HateFindingNames/MotherBoard/README.md

# What the hell is this?
A brief write up of my project assignment for university :woman_shrugging:
