HateFindingNames/MotherBoard/Footage/AwesomeBoard Transmission CAD/readme.md

# Honor where honor is due :bowing_woman:
Solidworks model for Caliber II Trucks by [Myles](https://grabcad.com/library/caliber-trucks-1)

Solidworks model for Orangatang Kegel Wheels by [Danny Andreev](https://grabcad.com/library/orangatang-kegel-80mm-80a-orange-longboard-wheel-1)
