HateFindingNames/MotherBoard/chapters/5_electronics.tex

% LTeX: language=de-DE
\chapter{Elektronik}
\nomenclature[A]{Gegen-EMK}{Gegenwirkende elektromotorische Kraft}%
\nomenclature[A]{AWG}{American Wire Gauge}%
\nomenclature[G]{\(\omega_\text{e}\)}{Elektrische Drehzahl\nomunit{\per\minute}}%
	\nomenclature[G]{\(\omega\)}{Momentane mechanische Drehzahl\nomunit{\per\minute}}%
	Die verwendeten ESC sind in der Lage, die gegenwirkende elektromotorische Kraft (Gegen-EMK) --~eine während des Betriebes in den Wicklungen des Motors induzierte und seiner Drehrichtung entgegenwirkenden Spannung --~zu Messen und zur Positionsbestimmung des Rotors zu nutzen.
	Gegenüber eines trapezoidalen Phasenstromes können die Motorwicklungen so sinusoidal bestromt werden, was wiederum geringere elektrische Verluste und ein gleichmäßigeres Drehmomentprofil während eines Umlaufes und damit einen sanfteren und geräuschärmeren Motorlauf verspricht.
	Prinzipbedingt steigt die Amplitude der rEMK mit der Drehzahl des Motors.
	Konsequenterweise wird so die Messung und damit die Positionsbestimmung im niedrigen Drehzahlbereich erschwert während sie im Stillstand unmöglich wird.
	Um ein exaktes Feedback der Rotorposition an die Steuerelektronik unabhängig der rEMK zu ermöglichen, verfügen die ausgewählten Motoren über integrierte Hall-Effekt-Sensoren.
	Im höheren Drehzahlbereich verschwinden ihre Vorteile zwar zunehmend, liefern jedoch die Möglichkeit eines äußerst sanften Anlaufes aus dem Stillstand heraus.\par\medskip
	%
	\begin{wrapfigure}{r}{.5\textwidth}
		\centering
		
		\caption[Hall-Sensoren Steckverbinder]{Links ein 3x2-Pin Molex Micro-Fit 3.0 Steckverbinder, rechts ein 6-Pin JST-PH \qty{2}{\milli\metre} zur Verbindung mit dem ESC.}
		\label{fig:hall sensor connectors}
	\end{wrapfigure}
	Die ab Werk mit JST-PH \qty{2}{\milli\metre} Steckverbindern ausgestatteten Sensorenleitungen wurden im Sinne einer Staub- und Spritzwassergeschützen Durchführung in das GFK-Gehäuse über eine Kabelbrücke mit den ESC verbunden.
	Die Kabelbrücke wurde aus 30AWG\footnote{\hspace{1mm}Entspricht etwa \qty{0,25}{\milli\metre\squared}.} flexibler Silikonleitung mit einem 6-Pin JST-PH Steckverbinder ESC-seitig und einem 3x2 Molex Micro-Fit 3.0 Steckverbinder motorseitig gefertigt (vgl. \cref{fig:hall sensor connectors}).
	Für den motorseitigen Anschluss wurde eine entsprechende Öffnung in das Gehäuse geschnitten und der Steckverbinder mit Epoxidharz dauerhaft und dicht verbunden.
	Die Anordnung der Sensoren spielt an dieser Stelle eine untergeordnete Rolle, da sie vor Inbetriebnahme softwareseitig konfiguriert werden können.
	Es wird lediglich darauf geachtet, dass die Anordnung beider Motoren identisch bleibt.
	Zur Durchführung der Phasenleitungen werden je Motor drei Löcher in das Gehäuse gebohrt und mit Gummi-Durchführungen versehen.\par\medskip
	%
	Die Leistungsendstufe ist als Doppel-H-Brücke implementiert und in \cref{fig:power mosfets} gezeigt\footnote{\hspace{1mm}Als Gate-Treiber ist ein \textit{DRV8302} von \textit{Texas Instruments} verbaut. Im Datenblatt unter ``STARTUP AND SHUTDOWN SEQUENCE CONTROL'' ist zu lesen, dass alle Gate-Verbindungen Low gehalten werden bis \texttt{EN\_GATE} High ist und \(\geq \qty{10}{\milli\second}\) vergangen sind~\cite{drv8302.datasheet}. Die Low-seitigen Pull-Down Widerstände R30,36,46 dienen vermutlich einem sichergestellt hochohmigen Zustand der Low-Side-FETs im Einschaltmoment als zusätzliche Sicherheitsschicht um Kurzschluss von \texttt{V\_SUPPLY} gegen Ground zu verhindern}.
	Um den Rotor um \qty{360}{\degree} dividiert durch die Anzahl der magnetischen Pole des Rotors \(n_\text{p}\)\nomenclature[L]{\(n_\text{p}\)}{Anzahl der magnetischen Rotorpole\nomunit{1}} zu drehen, muss ein voller Kommutationszyklus durchgeführt werden, was im Folgenden einer elektrischen Umdrehung entsprechen soll.
	Die Anzahl elektrischer Umdrehungen je Minute bei gegebener mechanischer Drehzahl des Rotors sei gegeben durch:
	\begin{align}
		\omega_\text{e} = \omega \, n_\text{p}
		\label{eq:ERPM and RPM}
	\end{align}
	%
	Die Maximalgeschwindigkeit skaliert somit direkt proportional mit \(\omega_\text{e}\) und kann in~\unit{\kilo\metre\per\hour} geschrieben werden als
	\begin{align}
		v_\text{max} = \omega_\text{e} \, \frac{2\pi \, r}{n_\text{p} \, \zeta} \cdot 0,06
		\label{eq:max speed by ERPM}
	\end{align}
	Mit Unterstützung der Konfigurationssoftware der ESC obere Grenzwerte für \(\omega_\text{e}\) zu hinterlegen ist es möglich unmittelbar Werte für die Maximalgeschwindigkeit zu definieren (vgl. \cref{fig:ESC erpm setting}).
