HateFindingNames/MotherBoard/chapters/3_theory.tex

% LTeX: language=de-DE
\chapter{Theorie}\label{sec:theory}
\nocite{Meschede.2015}\nocite{Demtroder.2018}
% ===============================================
% Nomenclatures
% ===============================================
\nomenclature[G]{\(\theta\)}{Hangneigungswinkel\nomunit{rad}}%
\nomenclature[L]{\(F_\text{Hang}\)}{Hangabtriebskraft\nomunit{\newton}}%
\nomenclature[L]{\(G\)}{Gefälle\nomunit{\percent}}%
\nomenclature[G]{\(\mu_\text{Roll}\)}{Rollreibungskoeffizient\nomunit{\metre}}%
\nomenclature[L]{\(F_\text{Ström}\)}{Strömungswiderstand\nomunit{\newton}}%
\nomenclature[G]{\(\rho\)}{Gasdichte\nomunit{\kilo\gram\per\cubic\metre}}%
\nomenclature[L]{\(A\)}{Fläche\nomunit{\square\metre}}%
\nomenclature[L]{\(c_\text{Luft}\)}{Strömungswiderstandkoeffizient\nomunit{1}}%
\nomenclature[L]{\(v\)}{Laterale Geschwindigkeit\nomunit{\metre\per\second}}%
\nomenclature[L]{\(M_\text{Hang}\)}{Drehmoment entlang eines Hanges\nomunit{\newtonmetre}}%
\nomenclature[L]{\(K_\text{V}\)}{Drehzahlkonstante\nomunit{\per\minute\per\volt}}%
\nomenclature[G]{\(\omega_\text{max}\)}{Maximale mechanische Drehzahl\nomunit{\per\minute}}%
\nomenclature[G]{\(\zeta\)}{Untersetzungsverhältnis\nomunit{1}}%
\nomenclature[L]{\(N_\text{Rolle}\)}{Zähneanzahl getriebeseitig\nomunit{1}}%
\nomenclature[L]{\(N_\text{Motor}\)}{Zähneanzahl antriebseitig\nomunit{1}}%
\nomenclature[L]{\(v_\text{max}\)}{Maximalgeschwindigkeit\nomunit{\kilo\metre\per\hour}}%
\nomenclature[L]{\(U_\text{Bat}\)}{Batteriespannung\nomunit{\volt}}%
\nomenclature[L]{\(r_\text{Rolle}\)}{Radius der Rollen\nomunit{\metre}}%
\nomenclature[L]{\(K_\text{T}\)}{Drehmomentkonstante\nomunit{\newtonmetre\per\ampere}}%
\nomenclature[L]{\(M\)}{Drehmoment\nomunit{\newtonmetre}}%
\nomenclature[L]{\(I_\text{Motor}\)}{Phasenstrom\nomunit{\ampere}}%
%
	Die mechanische Gesamtleistung, die vom System auf den Boden übertragen werden muss, ist die Summe unterschiedlicher Einzelfaktoren.
	Neben der erforderlichen Leistung, um die träge Masse von Maschine und Pilot aus dem Stand auf eine gewünschte Geschwindigkeit zu beschleunigen, müssen zusätzliche Reserven zur Verfügung stehen, um mechanische Verluste wie Rollwiderstand zum Untergrund, bei höheren Geschwindigkeiten zunehmend aerodynamische Effekte oder Hangabtriebskräfte während des Befahrens von Steigungen überwinden zu können.\par\medskip
	%
	Die Hangabtriebskraft mit dem Neigungswinkel \(\theta\) ist durch
	\begin{equation}
		F_\text{Hang} = m \, g \, \sin\!\left(\theta\right)%
		\label{eq:downhill force}
	\end{equation}%
	
	gegeben und wird mit der Umrechnung der im Straßenverkehr üblichen Angaben in~\unit{\percent} zu~\unit{\radian} durch \(\arctan\!\left(\frac{G}{\qty{100}{\percent}}\right)\) zu
	\begin{equation}
		F_\text{Hang} = m \, g \, \sin\!\left(\arctan\!\left(\frac{G}{\qty{100}{\percent}}\right)\right).%
		\label{eq:downhill force incline to radian}
	\end{equation}
	\begin{figure}[h]
		\centering
		\includesvg[width=.6\textwidth, inkscapelatex=true]{Calc/torque_incline}
		\caption[Skizze aller wirkenden Kräfte bei einer Fahrt Hangaufwärts]{Skizze aller wirkenden Kräfte bei einer Fahrt Hangaufwärts.}%
		\label{fig:sketch torque incline}
	\end{figure}

	Der Rollwiderstand wird beschrieben durch:
	\begin{equation}
		F_\text{Roll} = m \, g \, c_\text{Roll}
		\label{eq:rolling resistance}
	\end{equation}%
	
	mit dem dimensionslosen Rollwiderstandskoeffizienten \(c_\text{Roll}\) der wiederum das Verhältnis aus Rollreibungskoeffizienten \(\mu_\text{Roll}\) und dem Radius der Rollen nach \(\frac{\mu_\text{Roll}}{r}\) beschreibt.\par\medskip
	%
	Die durch Reibung bei Durchgang eines Körpers durch ein fluides Medium (hier Luft) verursachte, der Bewegung entgegen gerichtete Kraft errechnet sich aus:
	\begin{align}
		F_\text{Ström} = \frac{1}{2} \, c_\text{Ström} \, \rho \, A \, v^2
		\label{eq:air drag}
	\end{align}%

	Nun lässt sich mit bekanntem Radius der Rolle und unter Berücksichtigung von \crefrange{eq:downhill force incline to radian}{eq:air drag} für das rückwirkende Drehmoment schreiben:
	\begin{align}
		M_\text{Hang}	&= \left(F_\text{Hang} + F_\text{Roll} + F_\text{Ström}\right) r \nonumber \\
						&= \left[ m \, g \left( \sin\!\left(\arctan\!\left(\frac{G}{\qty{100}{\percent}}\right)\right) + c_\text{Roll} \right) + \frac{1}{2} \, c_\text{Ström} \, \rho \, A \, v^2 \right] r%
		\label{eq:incline plus roll plus drag torque}
	\end{align}%
	\section{Elektromotorische Zusammenhänge}
		In technischen Dokumentationen zu BLDC-Motoren findet sich häufig die Angabe der Drehzahlkonstante \(K_\text{V}\), die über die Anzahl der Umdrehungen des Rotors je Minute und Volt Phasenspannung Auskunft gibt.
		Die theoretische Maximaldrehzahl des Rotors ergibt sich hiermit zu:
		\begin{align}
			\omega_\text{max} = K_\text{V} \, U_\text{Bat}
			\label{eq:max rpm}
		\end{align}%
		Die mechanische Untersetzung sei das Verhältnis aus der Anzahl der Zähne der zweier gekoppelter Zahnriemenscheiben wie in \cref{eq:reduction}.
		\begin{align}
			\zeta = \frac{N_\text{Rolle}}{N_\text{Motor}}
			\label{eq:reduction}
		\end{align}%
		Mit bekanntem Umfang der Rollen und Berücksichtigung der Untersetzung lässt sich nun die theoretische Maximalgeschwindigkeit unter Vernachlässigung von elektrischen und thermischen Verlusten schreiben als
		\begin{align}
			v_\text{max} = K_\text{V} \, U_\text{Bat} \, 2\pi \, r_\text{Rolle} \, \frac{0,06}{\zeta}
			\label{eq:max speed km h}
		\end{align}%
		wobei der Faktor~\num{0,06} in  die Einheit~\unit{\kilo\metre\per\hour} überführt.
		%
		Fundamental sind Drehzahlkonstante \(K_\text{V}\) und Drehmomentkonstante \(K_\text{T}\) gleich und lassen sich über folgenden Zusammenhang ineinander überführen~\cites{mevey2009sensorless}{DalY.Ohm.2000}{AN885.BLDC.fundamentals}:
		\begin{align}
			K_\text{T}	&= \frac{60}{2\pi} \, \frac{3}{2} \, \frac{1}{\sqrt{3}} \, \frac{1}{K_\text{V}} \nonumber \\
				&\approx 8,27 \, \frac{1}{K_\text{V}}
			\label{eq:kv to kt}
		\end{align}%
		Der Faktor \(\frac{3}{2}\) korrigiert für den Fall einen sinusoidalen Spannungsverlaufs der Kommutation\footnote{\hspace{1mm}Faktor 2 bei trapezoidalem Spannungsverlauf und --~interessant genug --~damit ein höheres Drehmoment.}~\cites{mevey2009sensorless}{DalY.Ohm.2000}, die Spannung zwischen einer Phase und dem~(nicht nach außen geführten) Neutralpunkt ist im Falle eines 3-Phasen Motors um den Kehrwert des Verkettungsfaktors \(\frac{1}{\sqrt{3}}\) kleiner.
		Letztlich wird mit \(\frac{60}{2\pi}\) in die Einheit~\unit{\newtonmetre\per\ampere} überführt.\par\medskip
		%
		Das vom System erzeugte, verlustfreie Drehmoment errechnet sich aus obigem zu:
		\begin{align}
			M	&= K_\text{T} \, I_\text{Motor} \, \zeta
			\label{eq:frictionless torque}
		\end{align}
