HateFindingNames/MotherBoard/pre-page-layout.tex

%A4: 210x297 (BxH)
% \setlength{\voffset}{-2.532 cm}
% \setlength{\hoffset}{-1.57 cm}
\setlength{\voffset}{-2.5 cm}
\setlength{\hoffset}{-2 cm}
% \setlength{\topmargin}{2.0 cm} \setlength{\topskip}{0.1 cm}
\setlength{\topmargin}{1.5 cm}
\setlength{\topskip}{0.1 cm}
\setlength{\evensidemargin}{1.5 cm}
\setlength{\oddsidemargin}{1.5 cm}
%  \setlength{\textwidth}{16.5 cm}
\setlength{\textwidth}{16.0 cm}
\setlength{\footskip}{40pt}
\setlength{\textheight}{24.7cm}
% \setlength{\textheight}{23.5 cm}
\setcounter{page}{1}
\setlength{\parindent}{0.5cm}
\setlength{\headsep}{20pt}
%------------------ Kopf- und Fusszeilen
\setkomafont{pageheadfoot}{\footnotesize\sffamily}
% \renewcommand{\footnote}[1]{\footnote{\quad#1}}
\counterwithout{footnote}{chapter}
%------------------------------------------------------------------------
% Linien in der Kopf- und Fußzeile
%\renewcommand{\headrulewidth}{0.0pt}   %Linie in der Kopfzeile mit 0.0pt keine Linie
%%\renewcommand{\footrulewidth}{0.0pt}   %Linie in der Fußzeile mit 0.0 pt keine Linie
%\renewcommand{\headrulewidth}{0.2pt}   %Linie in der Kopfzeile mit 0.0pt keine Linie
%\renewcommand{\footrulewidth}{0.2pt}   %Linie in der Fußzeile mit 0.0 pt keine Linie
%------------------------------------------------------------------------
%\renewcommand{\normalfont}{\sffamily} %für die Überschriften
%\renewcommand{\chaptermark}[1]{\markboth{\chaptername\ \thechapter #1}{}}
%\renewcommand{\sectionmark}[1]{\markright{\thesection\ #1}}
% \rfoot{\leftmark\\\rightmark}

%Definitionen für Kopfzeile
% bei documentclass {report} hat der Eintrag für die [gerade Seite] keine Wirkung
%-------------------------------------------------------------
%%
