HateFindingNames/MotherBoard/__MAIN_FILE.tex

\documentclass[paper=a4,11pt,titlepage,twoside=true,headings=normal,numbers=noenddot,captions=tableabove,listof=totoc,index=totoc,bibliography=totoc, ngerman]{scrreprt}
%-----------------------------------------------------------------
\usepackage{etoolbox}
\newbool{deutsch}
\booltrue{deutsch}	% comment out to switch document to english
%-----------------------------------------------------------------
\input{pre-packages}
\input{pre-variables}
\input{pre-page-layout}
\input{pre-header-footer-2010}
\input{pre-header-footer-text-report}
\input{pre-nomenclature-layout}
% \input{pre-other-layouts}
\DeclareNameAlias{author}{family-given}
\DeclareNameAlias{editor}{family-given}
\DeclareNameAlias{translator}{family-given}
\addbibresource{literature.bib}
%------DEBUGGING--------------------------------------------------
% \usepackage[showframe]{geometry} % comment out for live version
% \usepackage{layout}
% \usepackage{showframe}
% \usepackage[export]{adjustbox} % adds aside others the <frame> option to \includegraphics[]{}. this makes there borders visible and helps debugging/aligning
%-----------------------------------------------------------------
\begin{document}
%-----------------------------------------------------------------
\input{chapters/0_top}
\clearpage\pagenumbering{Roman}
\tableofcontents
\listoffigures
\listoftables
\printnomenclature[5cm]
%-----------------------------------------------------------------
\clearpage\pagenumbering{arabic}
\include{chapters/1_intro}
\include{chapters/2_conception}
\include{chapters/3_theory}
\include{chapters/4_mechanics}
\include{chapters/5_electronics}
\include{chapters/6_eval}
\include{chapters/7_conclusion}
%-----------------------------------------------------------------
\newpage
\include{chapters/appendix}
\printbibliography%
%=================================================================
\end{document}
