HateFindingNames/MotherBoard/PA.pdf

## Konzeption und Realisierung eines Antriebssystems für ein elektrisches Longboard

## łMotherBoardž

Projektarbeit

Autor

## Dennis Hunter

Hochschule RheinMain
Fachbereich Ingenieurwissenschaften Studienbereich Angewandte Physik & Medizintechnik

### 11. Oktober 2022

## Inhaltsverzeichnis

Abbildungsverzeichnis | II
Tabellenverzeichnis | III
Nomenklatur | IV
1 Einleitung | 1
2 Konzeption | 2
3 Theorie | 8
4 Mechanik | 10
5 Elektronik | 19
6 Evaluation | 21
7 Zusammenfassung | 24
A Anhang | 25
Literatur | 28

## Abbildungsverzeichnis

2.1 Grundlegender Aufbau eines Longboards | | 2
2.2 Explosionsansicht eines der Trucks | | 3
2.3 Montage der Rollen an der Achse des Hanger | | 4
2.4 Der verbaute Lithium-Ionen Zellverband | | 5
2.5 Eingesetzte ESC | | 6
3.1 Skizze aller wirkenden Kräfte bei einer Fahrt Hangaufwärts | | 8
4.1 Gegenüberstellung von Innenläufer und Außenläufer | | 10
4.2 Relevante Dimensionen des Motors TorqueBoards 6355 190KV | | 11
4.3 Quotient aus Strömungs- und Rollwiderstand als Funktion der Geschwindigkeit . . . . | 12
4.4 Am Hang wirkende Momente und Maximalgeschwindigkeit als Funktion von ζ . . . . | 13
4.5 Rück- und Schnittansicht der Kegel des Herstellers Orangatang | | 13
4.6 Zeichnung der modellierten Zahnriemenscheibe | | 14
4.7 Vergleich der Passform einer gekauften mit einer 3D-gedruckten Zahnriemenscheibe . | 14
4.8 Zeichnung des Gegenstücks der Zahnriemenscheibe | | 15
4.9 Mittelpunktabstand zwischen antriebs- und getriebeseitigen Zahnriemenscheiben . . . | 16
4.10 Zange zur Montage der Motorhalterung am Hanger | | 16
4.11 Verbindungsarm zwischen Motor und Hangerzange | | 17
4.12 Zeichnung des Gesamtaufbaus | | 17
4.13 Fertiger Aufbau des Antriebssystems | | 18
5.1 Hall-Sensoren Steckverbinder | | 19
6.1 Aufgetragene Logging-Informationen einer Testfahrt | | 21
6.2 Vergleich der gedruckten Zahn- und Konterscheiben vor und nach mehreren Testfahrten 22
A.1 Schaltplan der Leistungsendstufe des ESC | | 25
A.2 Testparameter, wie sie in der Kongurationssoftware der ESC eingetragen wurden . . . | 26
A.3 In-Software begrenzte elektrische Drehzahl | | 27

## Tabellenverzeichnis

2.1 Zellspezikationen Samsung INR18650-30Q | | 5
4.1 Motorspezikationen TorqueBoards 6355 190KV | | 11
4.2 Tabelle der verwendeten Werte zur Abschätzung des Strömungs- und Rollwiderstandes | 12
6.1 Kostenaufstellung der Einzelteile | | 23

## Nomenklatur

Abkürzungen
ABS | Acrylnitrilbutadienstyrol
AWG | American Wire Gauge
BLDC | Brushless Direct Current
BS | Board Side
ePKW | Elektrische Personenkraftwagen
ESC | Elektronischer Speed Controller
FDM | Fused Deposition Modeling
Gegen-EMK | Gegenwirkende elektromotorische Kraft
HTD | High Torque Drive
PEKV | Persönliche elektrische Kleinstvehikel
PEV | Persönliche elektrische Vehikel
RS | Road Side

Griechische Zeichen
µRoll | Rollreibungskoezient | [m]
ω | Momentane mechanische Drehzahl | - min−1
ωe | Elektrische Drehzahl | - min−1
ωmax | Maximale mechanische Drehzahl | - min−1
ρ | Gasdichte | - kg m−3
θ | Hangneigungswinkel | [rad]
ζ | Untersetzungsverhältnis | [1]

Lateinische Zeichen
A | Fläche | - m²
cLuft | Strömungswiderstandkoezient | [1]
FHang | Hangabtriebskraft | [N]
FStröm | Strömungswiderstand | [N]
G | Gefälle | [%]
IMotor | Phasenstrom | [A]
KT | Drehmomentkonstante | - Nm A−1
KV | Drehzahlkonstante | - min−1 V−1
M | Drehmoment | [Nm]

Hochschule RheinMain

MHang | Drehmoment entlang eines Hanges | [Nm]
NMotor | Zähneanzahl antriebseitig | [1]
np | Anzahl der magnetischen Rotorpole | [1]
NRolle | Zähneanzahl getriebeseitig | [1]
rRolle | Radius der Rollen | [m]
s | Zurückgelegte Strecke | [m]
UBat | Batteriespannung | [V]
v | Laterale Geschwindigkeit | - m s−1
vmax | Maximalgeschwindigkeit | - km h−1
Studienbereich Angewandte Physik & Medizintechnik | V von 29

## 1 Einleitung

Weltweit ndet derzeit auf politischer wie gesellschaftlicher Ebene ein Umdenken im Transportwesen statt – sei es der Transport von Gütern, Fahrgästen oder im Individualverkehr. Angefeuert durch den unmittelbaren monetären Druck durch steigende Treibstopreise, die immer deutlicher werdenden Folgen fortdauernder CO2-Emissionen aber auch Lebensqualität beeinussende Faktoren wie Staus und abnehmende Luftqualität in urbanen Gebieten treibt eine wachsende Zahl Menschen aus Auto heraus auf alternative Transportmöglichkeiten. Neben der klassischen Möglichkeit des Fahrrades kam mit erheblichen Verbesserungen und der deutlich breiteren Verfügbarkeit der Lithiumbatterie-Technologie ein Wandel des gesellschaftlichen Lebens einher, wie es vergleichbar zuletzt geschah, als das Smartphone die Bühne der Welt betrat - die Elektrizierung des Individualverkehrs. Nachdem einige Vorreiterstädte bereits früh mit baulichen Maßnahmen etwa durch Herabsetzen innerörtlicher Geschwindigkeitsbegrenzungen, Ausbau von Fahrradwegen oder Zuwachs öentlicher Verkehrsmittel reagierten, ziehen nun immer mehr Städte nach. Dieser wechselseitige Trend bildet sich auch in der politischen Stimmung ab mit einer der wichtigsten Novellen für das öentliche Verkehrsbild, die die “Verordnung über die Teilnahme von Elektrokleinstfahrzeugen am Straßenverkehr und zur Änderung weiterer straßenverkehrsrechtlicher Vorschriften” von 2019 mit sich zog [1]. Sie leutete den Advent breit verfügbarer persönlicher elektrischer Kleinstvehikel (PEKV) zur Überbrückung der “letzten Meile” ein.

Die Kategorie elektrizierter persönlicher Fahrzeuge lässt sich grob unterteilen in elektrische Personenkraftwagen (ePKW), persönliche elektrische Vehikel (PEV) und – wie oben bereits erwähnt – die persönlichen elektrischen Kleinstvehikel in der kleinsten Variante. Zwar dominiert die erste Gruppe gegenwärtige politische Bemühungen zum Thema, gerade im städtischen Raum bieten sie jedoch kaum bis kein Potenzial, Infarkte des Straßenverkehrs zu vermeiden. Die Ladeinfrastruktur ist noch nicht einheitlich und ächendeckend geregelt und allem voran sind sie preislich für breite Teile der Bevölkerung unattraktiv. Vielversprechender sind Vertreter der beiden letztgenannten Gruppen. Dem Statistischen Bundesamt zufolge besaßen zu Jahresanfang 2020 etwa jeder neunte deutsche Haushalt oder 11,4 % zumindest ein elektrisch angetriebenes Fahrrad. Während sie Anfang 2015 mit ≈ 4 % noch in etwa jedem 25. Haushalt aufzunden waren, kann hier eine Verbreitung um fast das Dreifache verzeichnet werden [2].

## 2 Konzeption

Um Konsistenz mit Literatur und Marktrecherchen sicherzustellen werden im Rahmen dieser Arbeit technische Begrie aus dem Skater-Jargon genutzt. Zu einigen Komponenten existieren keine denierte deutschsprachigen Begrie. Daher wird im Folgenden zunächst Fokus auf eine Begriskonvention gelegt und in diesem Rahmen funktionale Kernkomponenten eines Skate- bzw. Longboards¹
erläutert. Freie
Übersetzungen des Autors sind kursiv und benden sich in Klammer.

Das Antriebssystem soll in ein vorgegebenes, übergeordnetes System bestehend aus mechanischen und elektronischen Komponenten eingebettet werden. Sowohl das übergeordnete System, als auch die Einsatzumgebung denieren konstruktive Einschränkungen, die in einem weiteren Unterkapitel herausgearbeitet werden sollen.

Zuletzt werden vor dem Hintergrund zuvor festgelegter Rahmenbedingungen und unterstützt durch Markt- und Literaturrecherche Designziele deniert und erste Designideen konkretisiert.

### 2.1 Funktionale Komponenten eines Longboards

Historisch ergaben sich esoterische lautende Namenskonventionen für Teilkomponenten von Skate- und Longboards. Während sie im einfachsten Fall unabhängig des Sprachraumes mit ihren jeweiligen englischen Begrien zu nden sind, weichen Bezeichnungen bisweilen stark von in der Industrie verbreiteten Bezeichnungen ab. Um jener Namenskonvention zu folgen, sollen hier zunächst die Teilkomponenten kurz beschrieben werden.

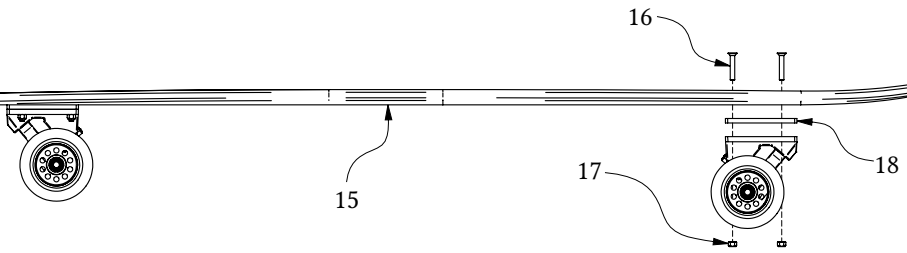
[picture p1: figure]

Abbildung 2.1: Grundlegender Aufbau eines Longboards. 15 Deck (dt. Bre), 16 Truck Bolt (meist Senkschrauben mit Innensechskant), 17 Truck Bolt Nut (dt. Sechskantmuer mit Klemmteil), 18 Riser Pad (dt. Unterlage).

Abbildung 2.1 zeigt den grundlegenden Aufbau eines Longboards. Erkennbar sind hier vordergründig das Deck (dt. Brett) (15), welches die fahrende Person trägt und hierbei einen Großteil der wirkenden Kräfte aufnehmen muss. Je nach Fahrstil werden weichere oder härtere Materialien gewünscht um etwa

1 Baulich zwar leicht zu unterscheiden, jedoch aus den gleichen Kernkomponenten und -funktionalitäten aufgebaut.

Unebenheiten des Untergrundes auszugleichen oder die Ausführung von Tricks² positiv zu beeinussen.

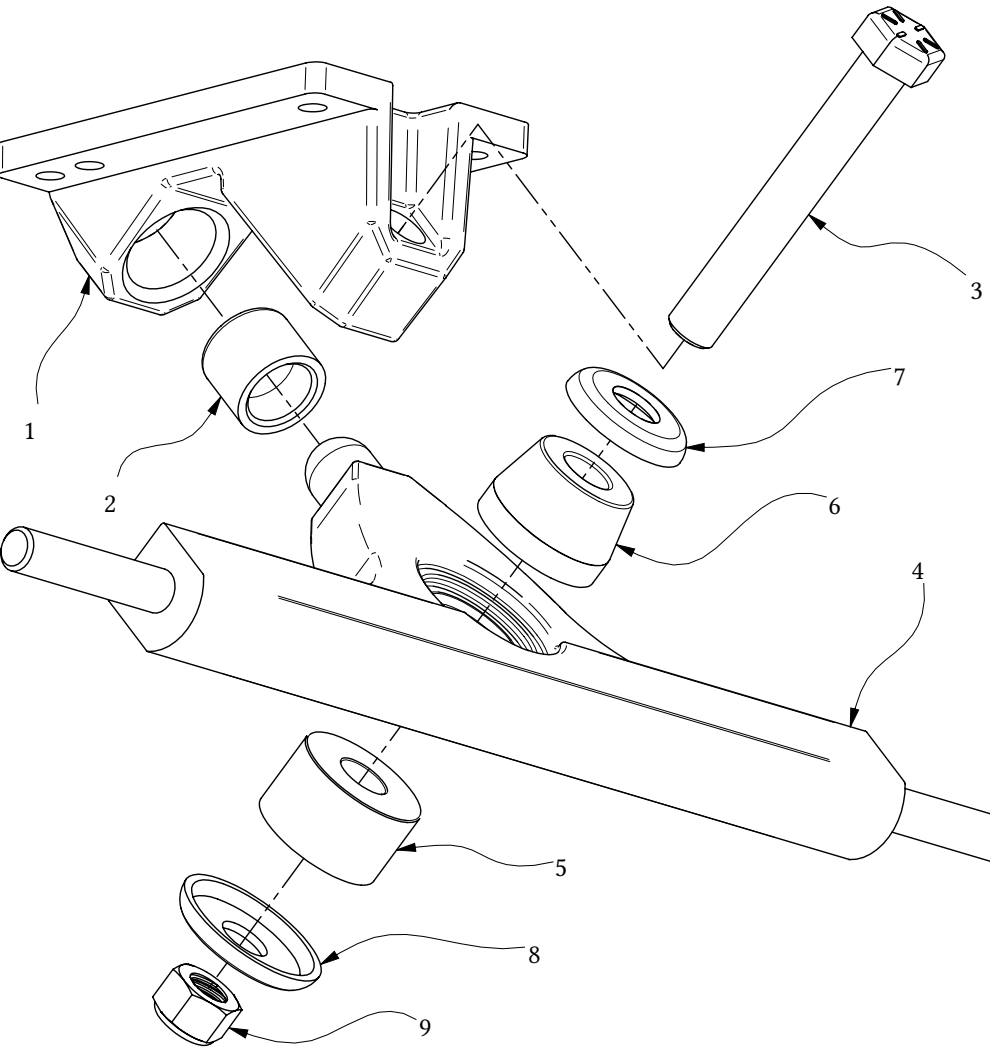
[picture p2: figure]

Abbildung 2.2: Aufbau eines der Trucks als Explosionsansicht exemplarisch an einem Caliber II. Sichtbar sind hier: 1 Baseplate (dt. Basisplae), 2 Pivot Cup (dt. Drehpunktbecher), 3 Kingpin (o eigens angefertigte Außensechskantschraube), 4 Hanger (dt. Bügel), 5 RS Bushing (dt. straßenseitiger Lenkgummi), 6 BS Bushing (dt. breseitiger Lenkgummi), 7 BS Washer (dt. breseitige Unterlegscheibe), 8 RS Washer (dt. straßenseitige unterlegscheibe), 9 Kingpin Nut (dt. Sechskantmuer mit Klemmteil).

Meist kommt hier Schichtholz mit oder ohne eingearbeiteten Glas-, Aramid- oder Kohlefasergewebes zum Einsatz, es sind bisweilen aber auch exotischere Materialien wie Aluminium oder ABS³ vertreten. In Abb. 2.1 benden sich links und rechts, zentral entlang der Längsachse des Decks angeordnet die Trucks genannten Baugruppen zusammen mit jeweils zwei Rollen. Eine mechanisch belastbare Verbindung zum Deck wird durch Truck Bolts (meist Senkschrauben mit Innensechskant) (16) und Truck Bolt Nuts (Sechskantmutter mit Klemmteil) (17) hergestellt. Gegenüber den mit deutlich kleineren Rollen ausgestatteten Skateboards ist es im Longboarding üblich zwischen Deck und Truck Riser Pads (dt. Unterlagen) (18) einzusetzen. Hierbei handelt es sich um aus exiblem Material verschiedener Härtegrade gefertigte Puerplatten mit Doppelfunktion: Einerseits unterstützen sie die Entkopplung der Füße von

2 Über die rein laterale Fortbewegung hinausgehende, meist kunstvoll ausgeführte Bewegungen des Boards mit und unter den Füßen.
3 Acrylnitrilbutadienstyrol.
Studienbereich Angewandte Physik & Medizintechnik | 3 von 29

Vibration und verhindern andererseits sogenannte Wheel Bites - ein Kontakt des Decks mit den Rollen während eines Lenkmanövers mit meist fataler Konsequenz.
Der Aufbau der Trucks selbst wird in Abb. 2.2 exemplarisch am Typ Caliber II gezeigt. Der Hanger (dt. Bügel) (4) bildet hier das zentrale Bauteil und muss den Großteil der wirkenden Kräfte aufnehmen. Er wird drehbar und gleitend in der Baseplate (dt. Basisplatte) (1) gelagert. Direkter Kontakt zwischen Hanger und Baseplate hätte erhöhten Abrieb und reduziertes Gleitverhalten zur Konsequenz wozu hier ein meist aus POM⁴ gefertigter Pivot Cup (2) eingesetzt wird. In Position gehalten wird der Hanger mittels Kingpin (oft eigens angefertigte Außensechskantschraube) (3) und Kingpin Nut (dt. Sechskantmutter mit Klemmteil) (9). Das Rückstellmoment nach Ende eines Lenkmanövers wird durch zwei Bushings – vergleichsweise dicke Gummiringe – erzeugt, die mit der Kingpin-Achse koaxial beidseitig mit dem Hanger in mechanischem Kontakt stehen. Deckseitig bendet sich der BS Bushing (dt. brettseitiger Lenkgummi) (6), straßenseitig angeordnet der RS Bushing (dt. straßenseitiger Lenkgummi) (5). Die Präxe stehen für Board Side bzw. Road Side und spiegeln ihre jeweiligen Positionen innerhalb der Baugruppe wider. Unterschieden wird hier, da sich verschiedene Geometrien und Härtegrade der Bushings abhängig ihrer Position merklich auf das Fahrgefühl und Lenkvermögen auswirken können⁵ .
Um die Lasten ächig auf die Oberäche der Bushings zu verteilen, werden RS und BS Washer (dt. straßen- und brettseitige Unterlegscheiben) (7,8), üblicherweise tellerförmige Scheiben, auf der dem Hanger abgewandten Seite platziert.

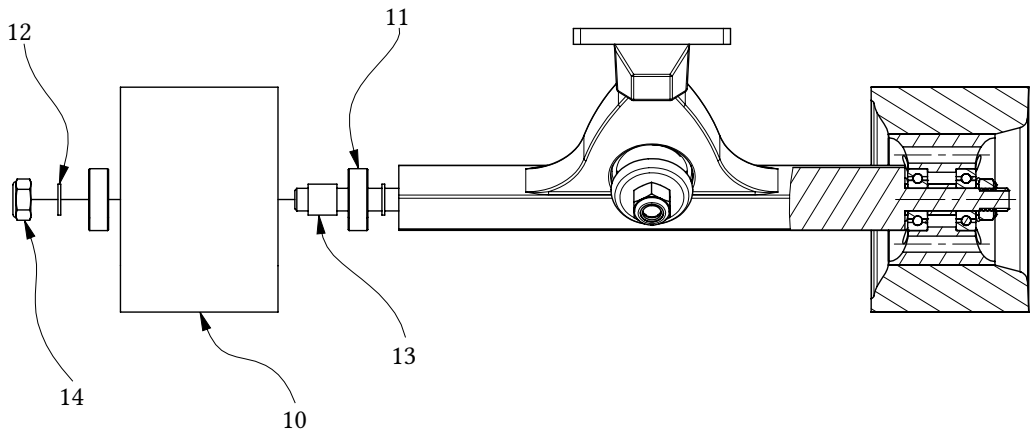
[picture p3: figure]

Abbildung 2.3: Montage der Rollen an der Achse des Hangers. Links in explodierter und rechts in Schniansicht. Zu sehen sind: 10 Rolle, 11 Kugellager, 12 Speedring (dt. Distanzring), 13 Spacer (dt. Abstandhalter), 14 Achsmuer.

Je nach gewünschter Laufruhe und in Abwägung zwischen Traktion und Rollwiderstand werden Rollen verschiedener Größen und Materialien drehbar auf den Hanger-Achsen gelagert. Mit Blick auf Abb. 2.3 wird konzentrisch in den Kern der Rolle (10) – vergleichbar mit einer Felge, die das weichere Mantelmaterial trägt – beidseitig jeweils ein Radialrillenkugellager (11) platziert. Hier hat sich historisch über quasi-sämtliche Rollenbauerten hinweg das 608-Kugellager durchgesetzt. Um potenziell den Lagern gegenüber destruktive axiale Kräfte in Kurven oder durch das Anzugsmoment der Achsmutter (14) zu minimieren, wird, ebenfalls in den Kern der Rolle und zwischen die beiden Lager, der Spacer (dt. Abstandhalter) (13) angeordnet. Er besteht aus hartem Metall, hat einen Innendurchmesser gleich des nominellen Durchmessers der Hanger-Achse, eine Wandstärke von ≈ 1 mm und eine Länge, die gerade so gewählt ist, dass er an beiden Flanken mit den Innenringen der Lager in Kontakt steht, wenn sie beide vollständig im Kern eingelassen sind. Ein schleireies Laufen der Lager wird durch Speedrings (dt. Distanzring) (12) sichergestellt. Ihre Dimensionen entsprechen denen des Spacers, allerdings mit einer deutlich geringeren Länge von nur 1 mm. Letztlich werden alle Komponenten mit einer Achsmutter auf

4
Polyoxymethylen.
5 Durch Drehen der Kingpin Nut und damit einer Änderung der Vorspannung der Bushings kann hier auch im Feld relativ unkompliziert nachjustiert werden
4 von 29 | Studienbereich Angewandte Physik & Medizintechnik

der Hanger-Achse xiert.

### 2.2 Konstruktive Rahmenbedingungen

Das Antriebssystem soll in ein bestehendes System aus Batterie, Batteriemanagement, Motorcontrollern und Deck integriert und an die Einsatzbedingungen angepasst werden. Hieraus ergeben sich bei der Planung zu berücksichtigende konstruktive Rahmenbedingungen.

### 2.2.1 Bestehendes System

Die Batterie besteht aus 40 Lithium-Ionen Zellen in 10S4P-Konguration vom Typ Samsung INR18650-30Q mit einer nominellen Zellspannung von 3,6 V, einer Mindestzellentladekapazität von 2950 mAh und einem maximalen Entladestrom von 15 A (vgl. Tabelle 2.1 [3]). 10S4P meint hier jeweils vier Zellen

Tabelle 2.1: Zellspezifikationen Samsung INR18650-30Q [3].

Charakteristik | Spezikationen
Minimale Entladekapazität | 2950 mAh
Nominelle Zellspannung | 3,6 V
Standard Ladebedingungen | CC/CV, 1,5 A, (4,20 ± 0,05) V
Maximale Ladebedingungen | CC/CV, 4 A, (4,20 ± 0,05) V
Maximaler Dauerentladestrom | 15 A bei 25 ◦C
Minimale Zellspannung | 2,5 V
Gewicht | 48 g
Betriebstemperatur | Laden: 0 ◦C bis 50 ◦C, Entladen: −20 ◦C bis 75 ◦C

parallel geschaltet mit 10 jener Sub-Zellen elektrisch in Serie (vgl. hierzu Abb. 2.4). So ergibt sich eine nominelle Spannung der Batterie von 36 V, eine Kapazität von 11,8 Ah und eine gespeicherte Energie von ≈ 425 Wh bei einem maximalen Dauerentladestrom von 60 A.

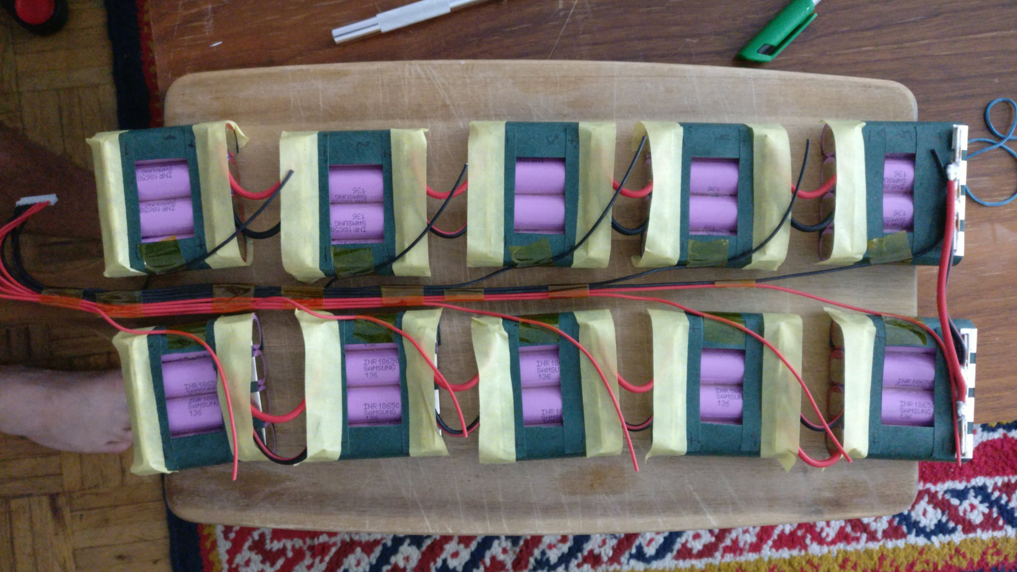
[picture p4: figure]

Abbildung 2.4: Der verbaute Lithium-Ionen Zellverband. Zu erkennen sind die 10 Sub-Zellen bestehend aus jeweils vier Einzelzellen.

Das Drehmoment soll durch Elektromotoren erzeugt werden, die von zwei elektronischen Speed

Studienbereich Angewandte Physik & Medizintechnik | 5 von 29

Controllern (ESC) des Typs FSESC 4.12⁶
angesteuert werden. ESC sind elektronische Komponenten vornehmlich zur elektronischen Kommutation von bürstenlosen Gleichstrommotoren (Brushless Direct Current, BLDC). Als solche schränken sie die Auswahl der Motortypen zwar nicht exklusiv auf BLDCs

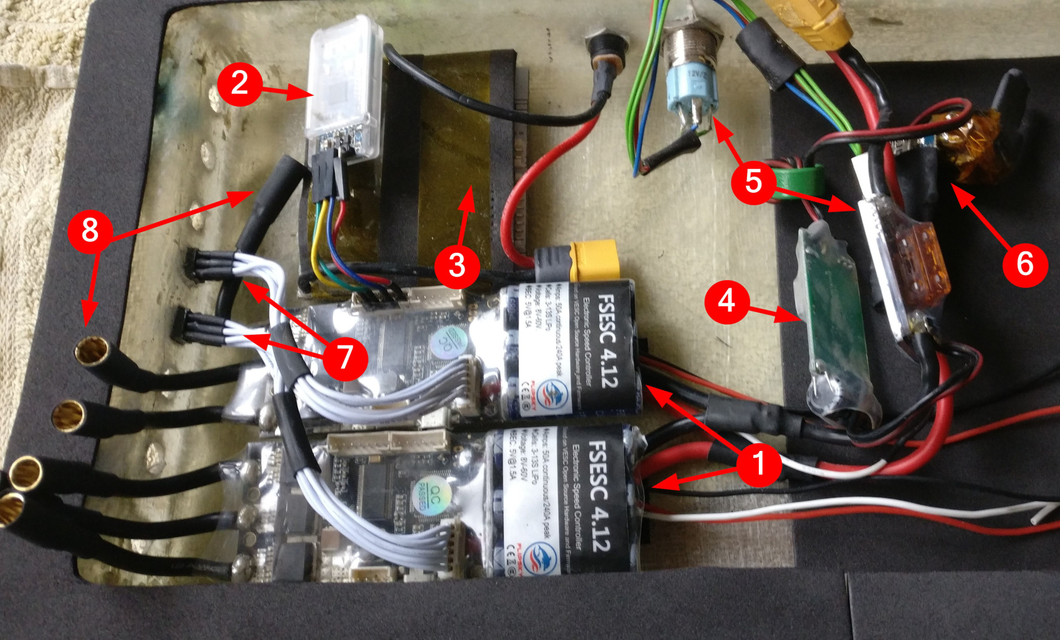
[picture p5: figure]

Abbildung 2.5: (1) die eingesetzten ESC vom Typ FSESC 4.12, (2) ein HC-06 Bluetooth Modul, (3) passives Baeriemanagementsystem zur Regelung des Ladestromes, (4) 5 V Spannungsregler, (5) elektronischer Ein-Aus-Schalter mit zwei parallel geschalteten 80 A Sicherungen, (6) Arduino Nano mit NRF24 Transceiver, (7) Steckverbinder der Hall-Eekt-Sensoren, (8) Phasenanschlüsse der Motoren.

ein – Gleichstrommotoren mit Schleifkontakt sind auch denkbar – allerdings bieten sie in Kombination mit BLDCs einen deutlich höheren Funktionsumfang. Darüber hinaus sind BLDC gegenüber Gleichstrommotoren mit Schleifkontakten ezienter, bieten eine höhere Leistungsdichte, sind bauartbedingt unempndlich gegenüber Nässe und quasi-wartungsfrei⁷

### 2.2.2 Einsatzumgebung und -bedingungen

Das Gewicht des Fahrers wird inklusive Kleidung und transportiertem Gepäck mit 90 kg angenommen. Zuzüglich ≈ 5 kg durch Deck, Batterie und Elektronik und pessimistisch geschätzte weitere 5 kg durch die beiden Trucks zusammen mit dem Antriebssystem ergibt sich ein geschätztes, vom Antriebssystem zu beschleunigendes Gesamtgewicht von ≈ 100 kg.
Weiter soll die fertige Maschine auf in urbanen Gebieten üblichen Untergründen betrieben werden können. Es wird also mit leichten bis moderaten Steigungen und in Form des Bodenbelages mit Asphalt und Kopfsteinpaster gerechnet.

Mit Abwesenheit einer Lenkstange und einer “bauartbedingten” Höchstgeschwindigkeit von “nicht weniger als 6 km h−1
” ist die Maschine nach geltender Verordnung zulassungspichtig, jedoch nicht zulassungsfähig [1]. Damit soll die Maschine vorrangig als Sportgerät für milde bis sonnige Wetterlagen geeignet sein. Extrembedingungen wie Starkregen, Schnee oder Eisglätte nden hier keine weitere Beachtung.

6 Die wiederum industriell gefertigte 1:1 Nachbauten des populären Open-Source ESC “VESC” von Benjamin Vedder sind [4, 5, 6].
7
Je nach Art der Lagerung. Dies betrit jedoch ausschließlich die mechanischen Komponenten der Motoren.
6 von 29 | Studienbereich Angewandte Physik & Medizintechnik

### 2.3 Designziele

Mit in Abschnitt 2.2 genannten Einschränkungen können einige Soll-Forderungen formuliert werden. So muss das System. . .

- . . .in der Lage sein, mindestens das angenommene Gesamtgewicht von 100 kg moderate Steigungen hinauf befördern zu können. Als Designrichtlinie wird hier ein Gefälle von 5 % festgelegt.
- . . . entlang ebenen Asphaltes auf mindestens 25 km h−1 beschleunigen können⁸
. In Kombination mit obiger Forderung wird hier auf das Festlegen eines Zeitintervalls, innerhalb dessen die Endgeschwindigkeit erreicht werden soll, verzichtet.
- . . . einfach zu Warten sein.

Neben den harten Zielen ist wünschenswert, dass das System. . .

- . . .möglichst aus selbst herstellbaren Komponenten besteht.
- . . . kostengünstig ist. Als Richtwert soll hier 300 EUR angelegt werden.
- . . . die von der Batterie zur Verfügung gestellte Energie von 425 Wh bezogen auf die erreichbare Reichweite möglichst ezient nutzt.

8 Womit die Maschine nach derzeitiger deutscher Gesetzeslage nicht mehr als Elektrokleinstfahrzeug kategorisiert werden kann [1].

Studienbereich Angewandte Physik & Medizintechnik | 7 von 29

## 3 Theorie

Die mechanische Gesamtleistung, die vom System auf den Boden übertragen werden muss, ist die Summe unterschiedlicher Einzelfaktoren. Neben der erforderlichen Leistung, um die träge Masse von Maschine und Pilot aus dem Stand auf eine gewünschte Geschwindigkeit zu beschleunigen, müssen zusätzliche Reserven zur Verfügung stehen, um mechanische Verluste wie Rollwiderstand zum Untergrund, bei höheren Geschwindigkeiten zunehmend aerodynamische Eekte oder Hangabtriebskräfte während des Befahrens von Steigungen überwinden zu können.
Die Hangabtriebskraft mit dem Neigungswinkel θ ist durch
FHang = m g sin(θ) | (3.1)

gegeben und wird mit der Umrechnung der im Straßenverkehr üblichen Angaben in % zu rad durch arctan
G

100 %
zu

FHang = m g sin

arctan

G
100 % . | (3.2)

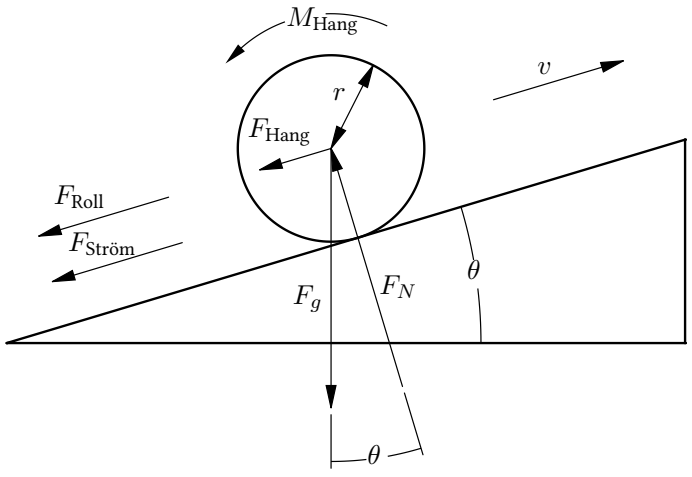
[picture p6: figure]
FHang; MHang; FStröm; FRoll

Abbildung 3.1: Skizze aller wirkenden Kräe bei einer Fahrt Hangaufwärts.

Der Rollwiderstand wird beschrieben durch:

FRoll = m g cRoll | (3.3)

mit dem dimensionslosen Rollwiderstandskoezienten cRoll der wiederum das Verhältnis aus Rollreibungskoezienten µRoll und dem Radius der Rollen nach µRoll
r

beschreibt.
Die durch Reibung bei Durchgang eines Körpers durch ein uides Medium (hier Luft) verursachte, der Bewegung entgegen gerichtete Kraft errechnet sich aus:

FStröm =

1
2
cStröm ρ A v² | (3.4)

Nun lässt sich mit bekanntem Radius der Rolle und unter Berücksichtigung von Gl. 3.2 bis 3.4 für das rückwirkende Drehmoment schreiben:

MHang =

FHang + FRoll + FStröm
r

=

m g

sin

arctan

G
100 % + cRoll
+

1
2

cStröm ρ A v²

r | (3.5)

### 3.1 Elektromotorische Zusammenhänge

In technischen Dokumentationen zu BLDC-Motoren ndet sich häug die Angabe der Drehzahlkonstante KV, die über die Anzahl der Umdrehungen des Rotors je Minute und Volt Phasenspannung Auskunft gibt. Die theoretische Maximaldrehzahl des Rotors ergibt sich hiermit zu:

ωmax = KV UBat | (3.6)

Die mechanische Untersetzung sei das Verhältnis aus der Anzahl der Zähne der zweier gekoppelter Zahnriemenscheiben wie in Gl. 3.7.

ζ =

NRolle NMotor | (3.7)

Mit bekanntem Umfang der Rollen und Berücksichtigung der Untersetzung lässt sich nun die theoretische Maximalgeschwindigkeit unter Vernachlässigung von elektrischen und thermischen Verlusten schreiben als

vmax = KV UBat 2π rRolle

0, 06
ζ
| (3.8)

wobei der Faktor 0,06 in die Einheit km h−1 überführt. Fundamental sind Drehzahlkonstante KV und Drehmomentkonstante KT gleich und lassen sich über folgenden Zusammenhang ineinander überführen [9, 10, 11]:

KT =

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
≈ 8, 27

1 KV | (3.9)

Der Faktor 3
2
korrigiert für den Fall einen sinusoidalen Spannungsverlaufs der Kommutation⁹ | [9, 10],
die Spannung zwischen einer Phase und dem (nicht nach außen geführten) Neutralpunkt ist im Falle eines 3-Phasen Motors um den Kehrwert des Verkettungsfaktors √

1
3

kleiner. Letztlich wird mit 60
2π
| in die
Einheit Nm A−1 überführt.

Das vom System erzeugte, verlustfreie Drehmoment errechnet sich aus obigem zu:

M = KT IMotor ζ | (3.10)

9
Faktor 2 bei trapezoidalem Spannungsverlauf und – interessant genug – damit ein höheres Drehmoment.
Studienbereich Angewandte Physik & Medizintechnik | 9 von 29

## 4 Mechanik

Wie in Abschnitt 2.2 besprochen, beschränkt sich die Auswahl möglicher Antriebselemente praktischerweise auf BLDC-Motoren, die wiederum auf dem Markt als Innen- und Außenläufer erhältlich sind. In ersteren sind die Statorwicklungen an der Außenseite angeordnet, zweitere ordnen sie an der Innenseite an. Das grundlegende Funktionsprinzip bleibt so zwar unverändert, durch den vergrößerten

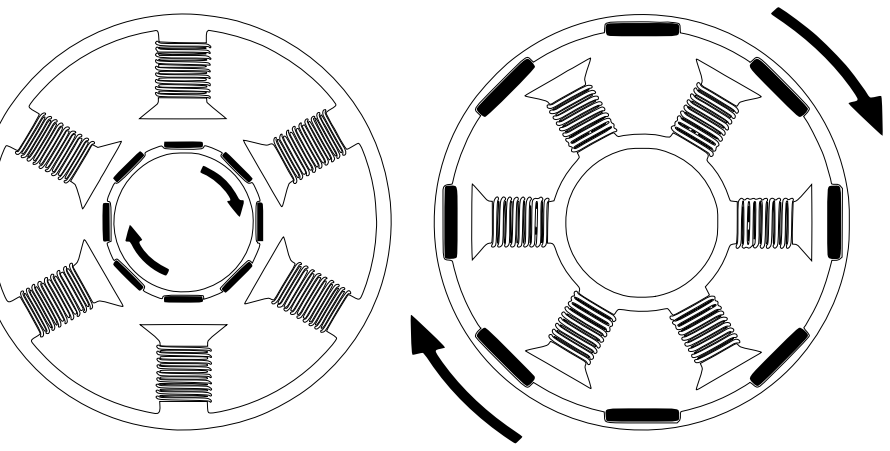
[picture p7: figure]

Abbildung 4.1: Schematische Gegenüberstellung von BLDC-Motoren als Innenläufer (links) bzw. Außenläufer (rechts) ausgeführt [12].

Radius des Angrispunktes der magnetischen Kopplung kann im Falle der Außenläufer bei gleicher Baugröße und gleichem Phasenstrom allerdings ein höheres Drehmoment erzeugt werden. Sind größere Drehzahlen gefordert, so ist die Bauweise des Innenläufers durch den reduzierten Durchmesser des Rotors vorteilhaft. Da hohe Drehzahlen gegenüber einem zu erzeugenden Drehmoment für das zu konstruierende Antriebssystem von untergeordneter Priorität sind und sich oberhalb eines Schwellwertes sogar kontraproduktiv auswirken können, fällt hier die Wahl auf das Außenläuferprinzip.

Auch während Lenkmanövern muss eine Übertragung des Drehmomentes auf die Rollen der Trucks sichergestellt sein. Praktikabel und mit einfachen Mitteln denkbar sind hier eine koaxiale Positionierung des Motors zur angetriebenen Rolle. Der Motor kann hier gegenüber der Rolle weiter im Zentrum des Hangers platziert werden, setzt jedoch eine Hohlwelle mit ausreichend Raum für den Hanger bzw. die Hangerachse zwingend voraus.
Eine weitere Option bildet die Positionierung des Motors in der Rolle selbst. Beschichtet mit einem geeigneten Material kann der Rotor so unmittelbar den Kontakt zum Boden herstellen. Vorteile dieser Variante sind sowohl eine gute Marktverfügbarkeit, als auch eine deutliche Reduktion mechanischer Komplexität des Antriebssystems. Nachteilig sind hier im Vergleich deutlich höhere Preise, weniger Auswahl und schlechte bis unmögliche Wartungsmöglichkeiten.
Letztlich kann die Motorachse parallel zur Rollenachse positioniert werden. So ist zwar die Kraftübertragung von Welle zu Rolle aufwändiger herzustellen, es werden aber die geringsten Anforderungen an die Motoren bezüglich ihrer Bauform gestellt, wodurch sie besonders günstig und in großer Vielfalt am Markt verfügbar sind. Im Sinne der Wartbarkeit und des Potenzials der Kostenezienz wird sich auf diese Variante festgelegt.

Um Zuverlässigkeit des Systems auch an warmen Sommertagen sicherzustellen, ist es notwendig, thermisches Versagen der Motoren aufgrund von resistiven Verlusten innerhalb der Motorwicklungen und physikalischer Nähe zum erhitzten Asphalt in Betracht zu ziehen. Mit Blick auf vergleichsweise marginale Kostensteigerungen von Motoren größerer Bauform wird von einer aktiven Motorkühlung und ihrer einhergehenden Erhöhung der Komplexität des Gesamtsystems abgesehen. Als praktikabel hat sich der Motor mit Handelsnamen TorqueBoards und der Typenbezeichnung 6355 190KV gezeigt. Elektrische Parameter sind in Tabelle 4.1 gelistet. Die äußeren Dimensionen können Abb. 4.2 entnommen werden¹⁰

Tabelle 4.1: Motorspezifikationen TorqueBoards 6355 190KV.

Charakteristik | Spezikationen
Maximale Leistung | 2500 kW
Maximaler Phasenstrom | 80 A
Maximale Spannung | 43,2 V
KV | 190 min−1 V−1

Wenn sie auf der Kurvenaußenseite liegt, kann es zu Traktionsverlust der antreibenden Rolle während eines Lenkmanövers kommen. Dem zu entgegnen wird der Antrieb beider Rollen eines Hangers vorgesehen. Dies hat den zusätzlichen Vorteil, dass die mechanische Last auf zwei Getriebesysteme und die elektrische Last auf zwei Motoren verteilt wird.

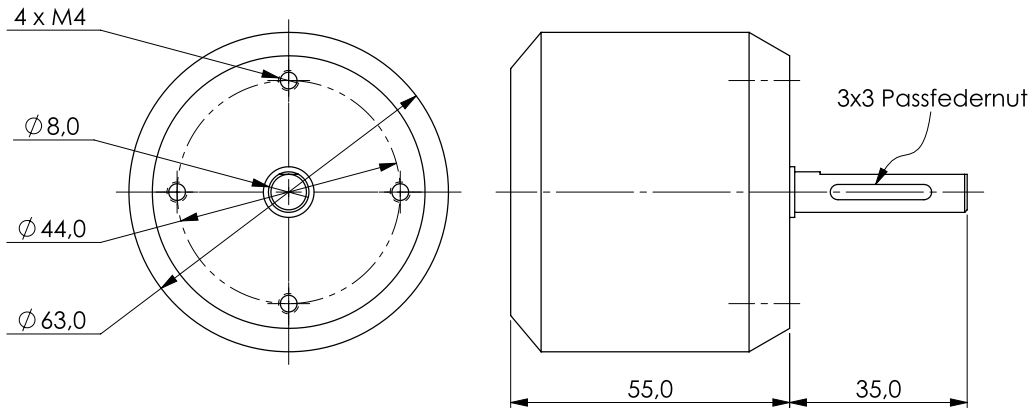
[picture p8: figure]

Abbildung 4.2: Relevante Dimensionen des Motors TorqueBoards 6355 190KV.

### 4.1 Transmission

Im Kontext dieser Arbeit sind zwei Situationen von Interesse: Fahrt auf acher Strecke mit geringer Anforderung an Drehmoment, jedoch erhöhtem Interesse an der Maximalgeschwindigkeit und Fahrt hangaufwärts mit reduzierter Geschwindigkeit und entsprechend höheren Anforderungen an das abrufbare Drehmoment. Aufgrund des quadratischen Zusammenhangs des Strömungswiderstands mit der Geschwindigkeit nach Gl. 3.4 ist der FStröm zuzuordnende Anteil im zweiten Fall zu vernachlässigen. Um abzuschätzen, bei welcher Geschwindigkeit der Strömungswiderstand gegenüber dem Rollwiderstand an Relevanz gewinnt, ist in Abb. 4.3 das Verhältnis beider Kräfte über der Geschwindigkeit in km h−1
aufgetragen. Der Kurvenverlauf folgt der Gleichung

FStröm

FRoll

=

cStröm ρ A

2m g cRoll

v

2
(4.1)

mit verwendeten Werten wie aus Tabelle 4.2 zu entnehmen [13, 14, 15].

10 Eigene Zeichnung mangels technischer Zeichnungen seitens des Herstellers. Alle Dimensionen wurden der Produktbeschreibung entnommen oder, wo fehlend, messtechnisch ergänzt.

Studienbereich Angewandte Physik & Medizintechnik | 11 von 29

Ab einer Geschwindigkeit von etwa 42 km h−1 beginnt der Strömungswiderstand zu dominieren und es wird die Annahme getroen, dass bei 10 km h−1

, was etwa doppelter Schrittgeschwindigkeit¹¹ entspricht, der Beitrag des Strömungswiderstandes nahezu verschwindet.

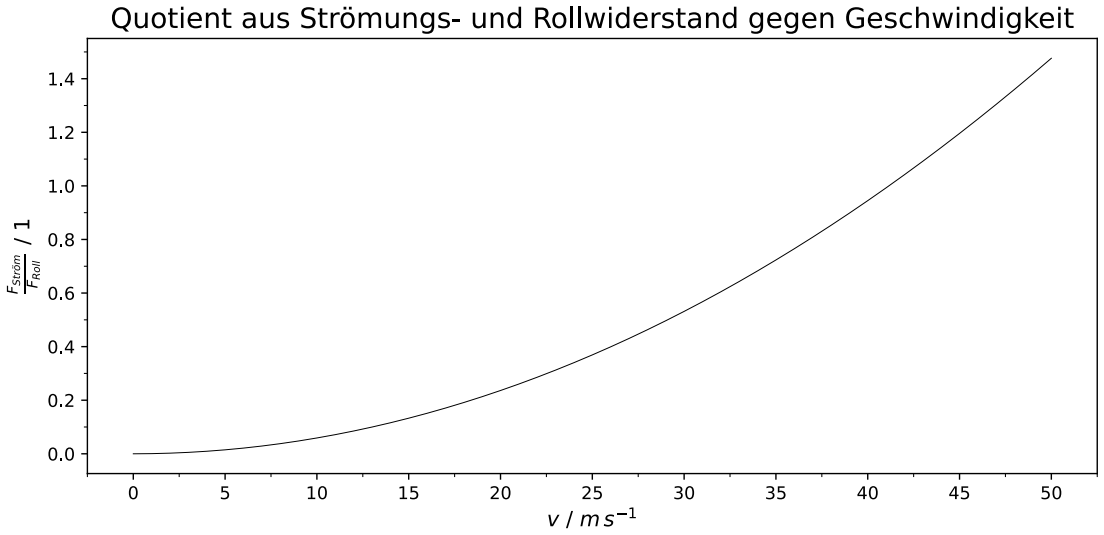
[picture p9: figure]

Abbildung 4.3: otient aus Strömungs- und Rollwiderstand als Funktion der Geschwindigkeit. Ab einer Geschwindigkeit von etwa 42 km h⁻¹
dominiert der Strömungswiderstand. Bei niedrigen Geschwindigkeiten ist er gegenüber dem Rollwiderstand zu vernachlässigen.

Der Grad einer gegebenenfalls notwendigen Untersetzung wird durch Bilden des Quotienten aus Gl. 3.10 und Gl. 3.5 und anschließendem Auftragen als Funktion von ζ gefunden – erwünscht ist hier ein Wert ≫ 1, mindestens aber = 1.

M

MHang

=

8,27 · IMotor ζ

KV

h

m g

sin

arctan
G

100 + cRoll
+

1/2 cStröm ρ A v²

i
r

(4.2)

Daneben soll auch die erwartete Maximalgeschwindigkeit nach Gl. 3.8 abgeschätzt werden. Einsetzen der bekannten Parameter und Randbedingungen aus Abschnitt 2.2 in Gl. 3.8 und Gl. 4.2 im Intervall 1 ≤ ζ ≤ 3 ist in Abb. 4.4 dargestellt. Zu sehen ist, dass mindestens ζ ≈ 2,2 erreicht werden muss um die Vorgaben erfüllen zu können. Im Sinne einer Reserve wird arbiträr ζ = 2,4 gewählt.

Tabelle 4.2: Tabelle der verwendeten Werte zur Abschätzung des Strömungs- und Rollwiderstandes [13, 15, 14].

Größe | Wert
Aa | 0,293 m²
g | 9,81 m s−2
cRoll | 0,022
cStröm
a | 0,872
m | 100 kg
ρ
b | 1,293 kg m−3

a Arithmetisches Mittel aus Tabelle 1 in [14]. b Unter Normalbedingungen [13].

Um das Drehmoment von der Motorwelle auf die Rolle zu übertragen, wird ein Riemensystem mit High Torque Drive-Prol (HTD) in Zahnteilung 5M (5 mm Abstand zwischen zwei Zähnen entlang der

11 “Schrittgeschwindigkeit” ist kein wohl denierter Begri. Onlinerecherchen lieferten Werte im Bereich 5 km h⁻¹ bis

### 7 km h⁻¹

12 von 29 | Studienbereich Angewandte Physik & Medizintechnik

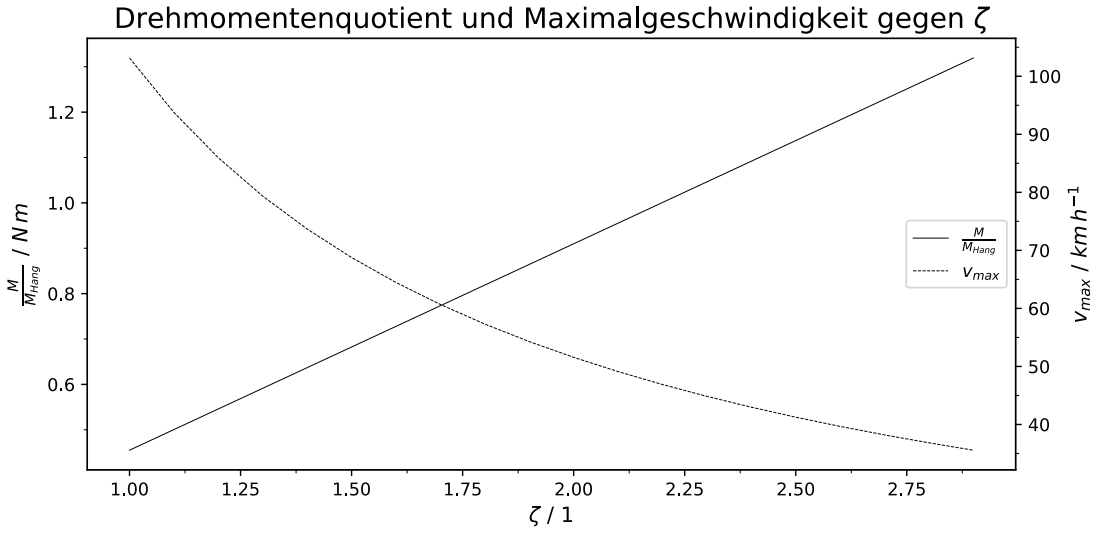
[picture p10: figure]

Abbildung 4.4: Am Hang wirkende Momente und Maximalgeschwindigkeit als Funktion von ζ.

neutralen Faser) gewählt. Sein vergleichsweise breites Zahnungsprol bietet einen guten Kompromiss aus Flexibilität, Kraftübertrag und Ezienz [16]. Darüber hinaus sind entsprechende Riemen und Zahnriemenscheiben günstig und gut erhältlich.
Da im Falle des HTD 5M Zahnungsprols gilt, dass zu jedem Zeitpunkt zumindest sechs Zähne greifen müssen [17] und mit obigen Überlegungen die antriebsseitige Zahnriemenscheibe kleiner gegenüber der getriebeseitigen sein muss, ergibt sich eine antriebsseitige Mindestzahnung, die wiederum Einuss auf den Außendurchmesser des getriebeseitigen Zahnrades hat. Dieser darf den Durchmesser der Rolle abzüglich des zusätzlichen Auftrags des Riemens von 1,7 mm [16] nicht übersteigen, um im Betrieb Bodenkontakt des Riemens zu vermeiden. Während käuich Zahnungen von 12T – im Folgenden verwendete Notation “numerische Anzahl der Zähne” gefolgt von großem T verwendet – an aufwärts gelistet sind, bot sich aus Kostengründen und Sicherstellen der wie oben beschrieben Mindestanzahl zu jeder Zeit greifender Zähne die 15T-Variante an. Mit ζ = 2,4 ergibt sich so eine Zahnung von 36T für die Getriebeseite mit einem theoretischen Maximaldrehmoment an den Rollen von 3,13 Nm.

Position der Zahnscheibe

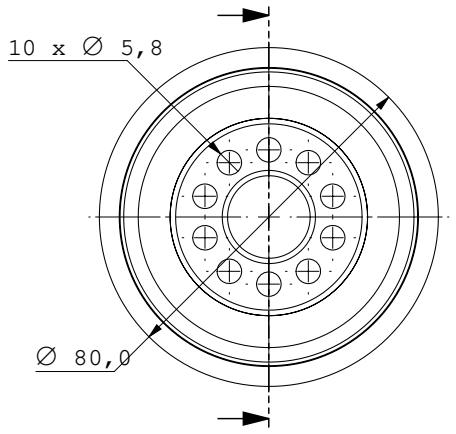
[picture p11: figure]

Abbildung 4.5: Rück- und Schniansicht der Kegel des Herstellers Orangatang. Die Zahnriemenscheibe wird rückseitig auf der Rolle montiert.

Auf der getriebenen Seite muss die Zahnriemenscheibe kraftschlüssig mit der Rolle verbunden werden. So ist es wünschenswert, dass sich bereits durch die Bauart der Rollen eine einfache Installation

Studienbereich Angewandte Physik & Medizintechnik | 13 von 29

anbietet. Verwendet werden hier 80 mm Kegel des Herstellers Orangatang. Sie besitzen einen Kern aus hartem Kunststo mit 10 radial um ihre Hauptachse angeordneten Bohrungen von 5,8 mm Durchmesser (vgl. Abb. 4.5).
Unter Zuhilfenahme einer Fühlerlehre, ermitteln der Maße und mehreren Iterationen im FDM-Verfahren 3D-gedruckter Modelle konnten die inneren Prole der Rollen in ausreichender Genauigkeit so in ein CAD-Modell übertragen werden, dass daraus eine Passung für die getriebeseitige Zahnriemen-

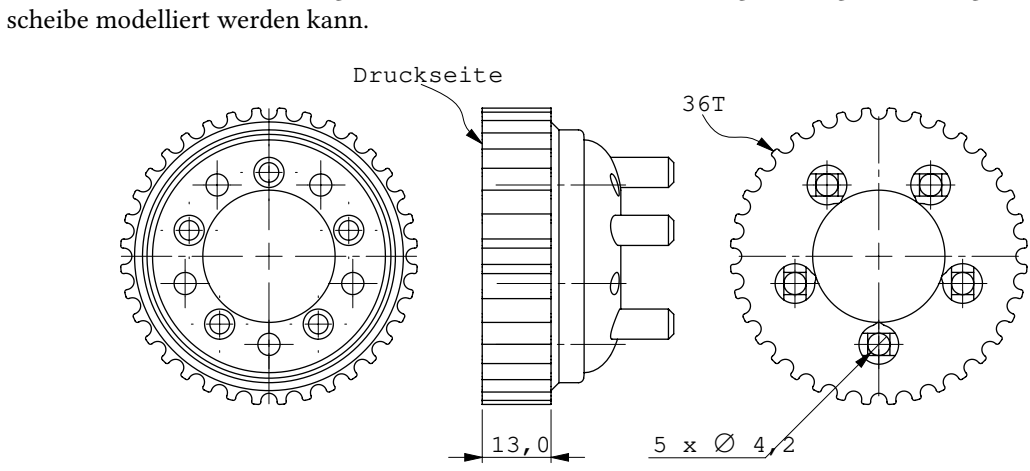
[picture p12: figure]
scheibe modelliert werden kann.; Druckseite

Abbildung 4.6: Zeichnung der modellierten Zahnriemenscheibe. Zu erkennen sind alternierend fünf Bohrungen um jeweils M4 Schrauben aufnehmen zu können und fünf Führungsstie für eine vereinfachte Montage.

Das HTD 5M Zahnungsprol wurde aus einem OpenSCAD-Script [18] entnommen, um es unter Abgleich von Herstellerangaben [16, 19] im verwendeten CAD-Programm¹² nachzubilden. Das Produkt ist die in Abb. 4.6 gezeigte 36T Zahnriemenscheibe zum Einsatz in der dem Hanger zugewandten Flanke der Rollen. Korrespondierend mit den vorhandenen Bohrungen der Rollen umgibt das zentrale Loch fünf Bohrungen mit Senkung um DIN 912 M4 Schrauben aufnehmen zu können. Die in den Zwischenräumen angeordneten Stifte dienen nicht der Kraftübertragung, sondern lediglich einer geführten Montage. Wie in Abb. 4.7 zu sehen, ist die Passform des Zahnungsprols im direkten Vergleich zu einem Kaufteil (hier in 44T) hinreichend genau. Das Herstellungsverfahren lässt zwar eine noch etwas höhere Präzision zu, da aber im Betrieb ohnehin von abrasiven Eekten entlang der Zahnung ausgegangen werden kann, wurde im Sinne einer zügigeren Fertigung darauf verzichtet.

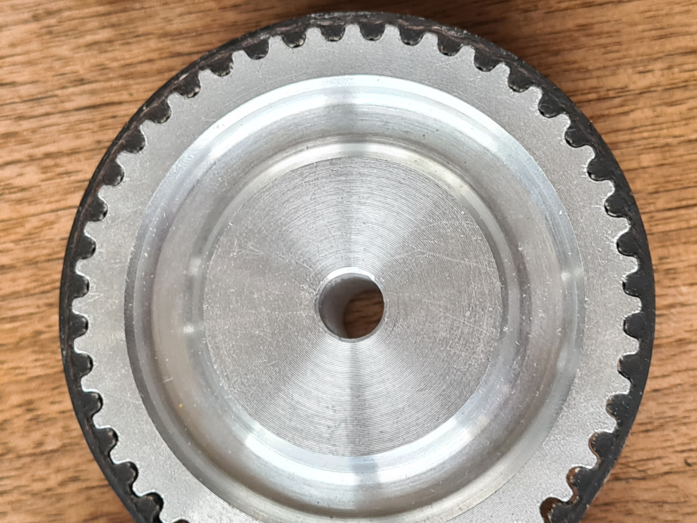
[picture p13: figure]
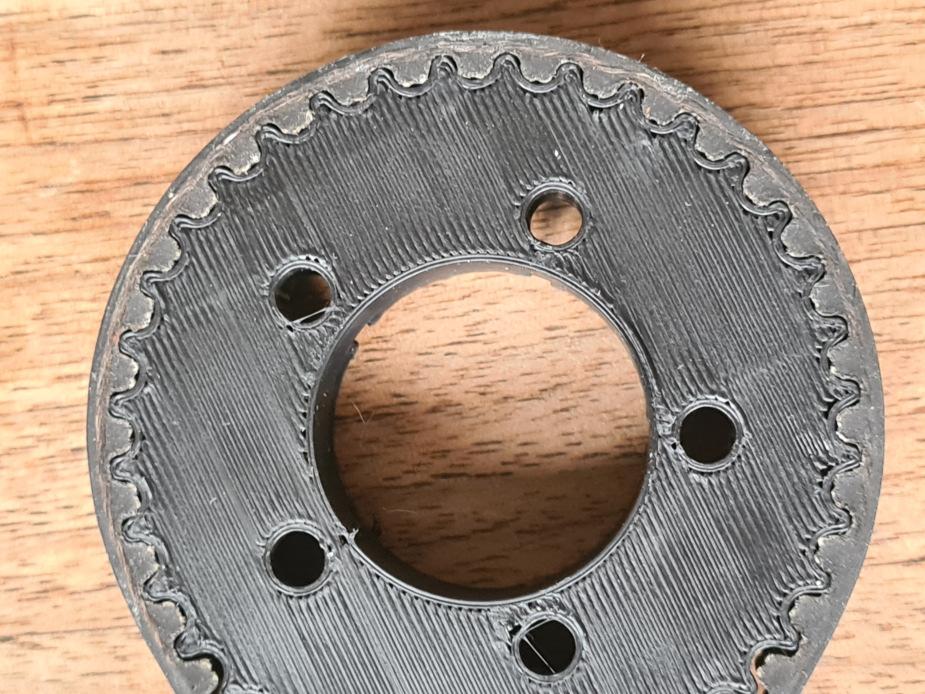
[picture p14: figure]

(a) CNC-gefrästes HTD-5M-Profil auf Riemen. | (b) 3D-gedrucktes HTD-5M-Profil auf Riemen.

Abbildung 4.7: Vergleich der Passform einer gekauen Zahnriemenscheibe in (44T) aus Aluminium und des 3D-gedruckten Modells (36T) mit einem Riemen.

12 Hier SolidWorks.

14 von 29 | Studienbereich Angewandte Physik & Medizintechnik

Da die Schrauben mit Muttern gekontert werden sollen und die der Zahnriemenscheibe gegenüberliegende Flanke der Rollen ebenfalls ein konkaves Prol aufweist, wurde ein komplementäres Gegenstück – zu sehen in Abb. 4.8 – im oben beschriebenen Prozess modelliert. Wie auch die Zahnriemenscheibe

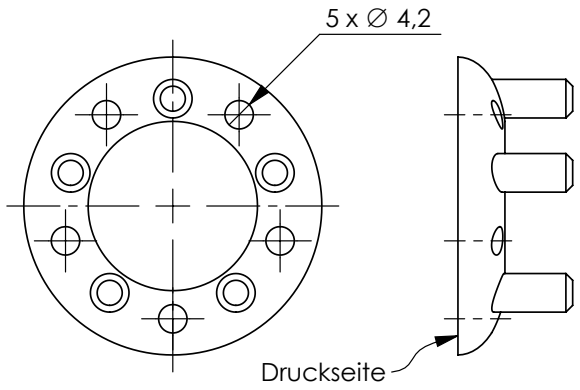
[picture p15: figure]
Druckseite

Abbildung 4.8: Zeichnung des Gegenstücks der Zahnriemenscheibe um eine ebene Fläche für die Muern zur Verfügung zu stellen.

enthält die Konterscheibe fünf Bohrungen und fünf Führungsstifte und soll ebenfalls möglichst exakt dem inneren Prol der Rollen anliegen.
Aus Kostengründen und einfachem Zugang zu den Betriebsmitteln wurde entschieden, die funktionalen Versionen der getriebeseitigen Zahn- und Konterscheibe ebenfalls im 3D-Druck-Verfahren aus ABS selbst herzustellen. Es ist zwar zu erwarten, dass die Zahnriemenscheiben gegenüber aus Aluminium gefrästen Komponenten bezüglich Verschleiß und Festigkeit deutlich unterliegen, durch das gewählte Fertigungsverfahren lassen sich allerdings schnell, unkompliziert und günstig Ersatzteile herstellen. Darüber hinaus ist an dieser Stelle nicht mit einem plötzlichen Totalversagen der Materialintegrität und in Folge potenziell fataler Konsequenz zu rechnen.

Zur Auswahl des Riemens ist schließlich neben der Breite die Länge und damit die Anzahl der Zähne zu beachten. Ein vergrößerter Mittelpunktabstand beider Zahnriemenscheiben erhöht grundsätzlich die Anzahl greifender Zähne, allerdings fällt dieser Eekt mit zunehmendem Abstand schnell ab. Es wurde ein Abstand so gewählt, dass zu jeder Zeit ein Zahn mehr als gefordert greift. Mit Zahnungen von 36T für die Antriebsseite, 15T getriebeseitig und dieser Vorgabe wurde eine Riemenzahnung von 55T gewählt. Die Riemenbreite wurde mit 12 mm arbiträr auf das breiteste käuich erhältliche Maß festgelegt, dass noch konstruktiv umsetzbar ist. Abbildung 4.9 zeigt schematisch das System beider Zahnriemenscheiben und Riemen.

Studienbereich Angewandte Physik & Medizintechnik | 15 von 29

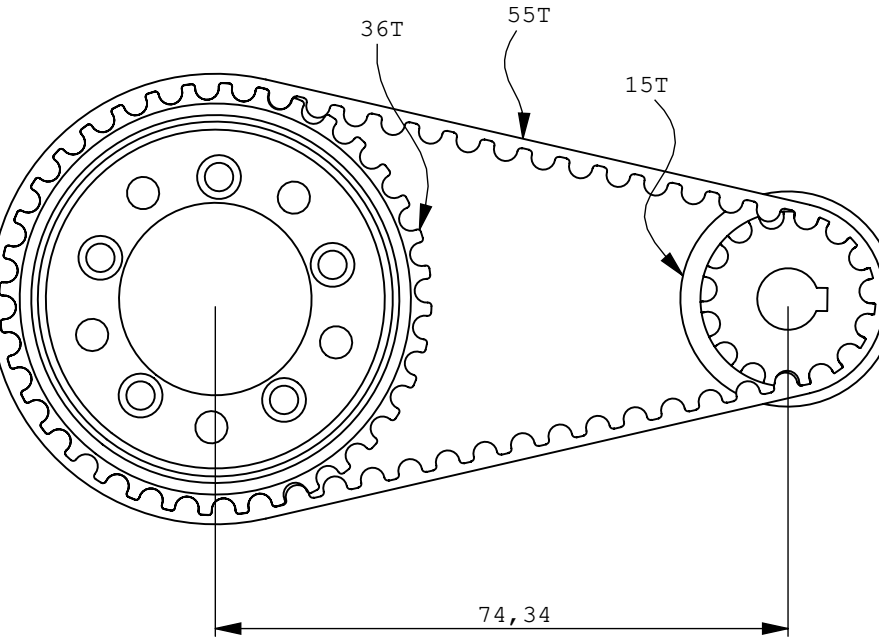
[picture p16: figure]

Abbildung 4.9: Mielpunktabstand zwischen antriebs- und getriebeseitigen Zahnriemenscheiben bei einem Zahnriemen mit 55 Zähnen.

### 4.2 Motorbefestigung

Die Verbindung zwischen Motor und Hanger wird in zwei Teilen hergestellt: eine Zange, die formschlüssig Verdrehen um die Hangerachse und durch Verspannen reibschlüssig Verschieben entlang der Hangerachse verhindert und ein Arm, der die Verbindung zwischen Zange und Motor herstellt. Kostenfreie Verfügbarkeit des Materials lässt die Werkstoauswahl beider Komponenten auf Walzbleche der Aluminiumlegierung AlMgSi0,5 (EN AW 6060) fallen. Die Fertigung ndet im CNC-Fräsverfahren mit einem Werkzeugdurchmesser von 3 mm statt.

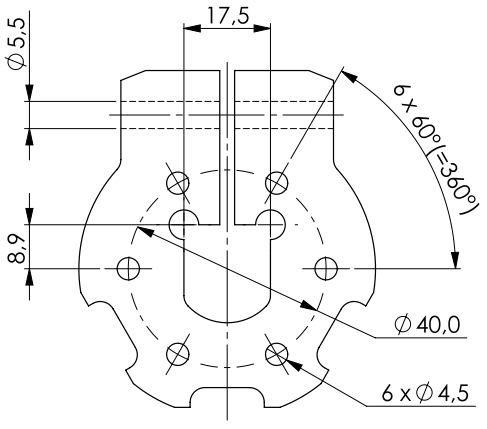
[picture p17: figure]

Abbildung 4.10: Zange zur Montage der Motorhalterung am Hanger.

Abbildung 4.10 zeigt eine Zeichnung der Zange mit allen relevanten Dimensionen. Erkennbar ist mittig eine Aussparung in Form des Prols des Caliber II Hangers mit Nut, um durch eine M5 Schraube an den beiden achen Flanken des Hanger angespannt werden zu können. Um hier die Kontaktäche zu maximieren wurde als Halbzeug ein Blech größtmöglich zur Verfügung stehender Materialstärke gewählt. Kreisförmig um die Rollachse des Hangers benden sich sechs M4-Durchgangsbohrungen, um ach anliegend den Motorarm anbringen zu können. Sollte die Einspannung des Hangers in der Zange

16 von 29 | Studienbereich Angewandte Physik & Medizintechnik

ein Driften entlang der bzw. Kippen gegen die Hangerachse nicht zuverlässig verhindern können, so sollen später an den drei Aussparungen entlang des äußeren Bogens Querverbindungen zwischen zwei

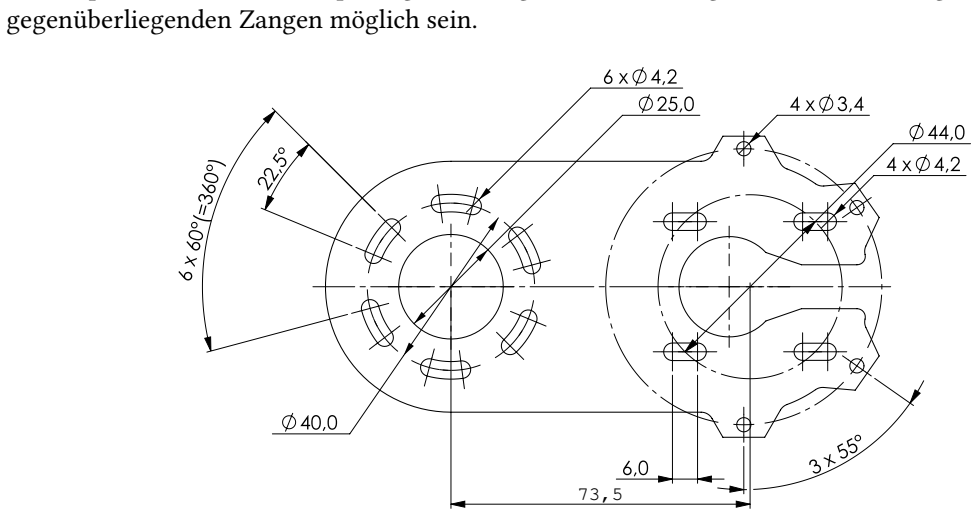
[picture p18: figure]
gegenüberliegenden Zangen möglich sein.

Abbildung 4.11: Verbindungsarm zwischen Motor und Hangerzange. Wichtigste Merkmale: links radial um die Rollachse angeordnete Langlöcher zur Feinjustage des Montagewinkels. Rechts entlang der Längsachse des Armes ausgerichtete Langlöcher zur Justage der Riemenspannung.

Ebenfalls aus AlMgSi0,5 und mit einer Materialstärke von 4 mm stellt der Arm als komplementäre Komponente, ach an die Zange angeschraubt, eine steife Verbindung zwischen Hanger und Motor her. In Abb. 4.11 links benden sich radial um die Rollachse angeordnet sechs Langlöcher zur Montage an der Zange. Da der gesamte Aufbau sich unterhalb des Decks benden wird, ist es wichtig bezüglich der Motoren ein Optimum zwischen Bodenabstand und Distanz zum Deck zu nden. Um auch nach Zusammenbau die Abstände nachjustieren zu können, kann der Anstellwinkel des Armes innerhalb

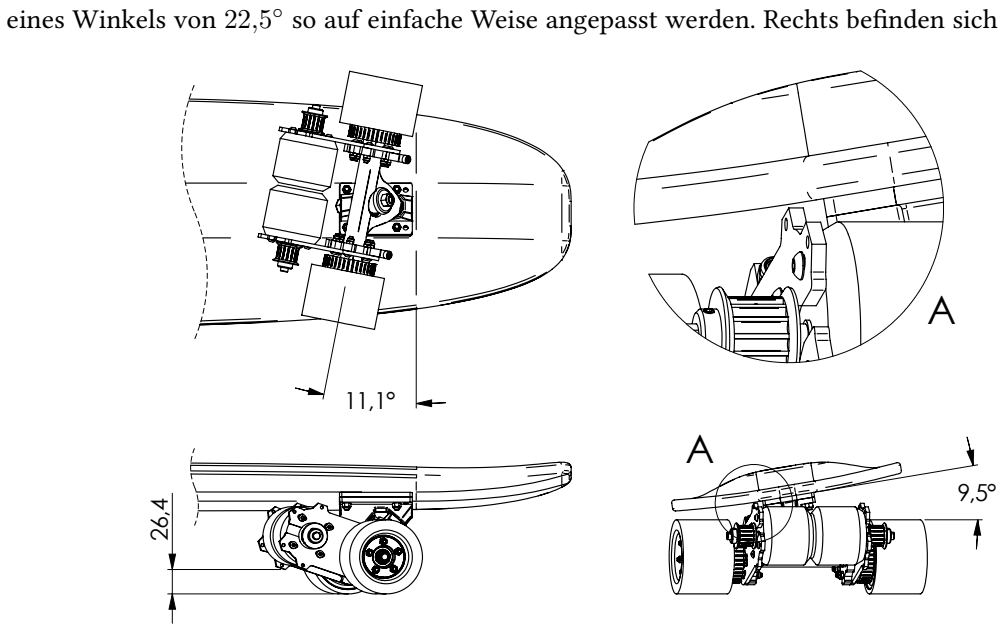
[picture p19: figure]
eines Winkels von 22,5 ◦

so auf einfache Weise angepasst werden. Rechts benden sich vier weitere

Abbildung 4.12: Zeichnung des Gesamtaufbaus montiert als Hinterachse.

Langlöcher von 6 mm Länge zur Befestigung des Motors. Hier dienen die Langlöcher der Möglichkeit nach Zusammenbau durch Variation des Abstandes von Roll- zu Motorachse die Riemenspannung nachjustieren zu können. Nach Abb. 4.9 ist mit der in Abschnitt 4.1 beschriebenen Konguration ein theoretischer Mittelpunktabstand von ≈ 74,34 mm zu erwarten. Der Mittelpunktabstand der Hanger-

Studienbereich Angewandte Physik & Medizintechnik | 17 von 29

achse und des Kreismittelpunktes der Langlöcher zur Motorbefestigung wurde mit 73,5 mm so gewählt, dass bei einer Länge der Langlöcher von 6 mm sowohl Ein- und Ausbau des Riemens, als auch adäquate Riemenspannung sichergestellt ist.
Vier Bohrungen durch die äußeren Erhebungen um die Motorachse herum sollen es später ermöglichen bei Bedarf einen Riemenschutz anbringen zu können. Die Erhebungen selbst sollen den Zweck eines Puermaterial im Falle eines Bodenkontaktes erfüllen.

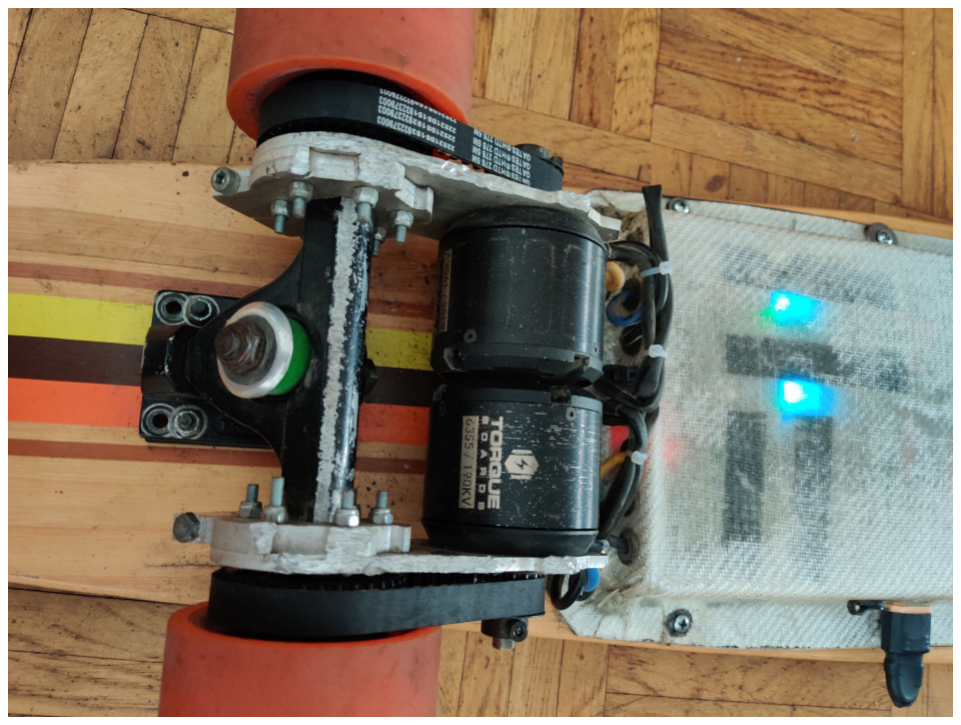
[picture p20: figure]

Abbildung 4.13: Fertiger Aufbau des Antriebssystems nach etwa 100 km Testfahrt durch urbanes Terrain.

Abbildung 4.12 zeigt eine Zeichnung des Gesamtaufbaus des Systems mit zwei Motoren, den Unterbaugruppen der Motorhalterungen, den Rollen und den Truck montiert an der Heckseite des Decks in eingelenkter Position. Zum Vergleich in Abb. 4.13 der reale Aufbau.

18 von 29 | Studienbereich Angewandte Physik & Medizintechnik

## 5 Elektronik

Die verwendeten ESC sind in der Lage, die gegenwirkende elektromotorische Kraft (Gegen-EMK) – eine während des Betriebes in den Wicklungen des Motors induzierte und seiner Drehrichtung entgegenwirkenden Spannung – zu Messen und zur Positionsbestimmung des Rotors zu nutzen. Gegenüber eines trapezoidalen Phasenstromes können die Motorwicklungen so sinusoidal bestromt werden, was wiederum geringere elektrische Verluste und ein gleichmäßigeres Drehmomentprol während eines Umlaufes und damit einen sanfteren und geräuschärmeren Motorlauf verspricht. Prinzipbedingt steigt die Amplitude der rEMK mit der Drehzahl des Motors. Konsequenterweise wird so die Messung und damit die Positionsbestimmung im niedrigen Drehzahlbereich erschwert während sie im Stillstand unmöglich wird. Um ein exaktes Feedback der Rotorposition an die Steuerelektronik unabhängig der rEMK zu ermöglichen, verfügen die ausgewählten Motoren über integrierte Hall-Eekt-Sensoren. Im höheren Drehzahlbereich verschwinden ihre Vorteile zwar zunehmend, liefern jedoch die Möglichkeit eines äußerst sanften Anlaufes aus dem Stillstand heraus.

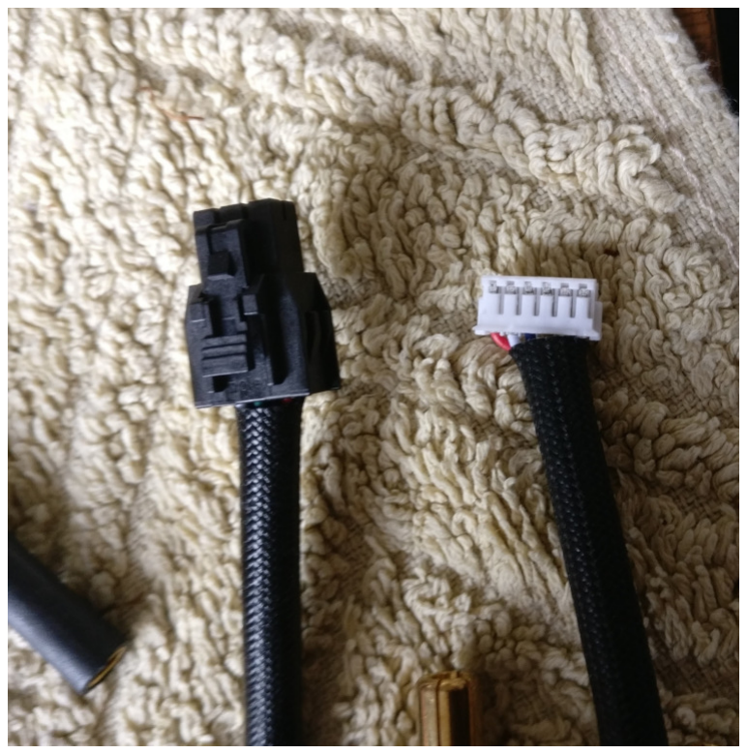
[picture p21: figure]

Abbildung 5.1: Links ein 3x2-Pin Molex Micro-Fit 3.0 Steckverbinder, rechts ein 6-Pin JST-PH 2 mm zur Verbindung mit dem ESC.

Die ab Werk mit JST-PH 2 mm Steckverbindern ausgestatteten Sensorenleitungen wurden im Sinne einer Staub- und Spritzwassergeschützen Durchführung in das GFK-Gehäuse über eine Kabelbrücke mit den ESC verbunden. Die Kabelbrücke wurde aus 30AWG¹³ exibler Silikonleitung mit einem 6-Pin JST-PH Steckverbinder ESCseitig und einem 3x2 Molex Micro-Fit 3.0 Steckverbinder motorseitig gefertigt (vgl. Abb. 5.1). Für den motorseitigen Anschluss wurde eine entsprechende Önung in das Gehäuse geschnitten und der Steckverbinder mit Epoxidharz dauerhaft und dicht verbunden. Die Anordnung der Sensoren spielt an dieser Stelle eine untergeordnete Rolle, da sie vor Inbetriebnahme softwareseitig konguriert werden können. Es wird lediglich darauf geachtet, dass die Anordnung beider Motoren identisch bleibt. Zur Durchführung der Phasenleitungen werden je Motor drei Löcher in das Gehäuse
gebohrt und mit Gummi-Durchführungen versehen.

Die Leistungsendstufe ist als Doppel-H-Brücke implementiert und in Abb. A.1 gezeigt¹⁴. Um den Rotor um 360◦ dividiert durch die Anzahl der magnetischen Pole des Rotors np zu drehen, muss ein voller Kommutationszyklus durchgeführt werden, was im Folgenden einer elektrischen Umdrehung entsprechen soll. Die Anzahl elektrischer Umdrehungen je Minute bei gegebener mechanischer Drehzahl des Rotors sei gegeben durch:

ωe = ω np | (5.1)

### 13 Entspricht etwa 0,25 mm²

14 Als Gate-Treiber ist ein DRV8302 von Texas Instruments verbaut. Im Datenblatt unter “STARTUP AND SHUTDOWN SEQUENCE CONTROL” ist zu lesen, dass alle Gate-Verbindungen Low gehalten werden bis EN_GATE High ist und ≥ 10 ms vergangen sind [20]. Die Low-seitigen Pull-Down Widerstände R30,36,46 dienen vermutlich einem sichergestellt hochohmigen Zustand der Low-Side-FETs im Einschaltmoment als zusätzliche Sicherheitsschicht um Kurzschluss von V_SUPPLY gegen Ground zu verhindern

Die Maximalgeschwindigkeit skaliert somit direkt proportional mit ωe und kann in km h−1 geschrieben werden als

vmax = ωe

2π r
np ζ
- 0, 06 | (5.2)

Mit Unterstützung der Kongurationssoftware der ESC obere Grenzwerte für ωe zu hinterlegen ist es möglich unmittelbar Werte für die Maximalgeschwindigkeit zu denieren (vgl. Abb. A.3).

20 von 29 | Studienbereich Angewandte Physik & Medizintechnik

## 6 Evaluation

Im Folgenden sollen die mechanische Integrität und Performanz des Systems in Hinblick auf die in Abschnitt 2.2 formulierten Rahmenbedingungen diskutiert werden. Im Vorfeld wurden mehrere Testfahrten auf urbanem Untergrund und entlang verschiedener Steigungen durchgeführt. Insgesamt wurde die verbaute Batterie hierbei dreimal von 42 V (voll geladen) herunter auf 31 V entladen. Zurückgelegte Distanz und mittlere, sowie maximale Geschwindigkeit wurden mittels Navigationssoftware und GPS gemessen. Zusätzlich wurden Logginginformationen der ESC selbst zur Evaluation herangezogen. Die verwendeten Parameter für Tests auf der Werkbank und im Feld können Abb. A.2 und Abb. A.3 entnommen werden.

### 6.1 Performanz

Während mehrerer Testfahrten wurde das Drehmoment auf einer Strecke von etwa 250 m entlang eines Hanges mit einer maximalen Steigung von 7,5 % auf gepastertem Untergrund getestet. Während das System am Hang und aus dem Stand heraus nur schwer in der Lage ist zu beschleunigen, ist es ohne weiteres möglich, mit bereits moderater Anfangsgeschwindigkeit die Steigung zu überwinden. Die Geschwindigkeitstests wurden entlang einer frisch asphaltierten, ebenen Strecke durchgeführt. Ab

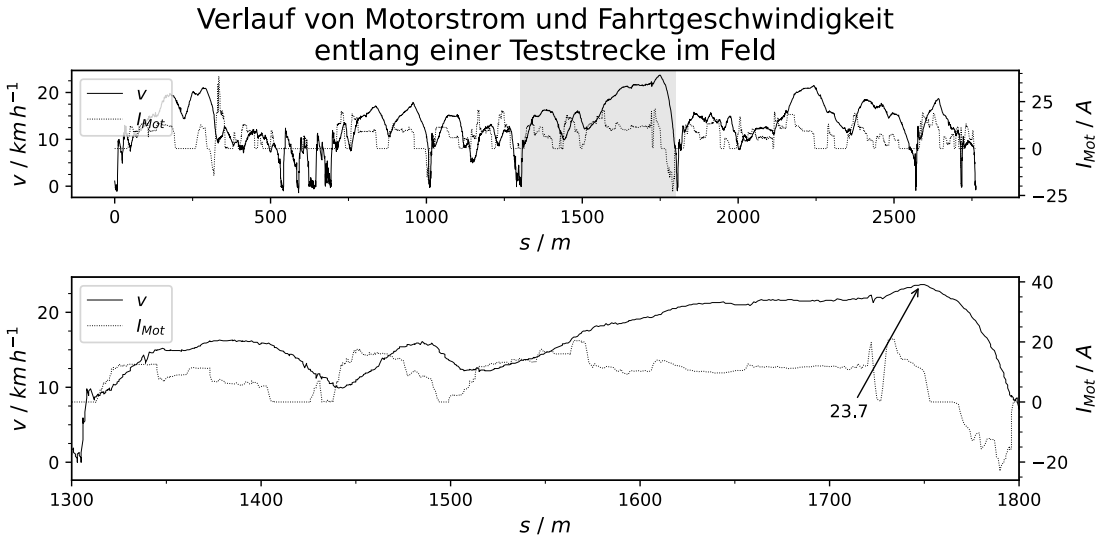
[picture p22: figure]

Abbildung 6.1: Aufgetragene Logging-Informationen einer Testfahrt von etwa 2,8 km. Oben: die gesamte Fahrt. Bei ≈ 350 m ist eine kurzzeitige Spitze des Motorstromes bedingt durch eine vergleichsweise steile Steigung über wenige Meter. Unten: Zoom auf den Bereich zwischen 1300 m bis 1800 m. Hier wurde auf gerader Strecke auf Maximalgeschwindigkeit beschleunigt mit einem Spitzenwert von 23,7 km h⁻¹

etwa 20 km h−1 wird das System zunehmend instabil und beginnt zu oszillieren – ein Eekt bekannt unter dem Begri der Speed Wobbles – was Tests bei höheren Geschwindigkeiten zunehmend gefährlich macht. Dem lässt sich zwar mit festerer Einspannung der Bushings begegnen, das würde allerdings zu einem vergrößerten Kurvenradius führen. Von Feldtests bei Geschwindigkeiten höher als 25 km h−1 ohne erweiterte Sicherheitsausrüstung wurde aus oben genannten Gründen abgesehen. Via Software wurde nach Gl. 5.2 die maximale Geschwindigkeit auf 25 km h−1 begrenzt (vgl. Abb. A.3).

### 6.2 Werkstoe

Die Montage der Zangen am Hanger bedarf ein hohes Maß an Geschicklichkeit, um die Flanken der Zangen möglichst koplanar an den Flanken der Rollen auszurichten und zeitgleich ein Anzugsmoment anzuwenden, dass ein Verkippen oder Verschieben der Zangen im Betrieb sicher verhindert. Nicht koplanar ausgerichtete Flanken würden zu einem seitlichen Drift der Riemen auf den Zahnriemenscheiben führen. Einmal montiert hielten die Motorhalterungen sämtlichen Belastungen des Normalbetriebes und nicht-intendierte Spitzenbelastungen bei Kollisionen mit gehobener Geschwindigkeit (vgl. Abb. 4.13) stand¹⁵

Die Zahnriemenscheiben zeigen, zu sehen in Abb. 6.2b, gut sichtbaren Abrieb entlang der Zahnung und es brachen sämtliche Führungsstifte was darauf hindeutet, dass auf sie unbeabsichtigt Moment übertragen wurde. Während es hierzu im Rahmen der Testfahrten keine weiteren Auälligkeiten bezüglich eines negativen Einusses auf die Funktionalität des Systems gab, bietet sich hier für zukünftige Revisionen Nachbesserungspotential. Die sonstige Integrität der Bauteile blieb vollständig erhalten, da weder das Prol selbst, noch die Bauteile als ganze Spuren von Materialermüdung wie Rissbildung oder gar Brüche zeigen.

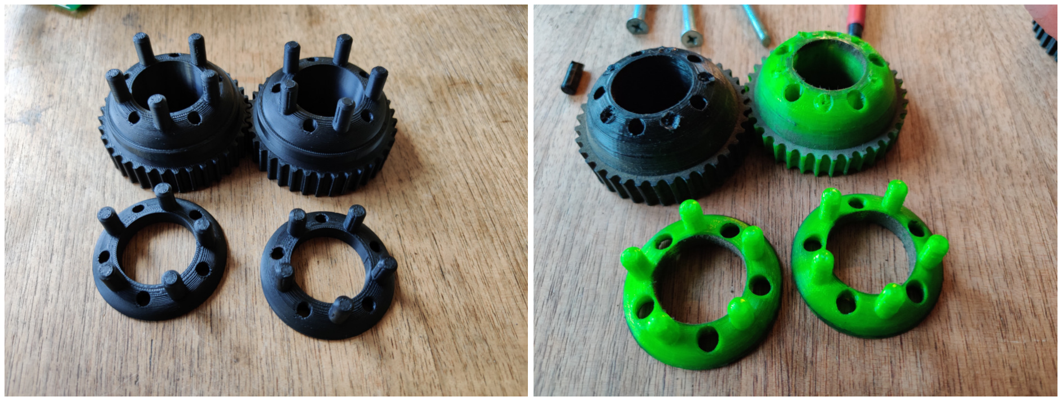
[picture p23: figure]

(a) Ungenutzte Druckteile. | (b) Zustand der Druckteile nach einigen Testfahrten.

Abbildung 6.2: (a) Die finale und zum Zeitpunkt des Verfassens dieses Dokumentes noch verbaute Version. (b) Der Zustand des ersten funktionalen Prototypes nach etwa 100 km Testfahrt. Neben zu erwartender Verschmutzung sei insbesondere auf das Fehlen der Führungsstie zu achten. Das Zahnprofil und die Komponenten als ganze weisen darüber hinaus jedoch keinerlei Anzeichen von Materialversagen auf.

### 6.3 Kosten

Eine Aufstellung der Einzelkosten ndet sich in Tabelle 6.1. Die mit “*” gekennzeichneten Posten konnten im Rahmen des Projektes eingespart werden und sind mit Schätzwerten angegeben. Herstellung ohne Einsparmöglichkeit betrüge demnach ≈ 458,78 EUR.
Das im Rahmen dieses Projektes hergestellte Antriebssystem lag mit 264,75 EUR gut unterhalb des fest gesetzten Preisrahmens von 300 EUR und mit rund 58 % deutlich unterhalb der geschätzten Kosten von 458,78 EUR. Dies konnte allerdings nur realisiert werden, indem bereits vorhandene Aluminiumhalbzeuge genutzt und von einfacher und allem voran kostenfreier Möglichkeit des FDM-Drucks und der CNC-Fräsbearbeitung Gebrauch gemacht wurde. Das Kostenniveau extern gefertigter Druckteile wäre zwar mit 23,03 EUR als vergleichsweise moderat zu beschreiben, um unterhalb der Preisobergrenze zu bleiben war die Ersparnis der Fertigungs- und Materialkosten der Motorhalterung von 170 EUR jedoch maßgeblich¹⁶

15 Die tatsächliche Geschwindigkeit konnte leider nicht festgestellt werden.
16 Kostenvoranschläge für Druck- und Frästeile wurden jeweils unter online www.pcbway.com eingeholt.
22 von 29 | Studienbereich Angewandte Physik & Medizintechnik

Tabelle 6.1: Kostenaufstellung der Einzelteile. Da nicht alle Teile gekau werden mussten, sind, wo zutreend, Schätzwerte angegeben und mit “*” gekennzeichnet.

Teil | Kosten
Druckteilea | *23,03 EUR
Nur Material | 0,86 EUR
Motorhalterungena | *170 EUR
Motoren | 177 EUR
Schrauben | *3 EUR
Steckverbinder | 2 EUR
Rollenb | 34,75 EUR
Zahnriemen | 29,40 EUR
Zahnriemenscheiben | 19,60 EUR
Gesamt | 264,75 EUR
| *458,78 EUR

a
Fertigungsangebot inklusive Material.
b
Preis für zwei Rollen.
Studienbereich Angewandte Physik & Medizintechnik | 23 von 29

## 7 Zusammenfassung

Die geforderte Maximalgeschwindigkeit konnte zwar im Leerlauf deutlich übertroen werden, im Rahmen von Feldtests unterlag sie jedoch mit einem Spitzenwert von 23,7 km h−1
leicht den geforderten

### 25 km h−1

. Da sie jedoch softwareseitig limitiert wurde und bei Erreichen der gemessenen Maximalgeschwindigkeit noch ausreichend Leistungsreserven zur Verfügung standen ist davon auszugehen, dass, mit geeignetem Personenschutz höhere Geschwindigkeiten ohne weiteres erzielt werden können.
Es ist zwar aus dem Stillstand heraus nicht möglich einen Hang hinauf zu beschleunigen, jedoch zeigte sich im Feld, dass bereits eine geringe Anfangsgeschwindigkeit etwa durch leichtes Anschieben ein Anfahren ermöglicht. So konnten Steigungen von bis zu 7,5 % noch gut befahren werden, womit die Anforderungen an das Drehmoment übertroen wurden.

Die Materialauswahl der mechanischen Komponenten kann für den Einsatzzweck als gut bezeichnet werden. Der bauartbedingte Spalt zwischen Motoransch und Rotor lässt Eindringen von feinem Staub und Schmutz in das Innere der Motoren und damit an die Wicklungen und in die Spalte zwischen Magnete und Anker zu. Um ein frühzeitiges Versagen der Motoren zu verhindern, ist für zukünftige Revisionen ein Schutz in Form eines Schildes oder Ähnlichem zu empfehlen. Da der Riemen und die gedruckten Zahnriemenscheiben keine Spuren von lokalen Schäden aufweisen erscheint ein Riemenschutz zwar nicht zwingend erforderlich, mithin lagert sich um die Motorachse allerdings eine nicht unerhebliche Menge Schmutz an. Hier bieten sich die im vorgestellten Design bereits vorgesehenen Bohrungen für eine Abdeckung gut an.

Mit einem durchaus unhandlichen Gewicht des Gesamtsystems von ≈ 17,5 kg ist anzuraten den Ladezustand im Blick zu halten. Händischer Transport über größere Strecken verbietet sich de facto und die hohe Masse erschwert manuelles Beschleunigen deutlich. Das Antriebssystem bietet lediglich bei den verwendeten Motoren – auf Kosten der Leistung – Einsparpotential bezüglich des Gewichtes. Abschließend ist zu sagen, dass das Projekt trotz mangelnder Montagefreundlichkeit ein Erfolg war und – es wird noch aktiv genutzt – ist.

## A Anhang

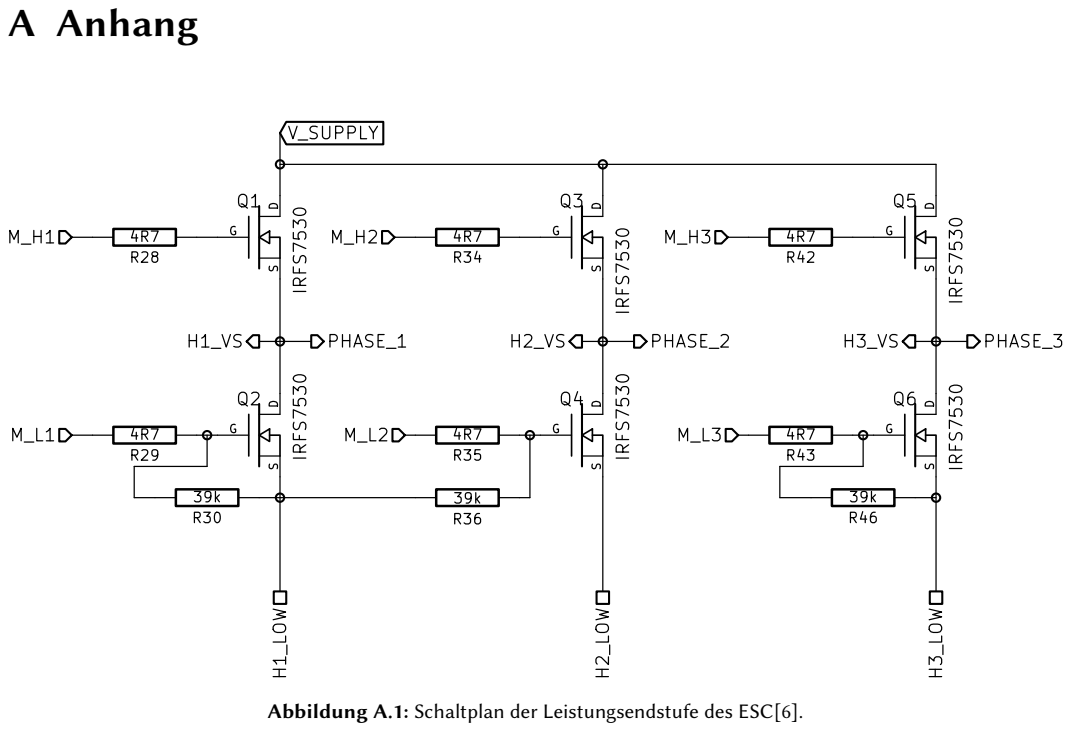
[picture p24: page 32]

Abbildung A.1: Schaltplan der Leistungsendstufe des ESC[6].

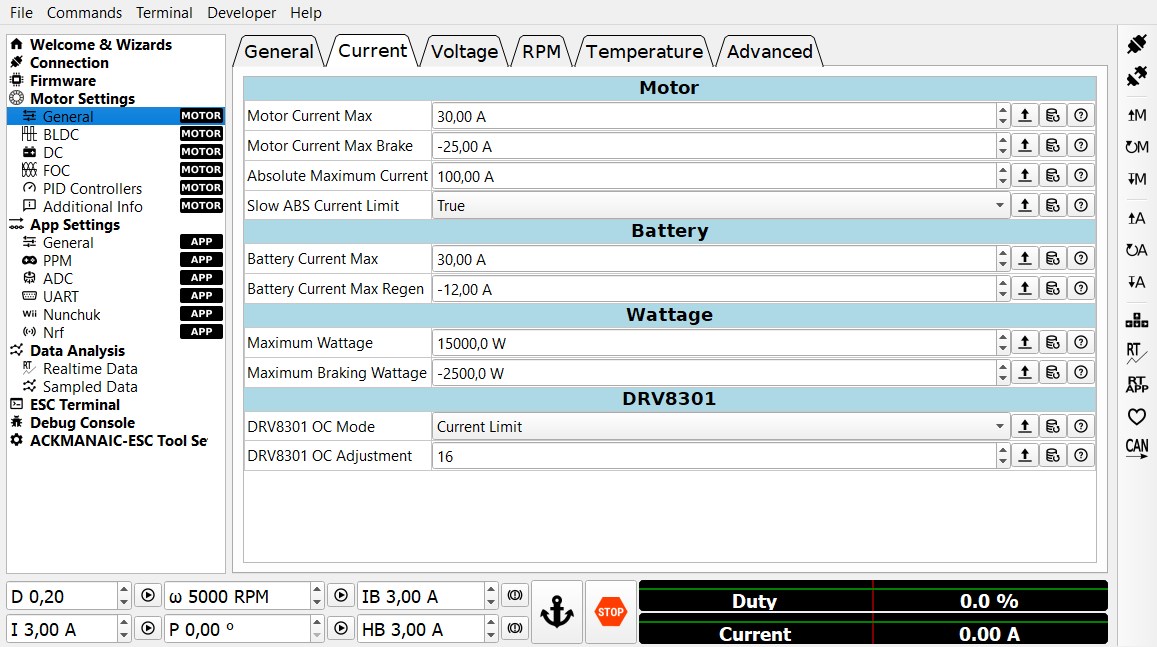
[picture p25: figure]

Abbildung A.2: Testparameter, wie sie in der Konfigurationssoware der ESC eingetragen wurden und gelten pro Motor. Einträge unter Wattage können ignoriert werden, da nicht verwendet.

26 von 29 | Studienbereich Angewandte Physik & Medizintechnik

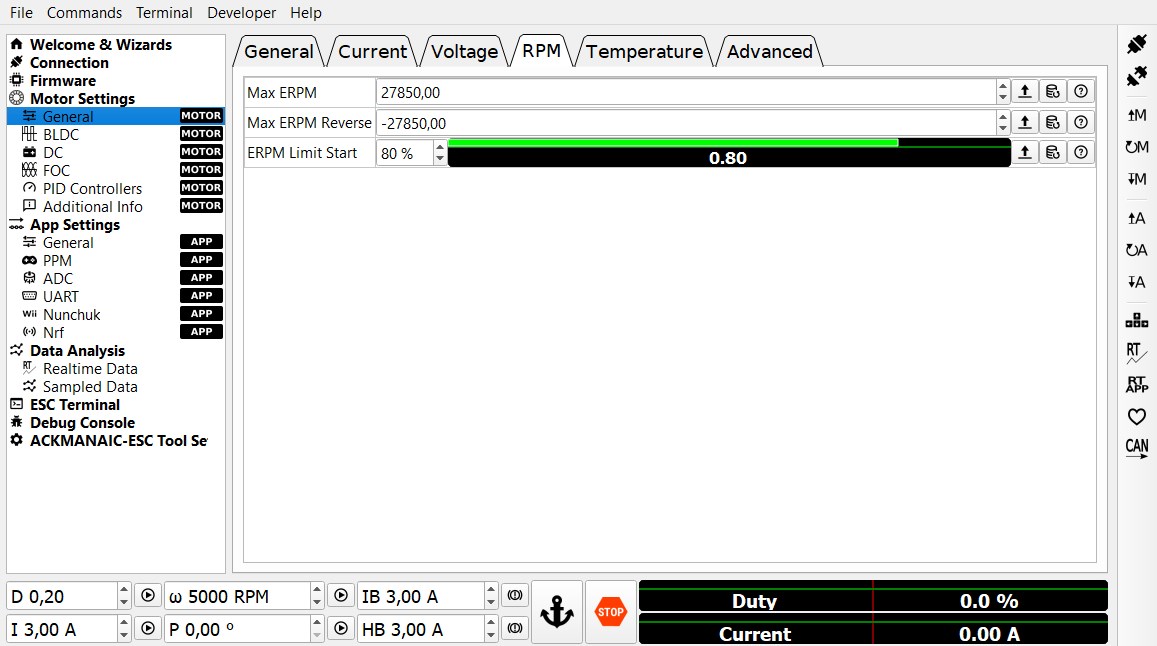
[picture p26: figure]

Abbildung A.3: In-Soware begrenzte elektrische Drehzahl. Hier mit einem Wert von 27 850 min⁻¹ .

Studienbereich Angewandte Physik & Medizintechnik | 27 von 29

## Literatur

[1] Bundesministerium für Verkehr und digitale Infrastruktur. „Bundesgesetzblatt.“ Verlag, B., Hrsg.
(14. 06. 2019), Adresse: http://www.bgbl.de/xaver/bgbl/start.xav?startbk=Bundesanzeiger_BGBl&jumpTo=bgbl119s0753.pdf (http://www.bgbl.de/xaver/bgbl/start.xav?startbk=Bundesanzeiger_BGBl&jumpTo=bgbl119s0753.pdf) (besucht am 17. 07. 2022).
[2] Statistisches Bundesamt. „Zahl der Haushalte mit E-Bikes hat sich seit 2015 fast verdreifacht, Pressemitteilung Nr. 375 vom 28. September 2020.“ (28. 09. 2020), Adresse: https://www.destatis.de/DE/Presse/Pressemitteilungen/2020/09/PD20_375_639.html (https://www.destatis.de/DE/Presse/Pressemitteilungen/2020/09/PD20_375_639.html) (besucht am 23. 07. 2022).
[3] Wan-Mook, L., Specication of Product, Lithium-ion rechargeable cell for power tools Model name : INR18650-30Q, hrsg. von Samsung SDI Co., Ltd., Energy Business Division, Version v1.0, 02. 02. 2022. Adresse: https://eu.nkon.nl/sk/k/30q-specs.pdf (besucht am 26. 07. 2022).
[4] Vedder, B. „VESC Project.“ (2022), Adresse: https://vesc-project.com/ (besucht am 29. 09. 2022).
[5] Vedder, B. „Benjamin’s robotics, VESC – Open Source ESC.“ (2015), Adresse: https://www.vedder.se (besucht am 29. 09. 2022).
[6] Vedder, B. „VESC – Open Source ESC.“ (13. 03. 2016), Adresse: https://github.com/vedderb/bldc-h ardware (https://github.com/vedderb/bldc-hardware) (besucht am 28. 07. 2022).
[7] Meschede, D., Hrsg., Gerthsen Physik, ger, 25. Auage, Springer-Lehrbuch, Meschede, Dieter (HerausgeberIn) Gerthsen, Christian (Sonstige Person, Familie und Körperschaft) Vogel, Helmut (Sonstige Person, Familie und Körperschaft), Berlin und Heidelberg: Springer Spektrum, 2015, 1047 S., isbn: 978-3-662-45977-5.
[8] Demtröder, W., Experimentalphysik 1, Mechanik und Wärme (Springer-Lehrbuch), ger, 8. Au. 2018. Berlin, Heidelberg: Springer Berlin Heidelberg, 2018, 468 S., Demtröder, Wolfgang (VerfasserIn), isbn: 978-3-662-54847-9. Adresse: http://nbn-resolving.org/urn:nbn:de:bsz:31-epflicht-1576335.
[9] Mevey, J. R., „Sensorless Field Oriented Control of Brushless Permanent Magnet Synchronous Motors,“ Magisterarb., Kansas State University, 2009. Adresse: https://krex.k-state.edu/dspace/bitstream/handle/2097/1507/JamesMevey2009.pdf (https://krex.k-state.edu/dspace/bitstream/handle/2097/1507/JamesMevey2009.pdf) (besucht am 12. 09. 2022).
[10] Ohm, D. Y., „Dynamic Model of PM Synchronous Motors,“ Drivetech Inc., Blacksburg, Virginia, Techn. Ber., 2000.
[11] Yedamal, P., „AN885, Brushless DC (BLDC) Motor Fundamentals,“ Microchip Technology Inc., Techn. Ber., 2003. Adresse: http://ww1.microchip.com/downloads/en/AppNotes/00885a.pdf (besucht am 12. 09. 2022).
[12] Joner, E. „How Brushless Motors Work and How to Test Them.“ Tyto Robotics Inc., Hrsg.
(19. 08. 2021), Adresse: https://www.tytorobotics.com/blogs/articles/how-brushless-motors-work (besucht am 28. 07. 2022).
[13] GESTIS-Stodatenbank, Deutsche Gesetzliche Unfallversicherung e.V. Adresse: https://gestis.dguv.de/data?name=080000#00336 (https://gestis.dguv.de/data?name=080000#00336) (besucht am 04. 09. 2022).
[14] van Ingen Schenau, G., „The inuence of air friction in speed skating,“ Journal of Biomechanics, Jg. 15, Nr. 6, S. 449–458, 1982, issn: 0021-9290. doi: https://doi.org/10.1016/0021-9290(82)90081-1. (https://doi.org/https://doi.org/10.1016/0021-9290(82)90081-1) Adresse: https://www.sciencedirect.com/science/article/pii/0021929082900811.
[15] Waterman, N. und Crease, A., „Skateboards — a triumph of materials technology,“ International Journal of Materials in Engineering Applications, Jg. 1, Nr. 1, S. 7–12, 1978, issn: 0141-5530. doi: https://doi.org/10.1016/0141-5530(78)90002-X. (https://doi.org/https://doi.org/10.1016/0141-5530(78)90002-X) Adresse: https://www.sciencedirect.com/science/article/pii/014155307890002X. (https://www.sciencedirect.com/science/article/pii/014155307890002X)

[16] Gates Corporation. „Gates Industrial Power Transmission, Produktkatalog.“ Version 2021. (), Adresse: https://www.gates.com/content/dam/gates/home/knowledge-center/resource-library/catalogs/industrial-power-transmission-catalogue-de-de.pdf (https://www.gates.com/content/dam/gates/home/knowledge-center/resource-library/catalogs/industrial-power-transmission-catalogue-de-de.pdf) (besucht am 11. 08. 2022).
[17] MAEDLER GmbH, Hrsg. „Catalogue 42.“ Version Edition no. 1. (2021), Adresse: https://smarthost.maedler.de/files/Katalog42_EN.zip (https://smarthost.maedler.de/files/Katalog42_EN.zip) (besucht am 14. 07. 2022).
[18] “droftarts”. „Parametric pulley - lots of tooth proles.“ (2012), Adresse: https://www.thingiverse.com/thing:16627 (https://www.thingiverse.com/thing:16627) (besucht am 02. 08. 2022).
[19] Gates Corporation. „POWERGRIP® GT®3 Drive Design manual.“ (2014), Adresse: https://www.gates.com/content/dam/gates/home/knowledge-center/resource-library/catalogs/powergripdrivedesignmanual_17195_2014.pdf (https://www.gates.com/content/dam/gates/home/knowledge-center/resource-library/catalogs/powergripdrivedesignmanual_17195_2014.pdf) (besucht am 16. 07. 2022).
[20] „DRV8302, Three Phase Gate Driver With Dual Current Shunt Ampliers and Buck Regulator – Hardware Controlled,“ Texas Instruments Inc., Techn. Ber., 2011. Adresse: https://raw.githubusercontent.com/vedderb/bldc-hardware/master/datasheets/drv8302.pdf (https://raw.githubusercontent.com/vedderb/bldc-hardware/master/datasheets/drv8302.pdf) (besucht am 28. 09. 2022).
Studienbereich Angewandte Physik & Medizintechnik | 29 von 29
