HateFindingNames/MotherBoard/pre-other-layouts.tex

%
%=====================Code Listing Layout Matlab=============================
\definecolor{codegreen}{RGB}{28,172,0} % color values Red, Green, Blue
\definecolor{codelilas}{RGB}{170,55,241}
\lstdefinestyle{matlab}{language=Matlab,%
    basicstyle=\footnotesize,%
    inputencoding=latin1,%
    breaklines=true,%
    stepnumber=2,% line numbering steps
    morekeywords={ones,height,width,datetime},% additional keywords to highlight
    keywordstyle=\color{blue},%
    frame=none,%
    identifierstyle=\color{black},%
    stringstyle=\color{codelilas},%
    commentstyle=\color{codegreen},%
    showstringspaces=false,%without this there will be a symbol in the places where there is a space
    numbers=left,%
    numberstyle={\tiny \color{black}},% size of the numbers
    numbersep=9pt,% this defines how far the numbers are from the text
}
\lstdefinestyle{python}{language=Python,%
    basicstyle=\footnotesize,%
    inputencoding=latin1,%
    breaklines=true,%
    stepnumber=2,% line numbering steps
    morekeywords={ones,height,width,datetime},% additional keywords to highlight
    keywordstyle=\color{blue},%
    frame=none,%
    identifierstyle=\color{black},%
    stringstyle=\color{codelilas},%
    commentstyle=\color{codegreen},%
    showstringspaces=false,%without this there will be a symbol in the places where there is a space
    numbers=left,%
    numberstyle={\tiny \color{black}},% size of the numbers
    numbersep=9pt,% this defines how far the numbers are from the text
}
%==============================================================================
