HateFindingNames/MotherBoard/chapters/0_top.tex

% Original author:
% Peter Wilson (herries.press@earthlink.net) with modifications by:
% Vel (vel@latextemplates.com)
%
% License:
% CC BY-NC-SA 3.0 (http://creativecommons.org/licenses/by-nc-sa/3.0/)
%
% Original found under:
% https://www.latextemplates.com/template/formal-book-title-page
\hypersetup{pageanchor=false}
\begin{titlepage}
	%------------------------------------------------
	%	Names
	%------------------------------------------------
	\ifbool{deutsch}{%
		\newcommand{\nameA}{\thefirstnameA\space\thelastnameA}
		\newcommand{\nameB}{\thefirstnameB\space\thelastnameB}
		\newcommand{\nameC}{\thefirstnameC\space\thelastnameC}
	}{%
		\newcommand{\nameA}{\thelastnameA,\space\thefirstnameA}
		\newcommand{\nameB}{\thelastnameB,\space\thefirstnameB}
		\newcommand{\nameC}{\thelastnameC,\space\thefirstnameC}
	}

	%------------------------------------------------
	%	General format
	%------------------------------------------------
	\centering
	\vspace*{\baselineskip} % White space at the top of the page
	{
		\scshape % Use small caps for all text on the title page

		%------------------------------------------------
		%	Title
		%------------------------------------------------
		\vspace*{\baselineskip} % White space at the top of the page
		\rule{\textwidth}{1.6pt}\vspace*{-\baselineskip}\vspace*{2pt} % Thick horizontal rule
		\rule{\textwidth}{0.4pt} % Thin horizontal rule
		\vspace{0.75\baselineskip} % Whitespace above the title

		{\huge \textbf{\subtitleA}}\par\vspace{0.4cm} % Title of Document
		{\huge \textbf{\subtitleB}}\par\vspace{0.4cm} % Titel des Dokuments

		\vspace{0.75\baselineskip} % Whitespace below the title
		\rule{\textwidth}{0.4pt}\vspace*{-\baselineskip}\vspace{3.2pt} % Thin horizontal rule
		\rule{\textwidth}{1.6pt} % Thick horizontal rule
		\vspace{2\baselineskip} % Whitespace after the title block

		%------------------------------------------------
		%	Subtitle
		%------------------------------------------------
		\textsc{\Large \titleLV}\vspace{0.5cm}%
		\vspace*{3\baselineskip} % Whitespace under the subtitle

		%------------------------------------------------
		%	Authors
		%------------------------------------------------
		\ifbool{deutsch}{%
			\underline{Autor}\par\vspace{0.5cm}
		}{%
			\underline{Author}\par\vspace{0.5cm}
		}
		\vspace{0.5\baselineskip} % Whitespace above the editors
		{\scshape\LARGE \nameA} % Editor list
		\vspace{0.5\baselineskip} % Whitespace below the editor list

		%------------------------------------------------
		%	Publisher
		%------------------------------------------------
		\ifbool{deutsch}{%
			Hochschule RheinMain \\ Fachbereich Ingenieurwissenschaften \\ Studienbereich Angewandte Physik \& Medizintechnik
		}{%
			Hochschule RheinMain \\ Department of Engineering \\ Applied Physics \& Medical Technology
		}
		\vfill % Whitespace between editor names and publisher logo

		\begin{center}
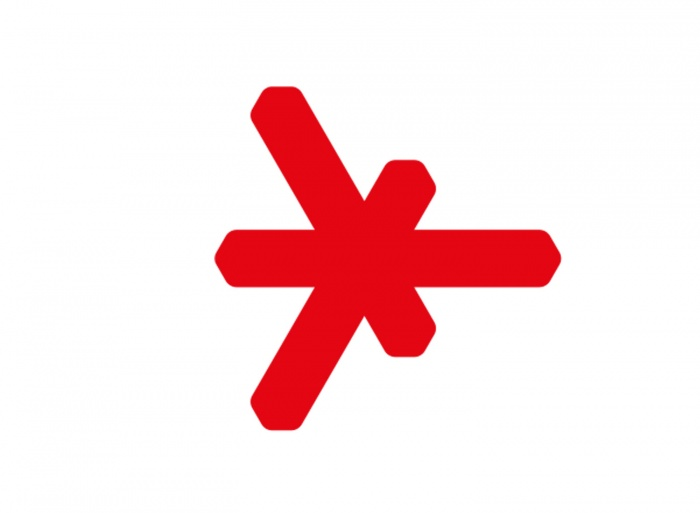
[picture p27: logo-hsrm.jpg]
			 % Logo
		\end{center}
		\vspace{0.3\baselineskip} % Whitespace under the logo
		\today % Publication year
	}
\end{titlepage}
\shipout\null%
\hypersetup{pageanchor=true}
