HateFindingNames/MotherBoard/Footage/Pictures/Battery sub-pack.jpg

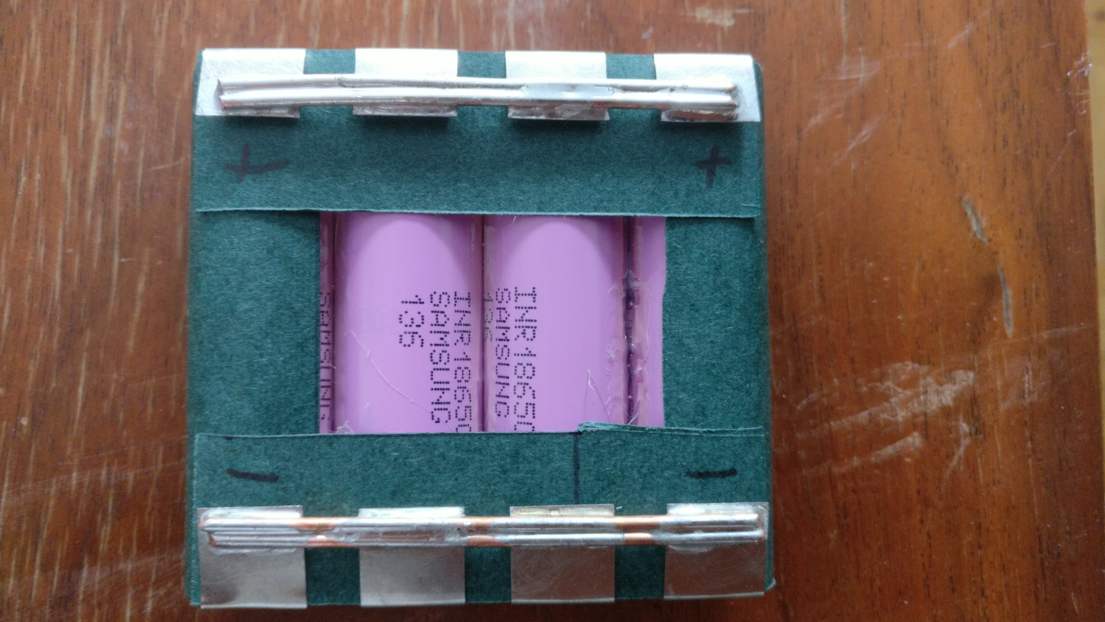
Footage/Pictures/Battery sub-pack.jpg
