HateFindingNames/MotherBoard/Footage/Pictures/Drivetrain close up v1.jpg

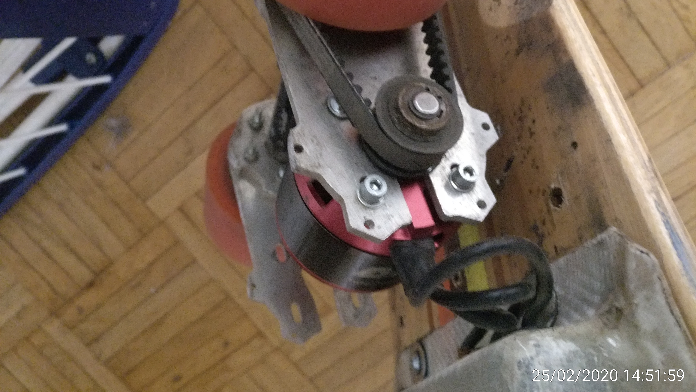
Footage/Pictures/Drivetrain close up v1.jpg
