HateFindingNames/MotherBoard/Footage/Pictures/Enclosure with pack bms connectors.jpg

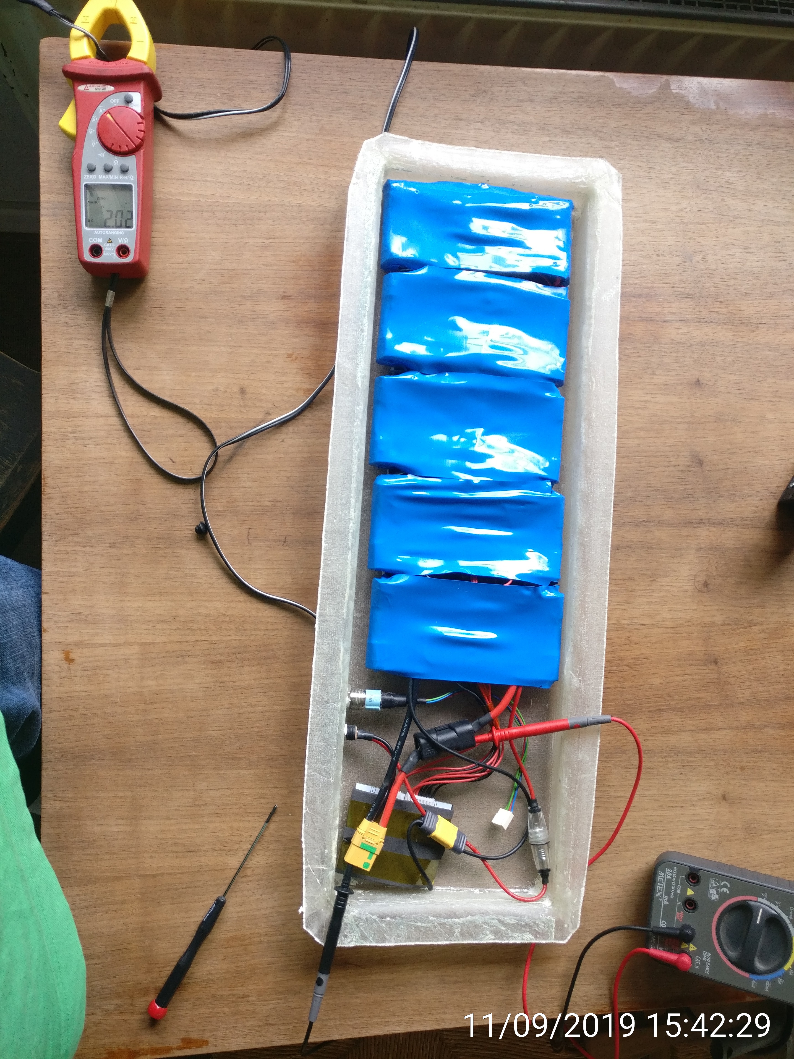
Footage/Pictures/Enclosure with pack bms connectors.jpg
