HateFindingNames/MotherBoard/Footage/Pictures/Hall sensor connector.jpg

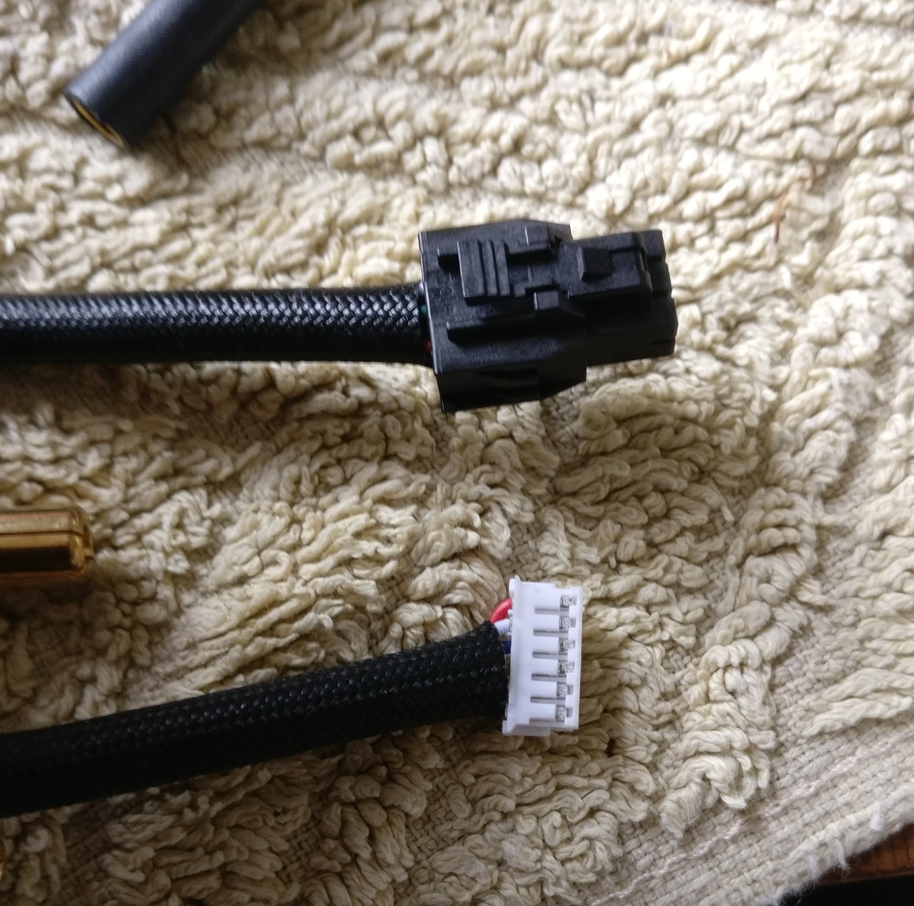
Footage/Pictures/Hall sensor connector.jpg
