HateFindingNames/MotherBoard/Footage/Pictures/Machined-HTD_tooth_fit.jpg

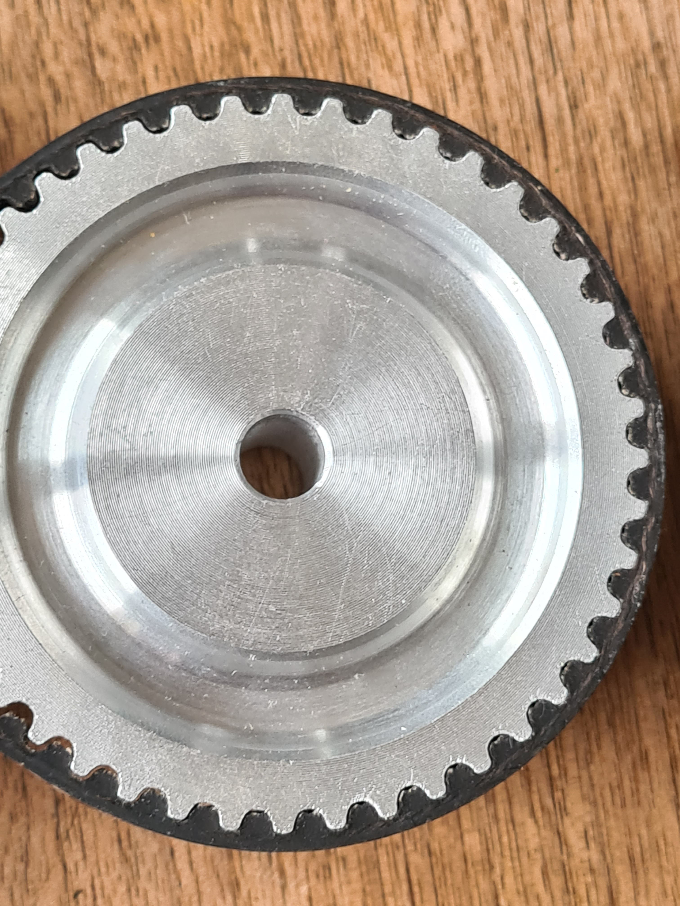
Footage/Pictures/Machined-HTD_tooth_fit.jpg
