HateFindingNames/MotherBoard/Footage/Pictures/Motor mount ground clearance.jpg

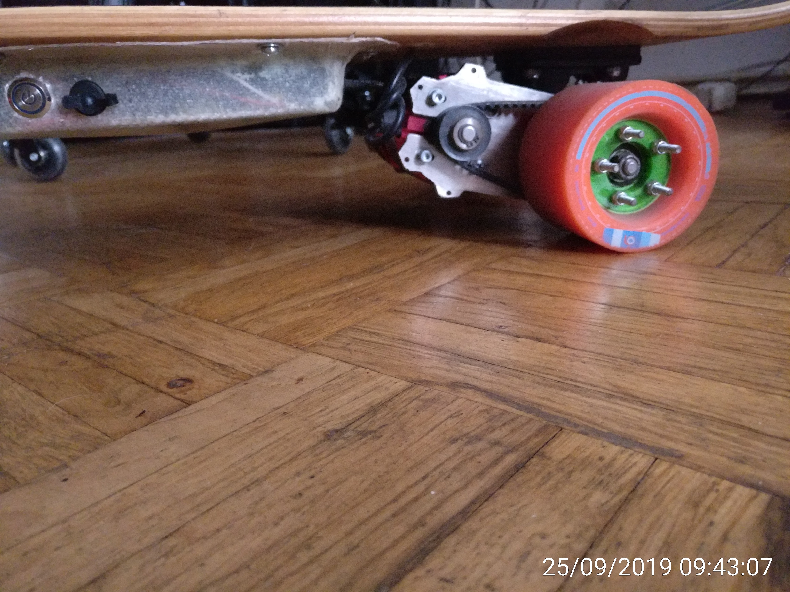
Footage/Pictures/Motor mount ground clearance.jpg
