HateFindingNames/MotherBoard/Footage/Pictures/Motor mount prototype 1.jpg

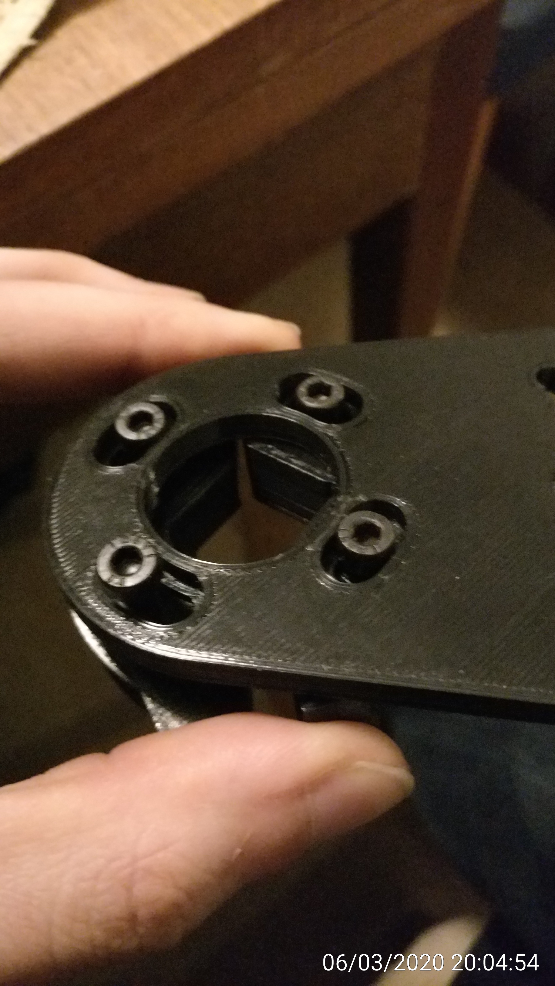
Footage/Pictures/Motor mount prototype 1.jpg
