HateFindingNames/MotherBoard/Footage/Pictures/Motor mount prototype 2.jpg

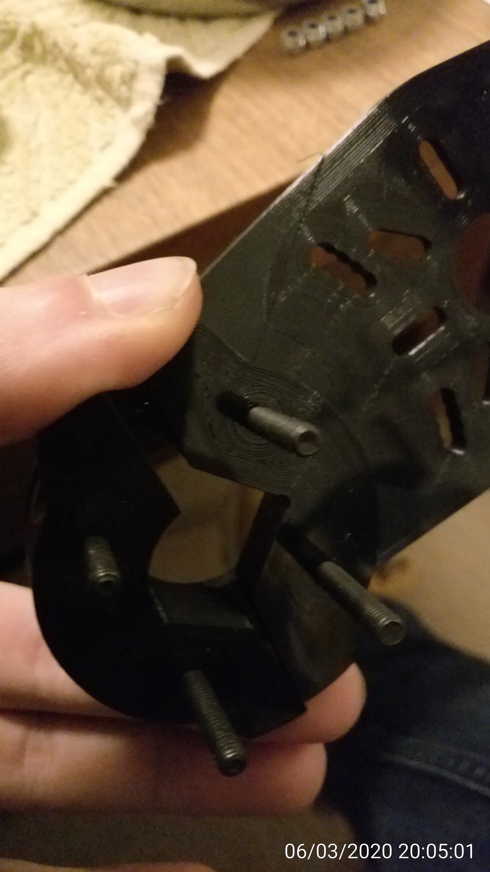
Footage/Pictures/Motor mount prototype 2.jpg
