HateFindingNames/MotherBoard/Footage/Pictures/Phase wire connectors difference.jpg

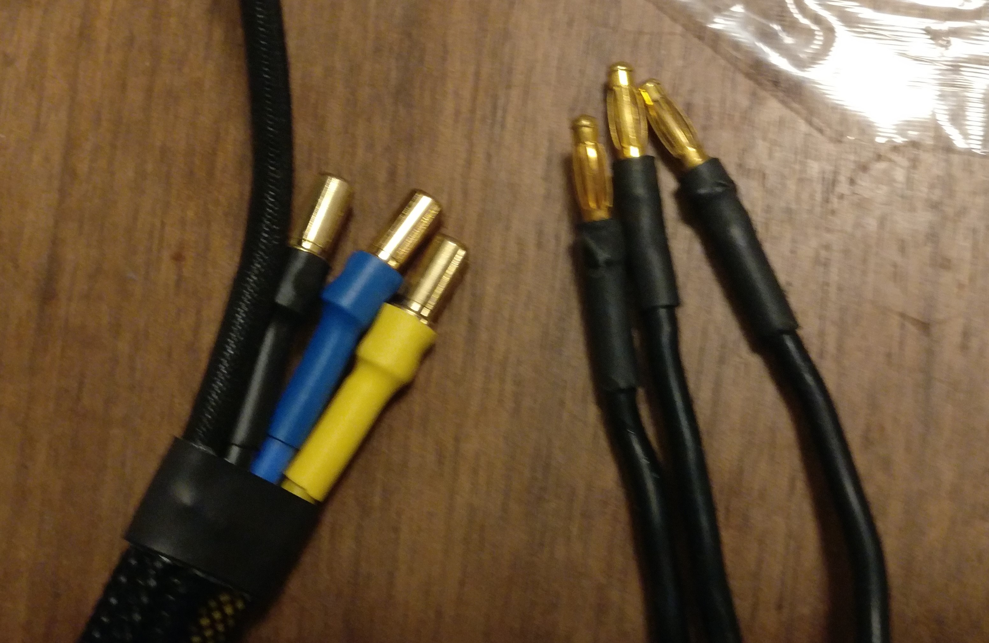
Footage/Pictures/Phase wire connectors difference.jpg
