HateFindingNames/MotherBoard/chapters/nomenclature.tex

\addchap{Nomenklatur}
    \begin{table}[h]
        \begin{tabular}{@{}ll@{}}%
            \(a\) & A letter\\
            & \\
            \(\alpha\) & Greek jibberish\\
    \end{tabular}\label{tab:Nomenclature}
    \end{table}

\addchap{Abkürzungen}
    \begin{table}[h]
        \begin{tabular}{@{}ll@{}}%
            BLDC & Brushless Direct Current \\
            ESC & Electronic Speed Controller\\
            PEV & Persönliches elektrisches Vehikel\\
            PEKV & Persönliches elektrisches Kleinstvehikel\\
            ePKW & Elektrischer Personenkraftwagen\\
            & \\
            & \\
    \end{tabular}\label{tab:acronyms}
    \end{table}
