HateFindingNames/MotherBoard/Footage/AwesomeBoard Transmission CAD/Drivetrain.SLDASM

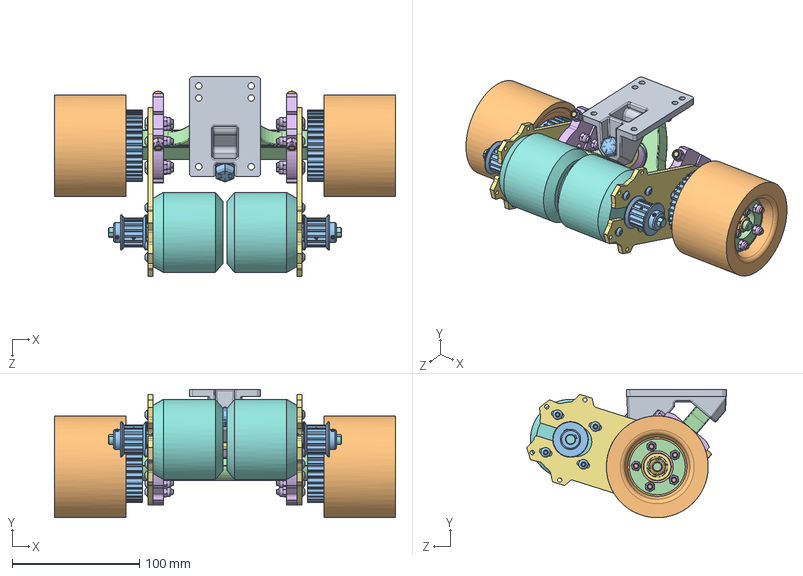
[picture p40: CAD file, 2022-10-10]
Footage/AwesomeBoard Transmission CAD/Drivetrain.SLDASM
268.0 x 100.9 x 156.8 mm
Caliber 50deg Baseplate
Pivot Cup
Kingpin
Caliber Hanger
BS Bushing
RS Bushing
RS Washer
BS Washer
Kingpin Nut
Orangatang Kegel 83mm Longboard Wheel x 2
HTD Parametric Pulley x 2
Orangatang Kegel Flat Face x 2
DIN 912 M4x60 x 10
prevailing torque nut style 1 insert_din x 24
608 Bearing x 4
Washer x 4
Spacer x 2
Axle Nut x 2
Pulley HTD 5M 15T x 2
socket set screw flat point_din x 4
parallel_din x 2
Mount - Hanger Clamp x 2
Mount - Motor Piece x 2
Motor x 2
Innensechskant M4x20 DIN EN ISO 7380-1 x 12
socket head cap screw_din x 2
socket button head screw_iso x 8
