HateFindingNames/MotherBoard/Footage/AwesomeBoard Transmission CAD/Timing Belt assembly.SLDASM

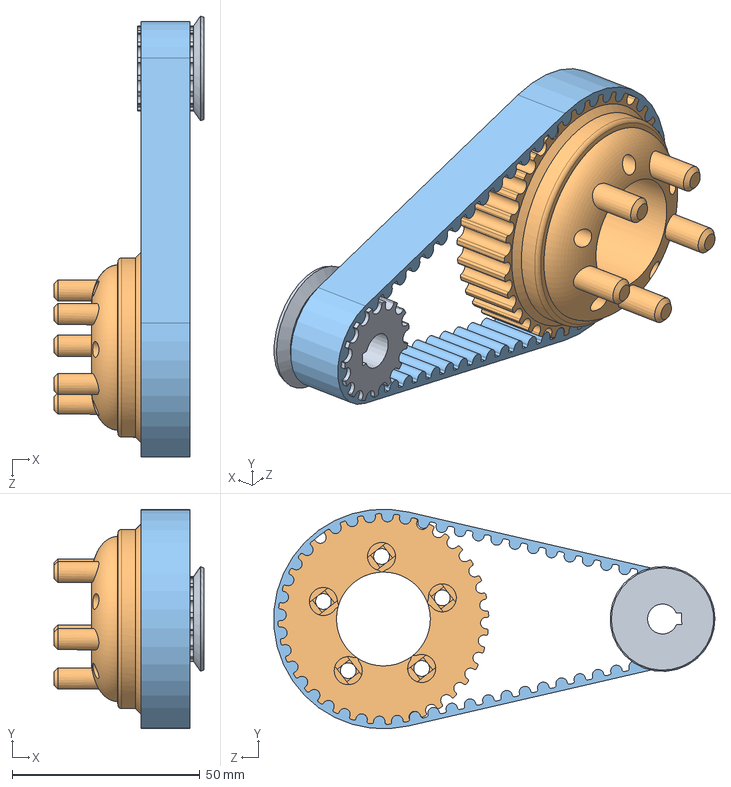
[picture p41: CAD file, 2022-09-04]
Footage/AwesomeBoard Transmission CAD/Timing Belt assembly.SLDASM
39.9 x 58.4 x 117.5 mm
Pulley HTD 5M 15T
HTD Parametric Pulley
Teil5^Timing Belt assembly
