HateFindingNames/MotherBoard/Footage/AwesomeBoard Transmission CAD/Trucks/Truck Assy.SLDASM

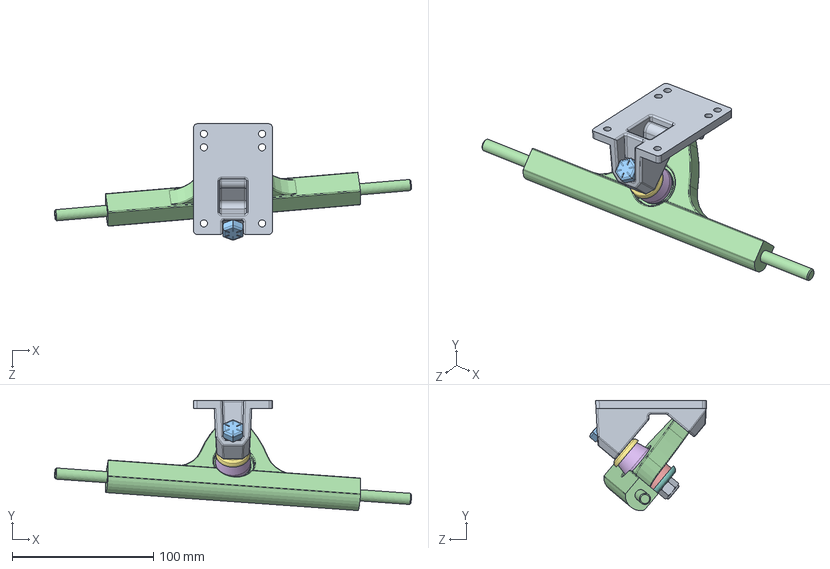
[picture p42: CAD file, 2022-07-27]
Footage/AwesomeBoard Transmission CAD/Trucks/Truck Assy.SLDASM
253.2 x 78.2 x 82.7 mm
Caliber 50deg Baseplate
Pivot Cup
Kingpin
Caliber Hanger
BS Bushing
RS Bushing
RS Washer
BS Washer
Kingpin Nut
