HateFindingNames/MotherBoard/Footage/AwesomeBoard Transmission CAD/Transmission/Wheel Assy.SLDASM

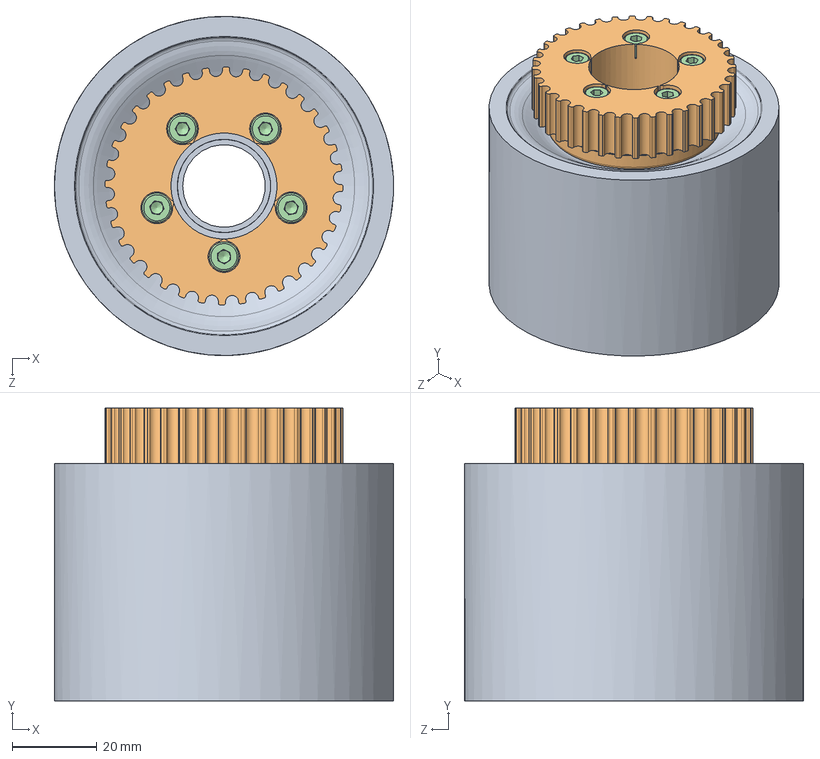
[picture p43: CAD file, 2022-07-27]
Footage/AwesomeBoard Transmission CAD/Transmission/Wheel Assy.SLDASM
80.0 x 69.0 x 80.0 mm
Orangatang Kegel 83mm Longboard Wheel
HTD Parametric Pulley
Orangatang Kegel Flat Face
DIN 912 M4x60 x 5
prevailing torque nut style 1 insert_din x 5
