HateFindingNames/MotherBoard/Footage/AwesomeBoard Transmission CAD/Hardware/passfeder 3x3.SLDPRT

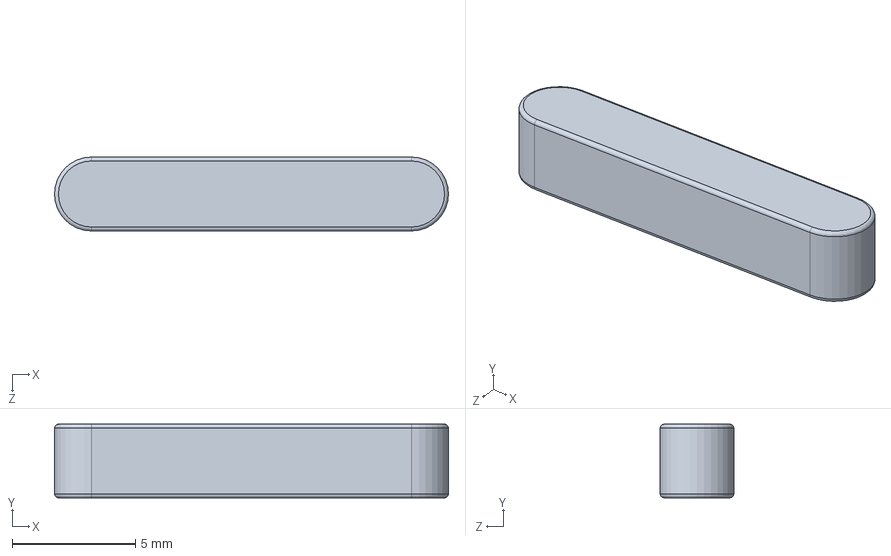
[picture p44: CAD file, 2022-09-01]
Footage/AwesomeBoard Transmission CAD/Hardware/passfeder 3x3.SLDPRT
16.0 x 3.00 x 3.00 mm
