HateFindingNames/MotherBoard/Footage/AwesomeBoard Transmission CAD/Mount/Mount - Hanger Clamp.SLDPRT

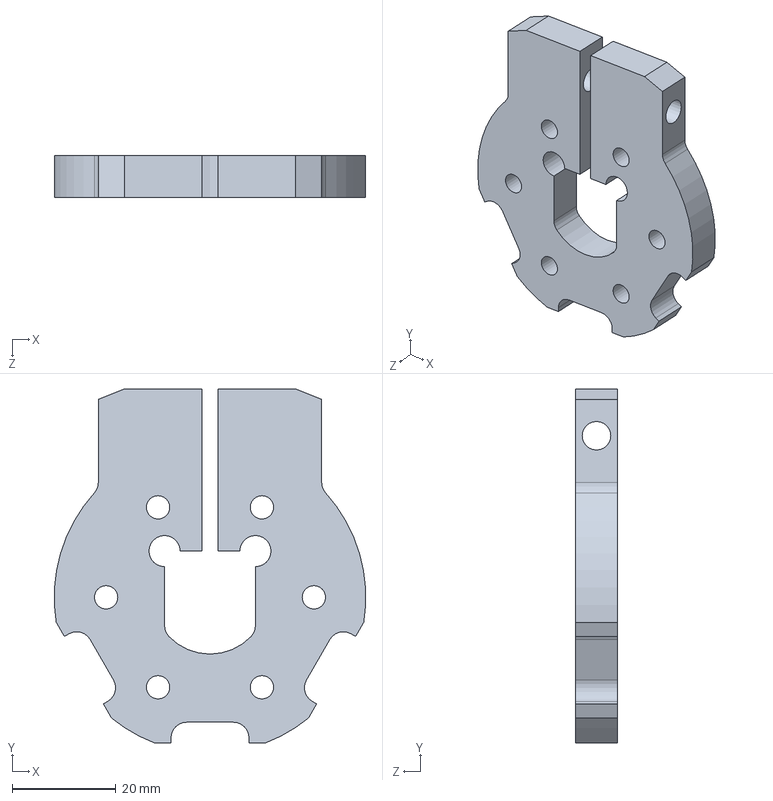
[picture p45: CAD file, 2022-09-01]
Footage/AwesomeBoard Transmission CAD/Mount/Mount - Hanger Clamp.SLDPRT
59.9 x 68.2 x 8.00 mm
