HateFindingNames/MotherBoard/Footage/AwesomeBoard Transmission CAD/Transmission/Pulley HTD 5M 15T.SLDPRT

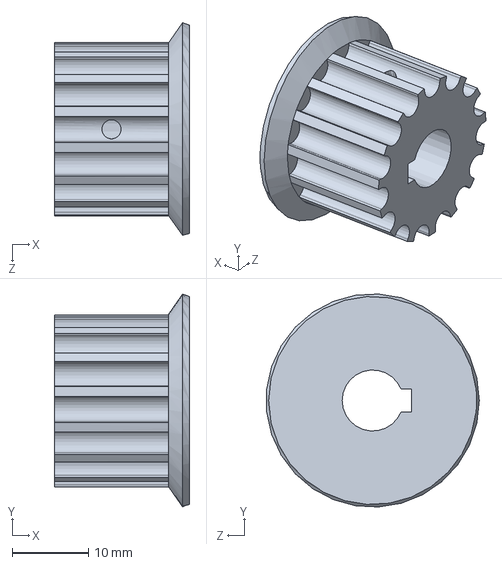
[picture p46: CAD file, 2022-09-14]
Footage/AwesomeBoard Transmission CAD/Transmission/Pulley HTD 5M 15T.SLDPRT
17.8 x 27.9 x 27.9 mm
