HateFindingNames/MotherBoard/Footage/AwesomeBoard Transmission CAD/Trucks/Caliber Hanger.SLDPRT

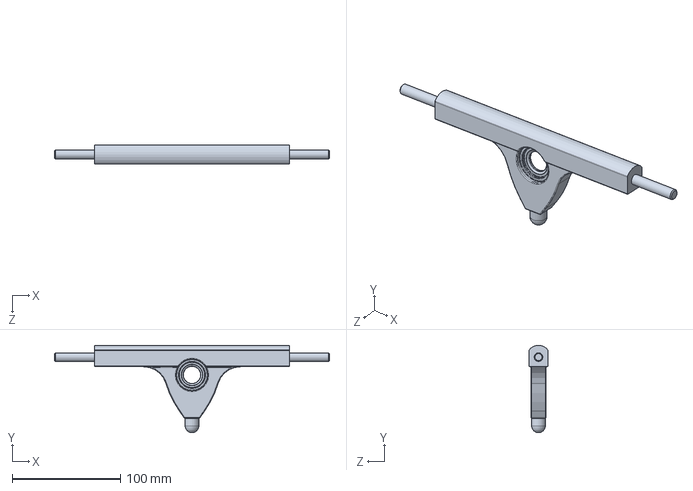
[picture p47: CAD file, 2022-09-01]
Footage/AwesomeBoard Transmission CAD/Trucks/Caliber Hanger.SLDPRT
254.0 x 80.8 x 17.8 mm
