HateFindingNames/MotherBoard/Footage/AwesomeBoard Transmission CAD/Hardware/Innensechskant M4x20 DIN EN ISO 7380-1.SLDPRT

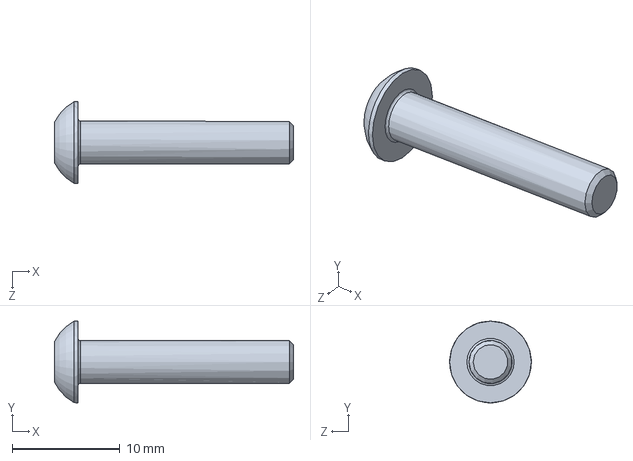
[picture p48: CAD file, 2022-09-01]
Footage/AwesomeBoard Transmission CAD/Hardware/Innensechskant M4x20 DIN EN ISO 7380-1.SLDPRT
22.2 x 7.60 x 7.60 mm
