HateFindingNames/MotherBoard/Footage/AwesomeBoard Transmission CAD/Mount/Mount - Motor Piece.SLDPRT

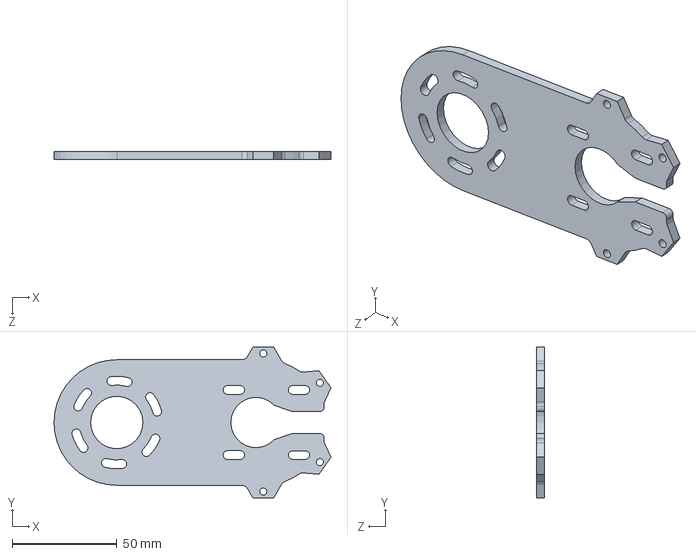
[picture p49: CAD file, 2022-09-01]
Footage/AwesomeBoard Transmission CAD/Mount/Mount - Motor Piece.SLDPRT
132.4 x 72.0 x 4.00 mm
