HateFindingNames/MotherBoard/Footage/AwesomeBoard Transmission CAD/Transmission/Motor.SLDPRT

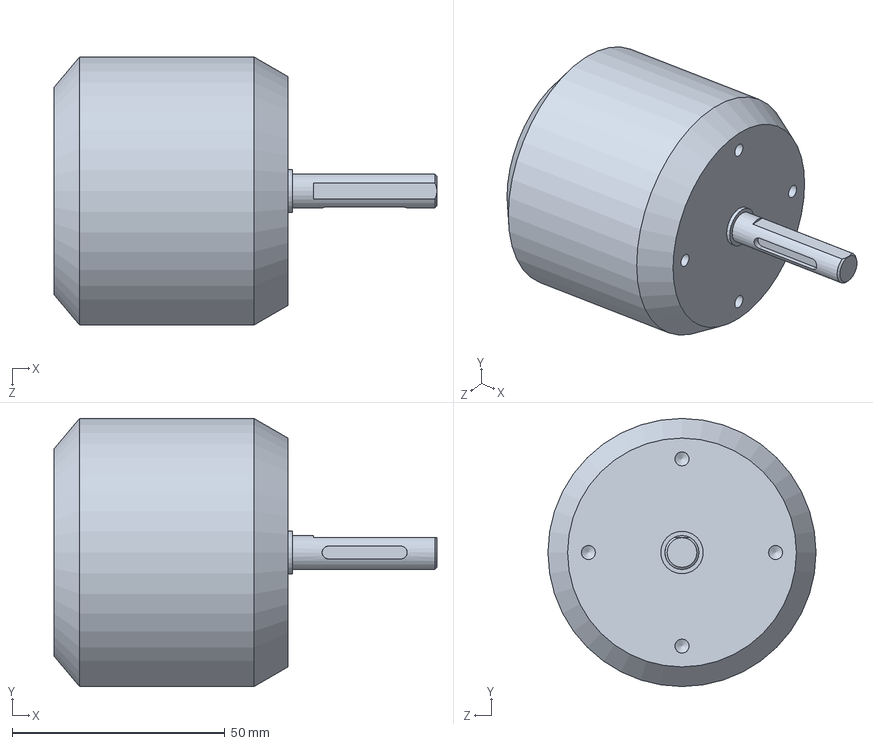
[picture p50: CAD file, 2022-09-01]
Footage/AwesomeBoard Transmission CAD/Transmission/Motor.SLDPRT
90.0 x 63.0 x 63.0 mm
