HateFindingNames/MotherBoard/Footage/AwesomeBoard Transmission CAD/Transmission/HTD Parametric Pulley.SLDPRT

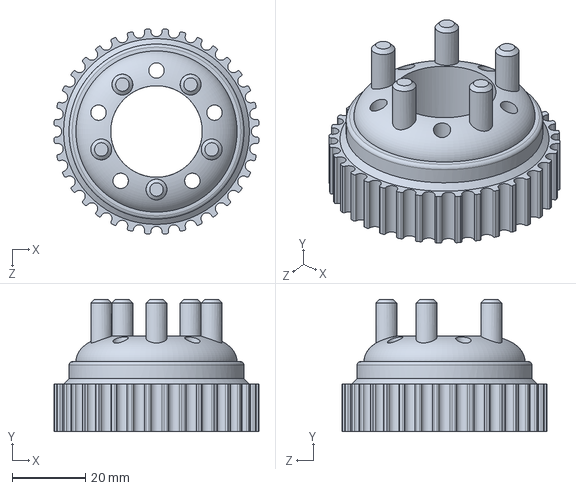
[picture p51: CAD file, 2022-07-27]
Footage/AwesomeBoard Transmission CAD/Transmission/HTD Parametric Pulley.SLDPRT
56.0 x 36.2 x 56.0 mm
