HateFindingNames/MotherBoard/Footage/AwesomeBoard Transmission CAD/Trucks/Pivot Cup.SLDPRT

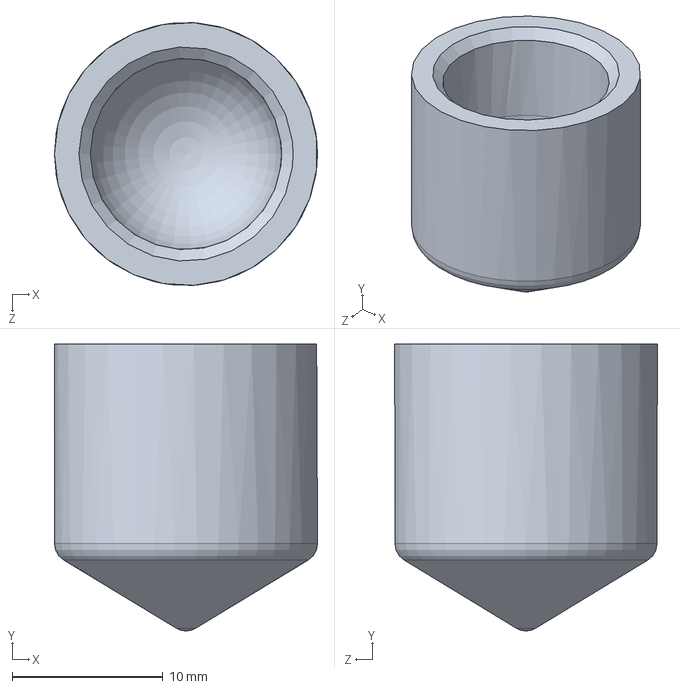
[picture p52: CAD file, 2022-07-27]
Footage/AwesomeBoard Transmission CAD/Trucks/Pivot Cup.SLDPRT
17.5 x 19.1 x 17.4 mm
