HateFindingNames/MotherBoard/Footage/AwesomeBoard Transmission CAD/Riserpad.SLDPRT

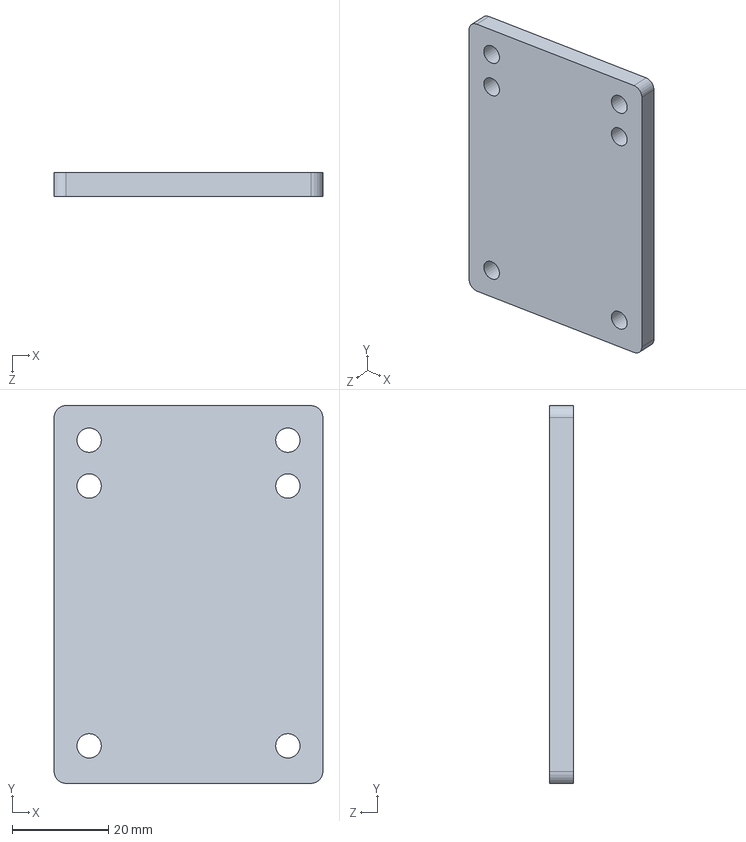
[picture p53: CAD file, 2022-07-27]
Footage/AwesomeBoard Transmission CAD/Riserpad.SLDPRT
55.9 x 78.5 x 5.00 mm
