HateFindingNames/MotherBoard/Footage/AwesomeBoard Transmission CAD/Transmission/Orangatang Kegel 83mm Longboard Wheel.SLDPRT

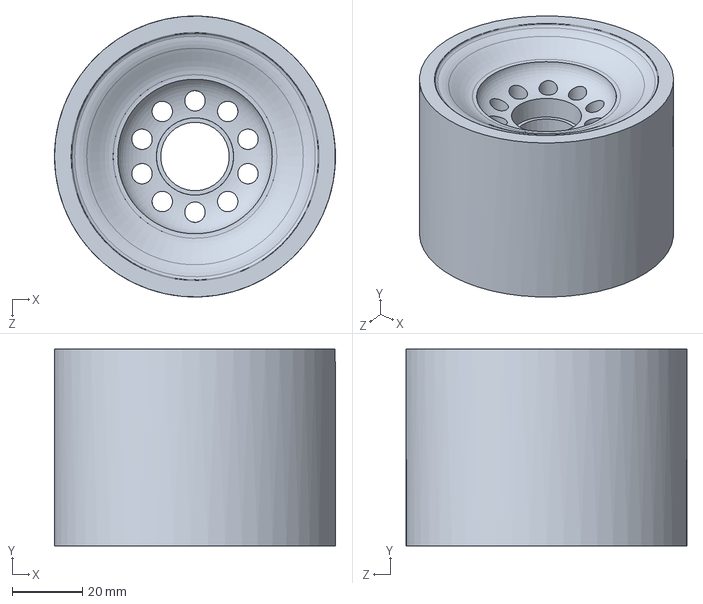
[picture p54: CAD file, 2022-07-27]
Footage/AwesomeBoard Transmission CAD/Transmission/Orangatang Kegel 83mm Longboard Wheel.SLDPRT
80.0 x 56.0 x 80.0 mm
