HateFindingNames/MotherBoard/Footage/AwesomeBoard Transmission CAD/Mutter DIN 7042 M5.SLDPRT

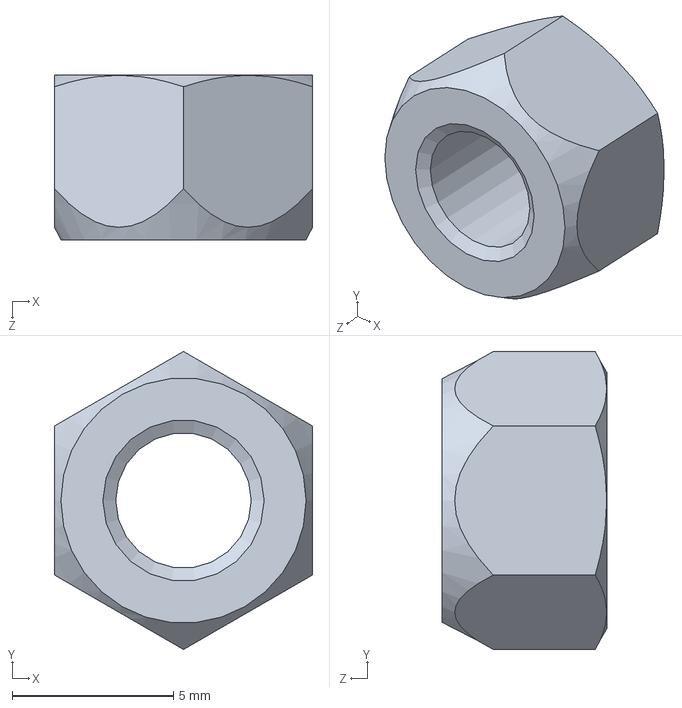
[picture p55: CAD file, 2022-07-27]
Footage/AwesomeBoard Transmission CAD/Mutter DIN 7042 M5.SLDPRT
8.00 x 9.24 x 5.10 mm
