HateFindingNames/MotherBoard/Footage/AwesomeBoard Transmission CAD/Transmission/Orangatang Kegel Flat Face.SLDPRT

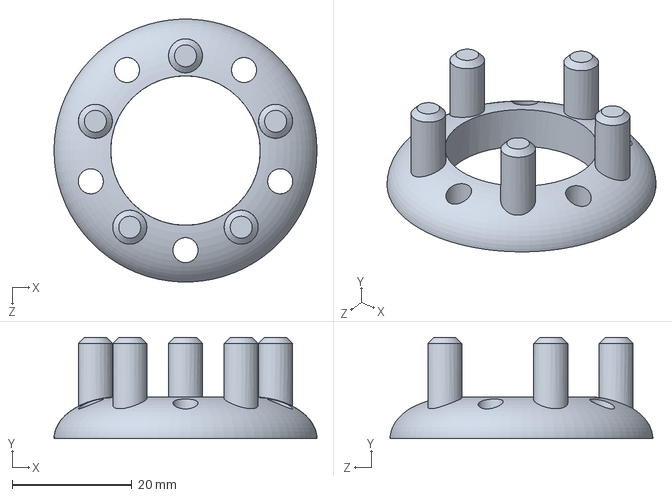
[picture p56: CAD file, 2022-07-27]
Footage/AwesomeBoard Transmission CAD/Transmission/Orangatang Kegel Flat Face.SLDPRT
44.0 x 16.9 x 44.0 mm
