HateFindingNames/MotherBoard/Footage/AwesomeBoard Transmission CAD/Innensechskant DIN 7991 M5 x 30.SLDPRT

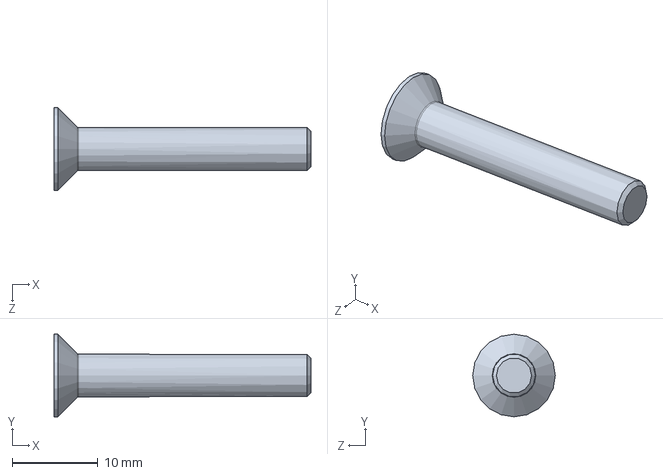
[picture p57: CAD file, 2022-07-27]
Footage/AwesomeBoard Transmission CAD/Innensechskant DIN 7991 M5 x 30.SLDPRT
30.0 x 9.64 x 9.64 mm
