HateFindingNames/MotherBoard/Footage/AwesomeBoard Transmission CAD/Spacer.SLDPRT

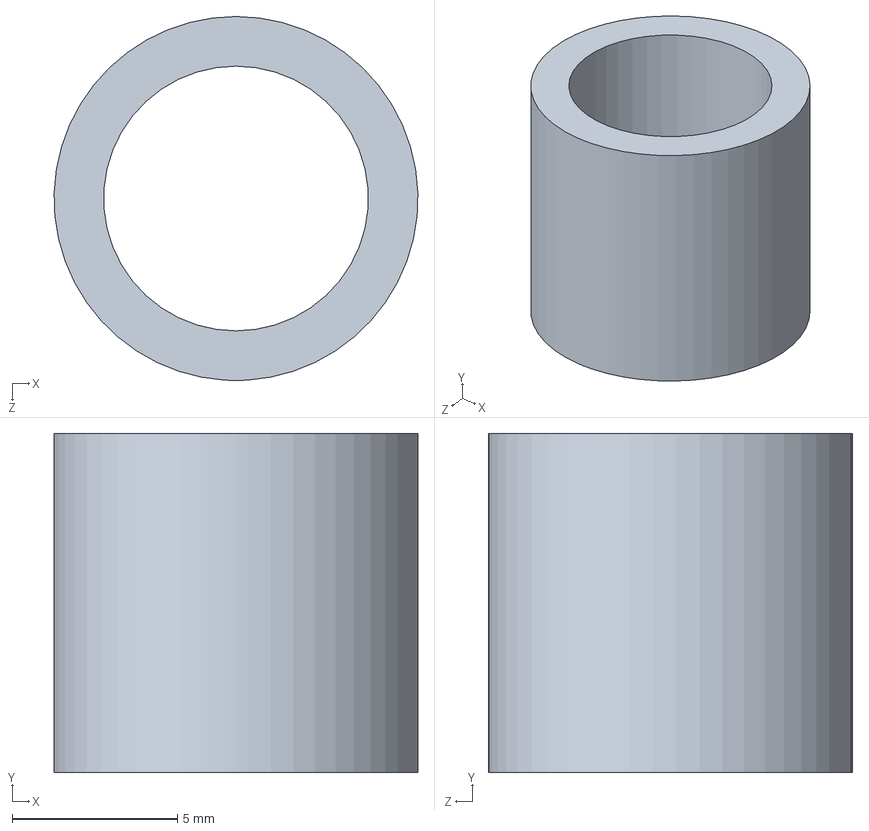
[picture p58: CAD file, 2022-07-27]
Footage/AwesomeBoard Transmission CAD/Spacer.SLDPRT
11.0 x 10.2 x 11.0 mm
