HateFindingNames/MotherBoard/Footage/AwesomeBoard Transmission CAD/Transmission/DIN EN ISO 7040 M4.SLDPRT

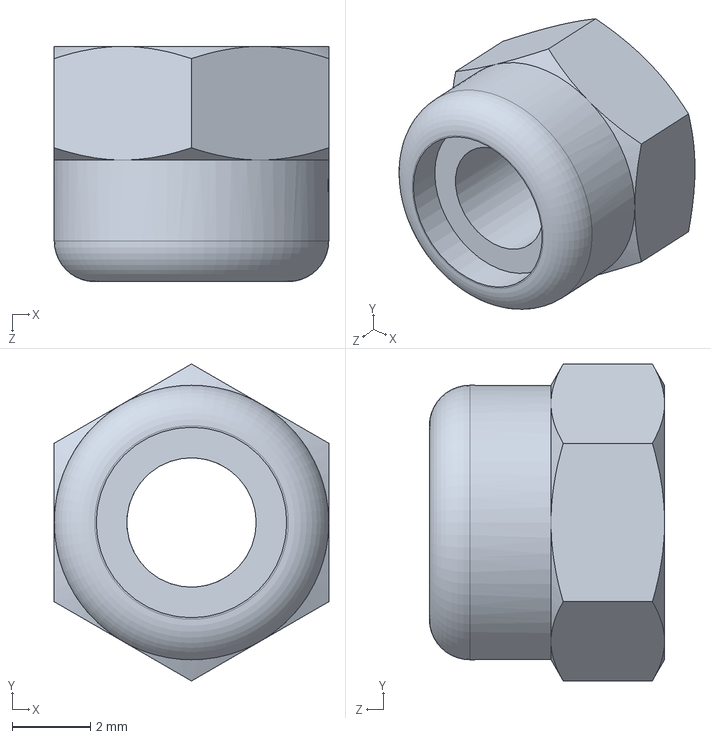
[picture p59: CAD file, 2022-07-27]
Footage/AwesomeBoard Transmission CAD/Transmission/DIN EN ISO 7040 M4.SLDPRT
7.00 x 8.08 x 6.00 mm
