HateFindingNames/MotherBoard/Footage/AwesomeBoard Transmission CAD/Trucks/RS Bushing.SLDPRT

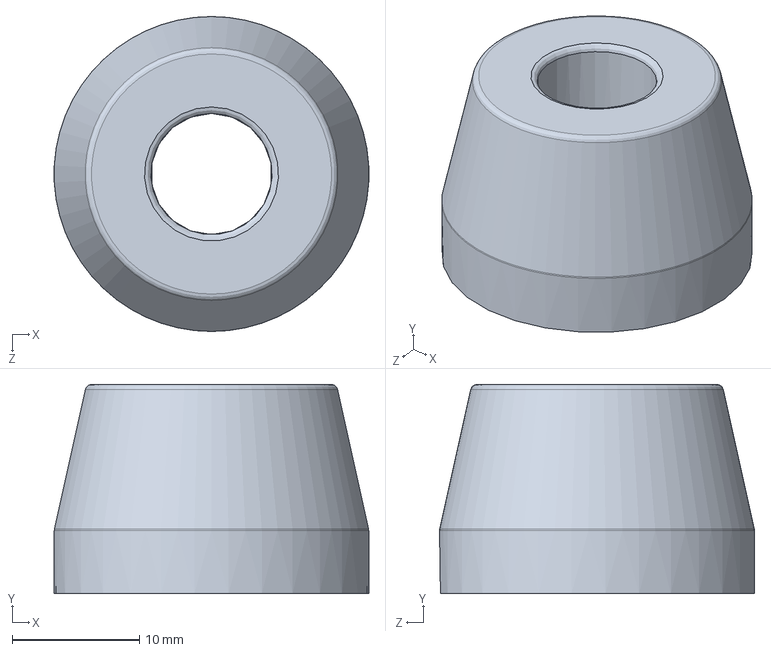
[picture p60: CAD file, 2022-07-27]
Footage/AwesomeBoard Transmission CAD/Trucks/RS Bushing.SLDPRT
24.7 x 16.4 x 24.8 mm
