HateFindingNames/MotherBoard/Footage/AwesomeBoard Transmission CAD/Deck.SLDPRT

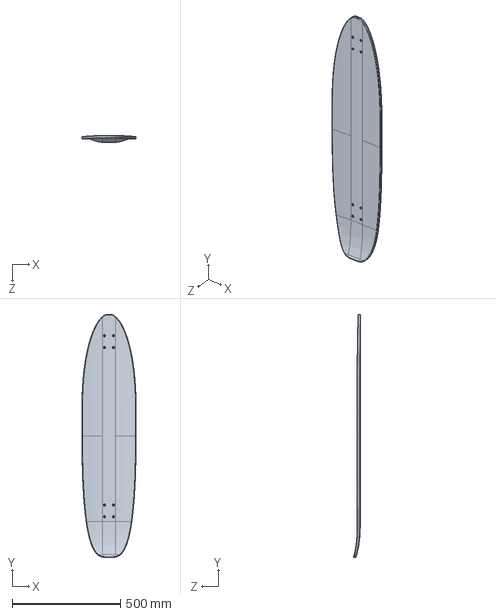
[picture p61: CAD file, 2022-07-27]
Footage/AwesomeBoard Transmission CAD/Deck.SLDPRT
250.0 x 1120.0 x 32.3 mm
