HateFindingNames/MotherBoard/Footage/AwesomeBoard Transmission CAD/Innensechskant DIN 7991 M5 x 25.SLDPRT

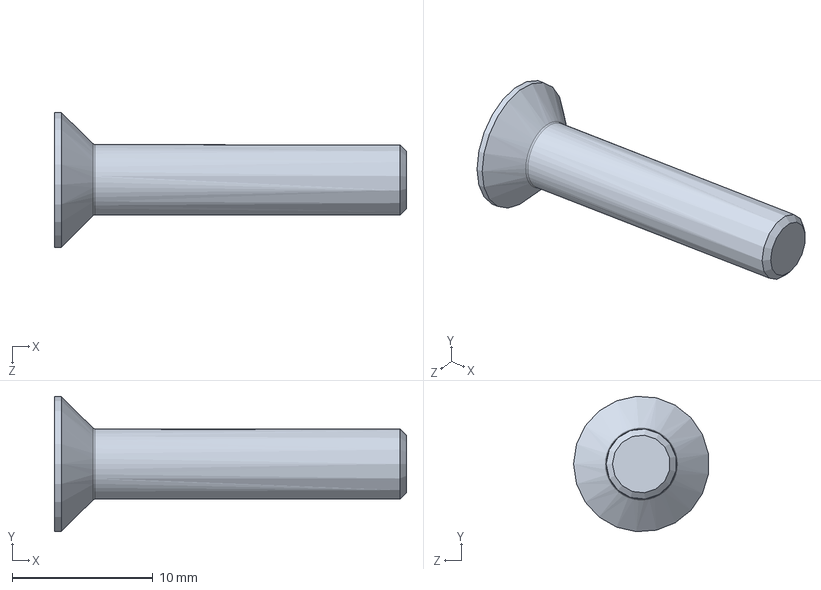
[picture p62: CAD file, 2022-07-27]
Footage/AwesomeBoard Transmission CAD/Innensechskant DIN 7991 M5 x 25.SLDPRT
25.0 x 9.61 x 9.59 mm
