HateFindingNames/MotherBoard/(list of files, cad)

Other CAD files:
Footage/AwesomeBoard Transmission CAD/Trucks/BS Bushing.SLDPRT
Footage/AwesomeBoard Transmission CAD/Trucks/Caliber 50deg Baseplate.SLDPRT
Footage/AwesomeBoard Transmission CAD/Trucks/Kingpin.SLDPRT
Footage/AwesomeBoard Transmission CAD/608 Bearing.SLDPRT
Calc/torque_incline.SLDDRW
Footage/AwesomeBoard Transmission CAD/Axle Nut.SLDPRT
Footage/AwesomeBoard Transmission CAD/Drivetrain.SLDDRW
Footage/AwesomeBoard Transmission CAD/Longboard.SLDDRW
Footage/AwesomeBoard Transmission CAD/Mount/Mount - Hanger Clamp.SLDDRW
Footage/AwesomeBoard Transmission CAD/Mount/Mount - Motor Piece - v1.SLDDRW
Footage/AwesomeBoard Transmission CAD/Mount/Mount - Motor Piece - v1.SLDPRT
Footage/AwesomeBoard Transmission CAD/Timing Belt assembly.SLDDRW
Footage/AwesomeBoard Transmission CAD/Transmission/DIN 912 M4x60.SLDPRT
Footage/AwesomeBoard Transmission CAD/Transmission/HTD Parametric Pulley.SLDDRW
Footage/AwesomeBoard Transmission CAD/Transmission/Motor.SLDDRW
Footage/AwesomeBoard Transmission CAD/Transmission/Orangatang Kegel 83mm Longboard Wheel.SLDDRW
Footage/AwesomeBoard Transmission CAD/Transmission/Orangatang Kegel Flat Face.SLDDRW
Footage/AwesomeBoard Transmission CAD/Trucks/BS Washer.SLDPRT
Footage/AwesomeBoard Transmission CAD/Trucks/Kingpin Nut.SLDPRT
Footage/AwesomeBoard Transmission CAD/Trucks/RS Washer.SLDPRT
Footage/AwesomeBoard Transmission CAD/Washer.SLDPRT
Footage/AwesomeBoard Transmission CAD/Wheels assembly.SLDDRW
