HateFindingNames/MotherBoard/Footage/Pictures/Full assembly v1.jpg

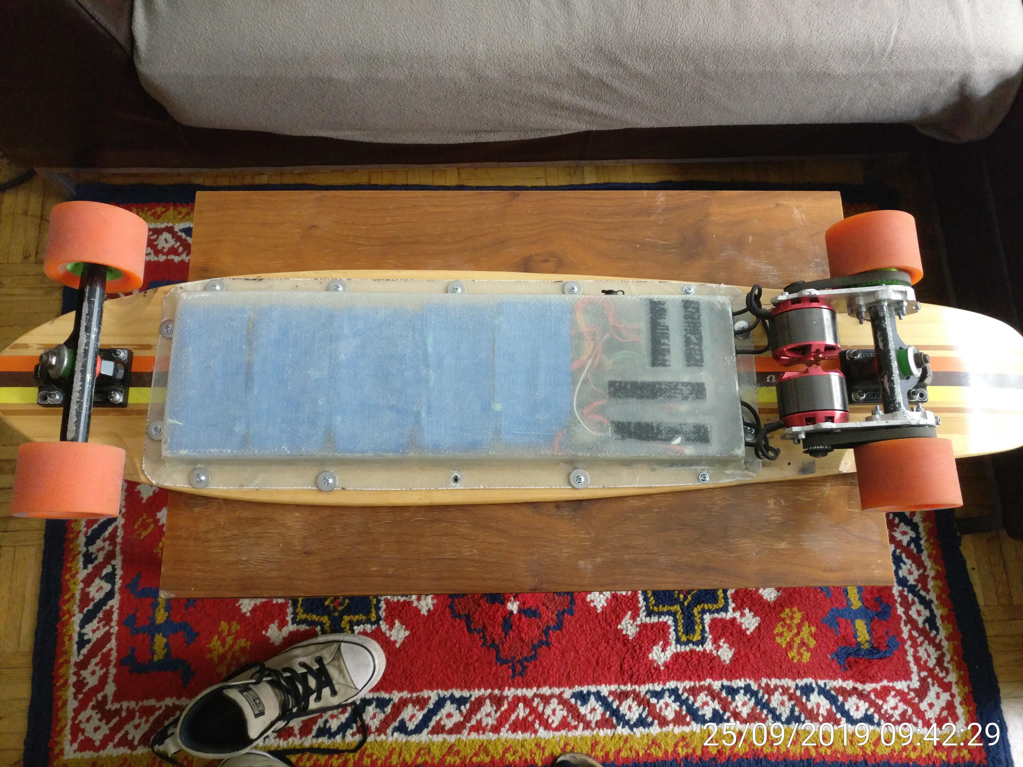
Footage/Pictures/Full assembly v1.jpg
