HateFindingNames/MotherBoard/Footage/Pictures/Full assembly v2.jpg

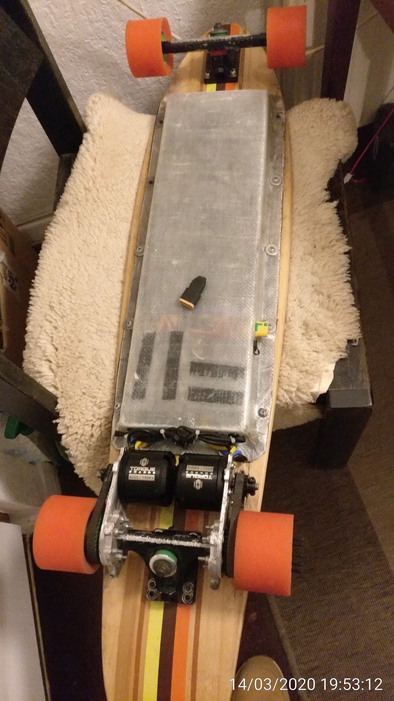
Footage/Pictures/Full assembly v2.jpg
