HateFindingNames/MotherBoard/Footage/Pictures/Printed-HTD_tooth_fit.jpg

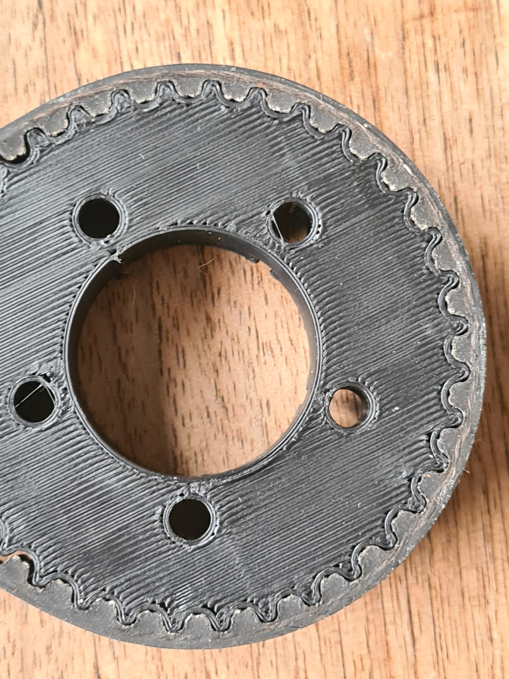
Footage/Pictures/Printed-HTD_tooth_fit.jpg
