HateFindingNames/MotherBoard/Calc/Motherboard_test-drive_esc_data.csv

//Motor_Max=30.0 | Motor_Min=-25.0 | Battery_Max=30.0 | Battery_Min=-12.0 | Cutoff_Start=30.0 | Cutoff_End=28.0 | Temp_Start=85.0 | Temp_End=100.0 | Watt_Max=15000 | Speed_Limit=25.0 | Wheelsize=80 | Motor_Teeth=15 | Wheel_Teeth=36 | Motor_Poles=14 | Battery_Cells=10 | Battery_Wh=300 | Vesc_Count=2 | Speed_Unit=0
Time | TempPcb | MotorCurrent | BatteryCurrent | DutyCycle | Speed | InpVoltage | AmpHours | AmpHoursCharged | WattHours | WattHoursCharged | Distance | Power | Fault | TimePassedInMs | Latitude | Longitude | Altitude | GPSSpeed
21_09_2022_16_07_30.753 | 29.7 | 0.00 | 0.00 | 1 | 1.1 | 37.2 | 0.002 | 0.000 | 0.092 | 0.002 | 0.294 | 0 | 0 | 189 | 0.0 | 0.0 | 0.0 | 0.0
21_09_2022_16_07_30.940 | 29.7 | 0.00 | 0.00 | -0 | -0.0 | 37.2 | 0.002 | 0.000 | 0.092 | 0.002 | 0.296 | 0 | 0 | 376 | 0.0 | 0.0 | 0.0 | 0.0
21_09_2022_16_07_31.125 | 29.7 | 0.00 | 0.00 | -1 | -0.4 | 37.2 | 0.002 | 0.000 | 0.092 | 0.002 | 0.296 | 0 | 0 | 561 | 0.0 | 0.0 | 0.0 | 0.0
21_09_2022_16_07_31.312 | 29.7 | 0.00 | 0.00 | -1 | -0.2 | 37.2 | 0.002 | 0.000 | 0.092 | 0.002 | 0.297 | 0 | 0 | 748 | 0.0 | 0.0 | 0.0 | 0.0
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
