HateFindingNames/MotherBoard/Footage/Pictures/Shorted motor point of failure.jpg

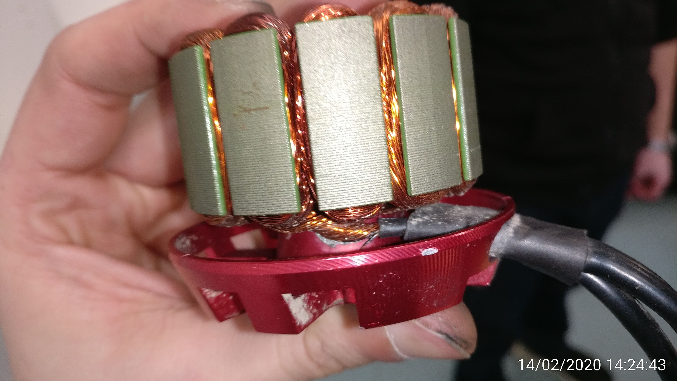
Footage/Pictures/Shorted motor point of failure.jpg
