HateFindingNames/MotherBoard/(commit log)

2022-07-27 populated chap 2
    [608 Bearing.SLDPRT, Axle Nut.SLDPRT, BS Bushing.SLDPRT, BS Washer.SLDPRT, Caliber 50deg Baseplate.SLDPRT, Caliber Hanger.SLDPRT, DIN 912 M4x60.SLDPRT, DIN EN ISO 7040 M4.SLDPRT]
2022-08-03 Explode traceline changed
    [Drivetrain.SLDASM, Drivetrain.SLDDRW]
2022-08-04 Mount drawings added
    [Mount - Hanger Clamp.SLDDRW, Mount - Hanger Clamp.SLDPRT, Mount - Motor Piece - v1.SLDDRW, Mount - Motor Piece - v1.SLDPRT]
2022-08-10 Pulley drawing added
    [HTD Parametric Pulley.SLDDRW]
2022-08-30 Drawings added/changed
    [HTD Parametric Pulley.SLDDRW, Mount - Hanger Clamp.SLDDRW, Mount - Motor Piece - v1.SLDDRW, Orangatang Kegel Flat Face.SLDDRW]
2022-08-30 Calculations spread sheet
    [calc.xlsx]
2022-09-01 New parts, drawings
    [Caliber Hanger.SLDPRT, Drivetrain.SLDASM, HTD Parametric Pulley.SLDDRW, Innensechskant M4x20 DIN EN ISO 7380-1.SLDPRT, Longboard.SLDASM, Motor.SLDDRW, Motor.SLDPRT, Mount - Hanger Clamp.SLDDRW]
2022-09-04 Calculations, plot, sketch
    [calc.xlsx, torque_incline.SLDDRW]
2022-09-04 Drawings changed, belt drawing added
    [HTD Parametric Pulley.SLDDRW, Orangatang Kegel 83mm Longboard Wheel.SLDDRW, Pulley HTD 5M 15T.SLDPRT, Timing Belt assembly.SLDASM, Timing Belt assembly.SLDDRW]
2022-09-14 Power MOSFETs schematic
2022-09-14 vesc reference added
2022-09-14 Fixed configs to make assy flexible, drawing added
    [Drivetrain.SLDASM, Longboard.SLDASM, Pulley HTD 5M 15T.SLDPRT]
2022-09-17 Plot Fdrag/Froll vs velocity
2022-09-19 Corrected T_Hang direction
    [torque_incline.SLDDRW]
2022-09-20 ESC params, plot added
    [Motherboard_free-wheeling_esc_data.csv]
2022-09-21 Fancy new plots
    [Motherboard_test-drive_esc_data.csv]
2022-10-06 fig:esc testdrive plot caption fixed
2022-10-10 pre-final 2
    [Drivetrain.SLDASM, Drivetrain.SLDDRW, Longboard.SLDASM]
