HateFindingNames/MotherBoard/Footage/Pictures/Drivetrain close up v2.jpg

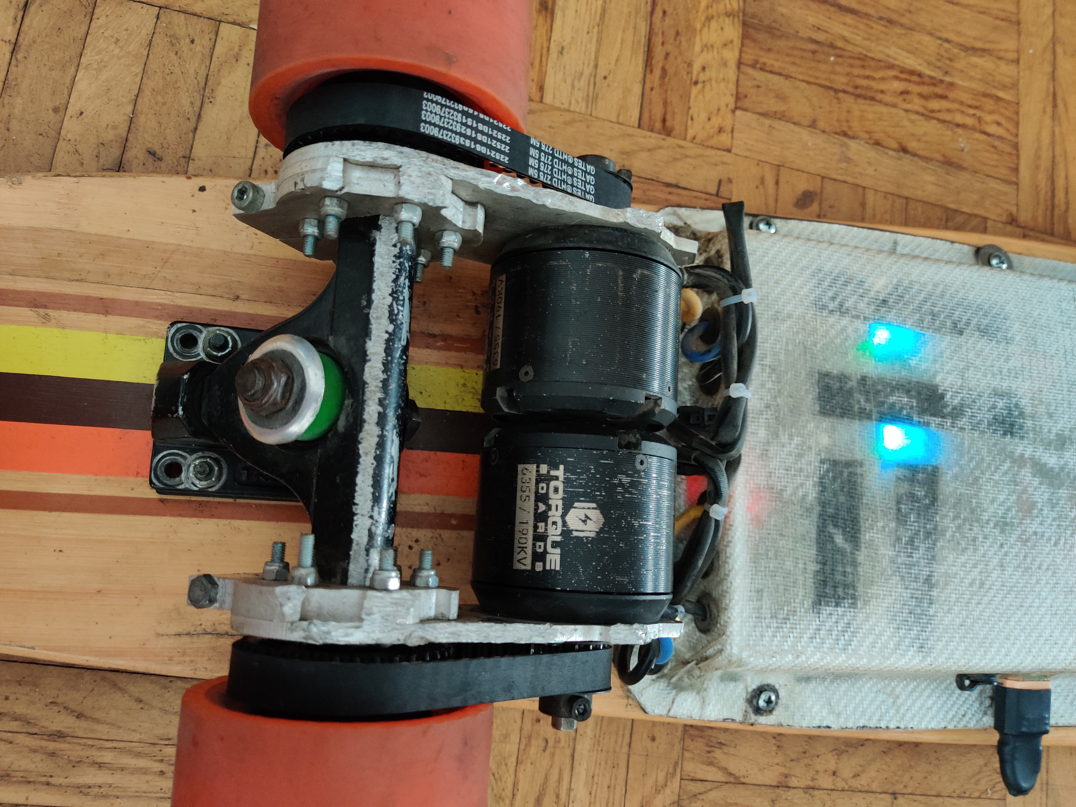
Footage/Pictures/Drivetrain close up v2.jpg
