HateFindingNames/MotherBoard/Footage/Pictures/Wheel pulley v2.jpg

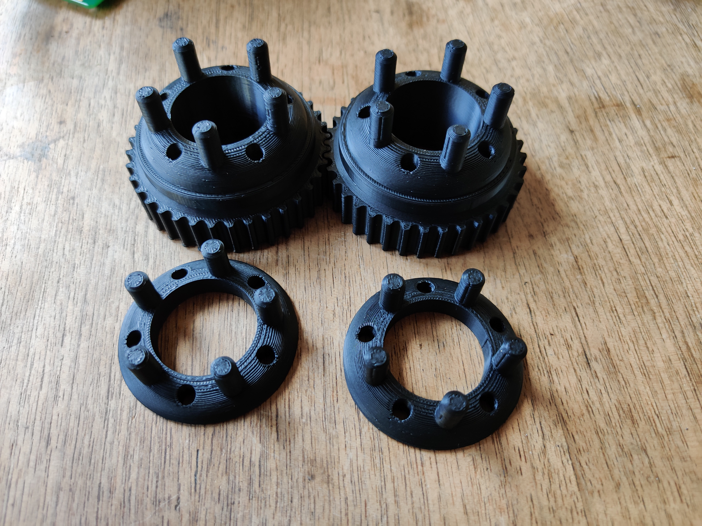
Footage/Pictures/Wheel pulley v2.jpg
